quanxian318/jianwei-vibrometer/packages/README.md

# 代码归档

jianwei_code.rar 为 RAR5 归档，包含 PS、PL、Nano、APP、仿真、技能脚本、构建工程、板端文件、使用文档、报告 LaTeX 源码、Markdown 交互记录和协作资料。硬件 CAD、海报和视频分别保存在仓库对应目录。

code_manifest.json 给出归档内各文件的 SHA-256。
