quanxian318/jianwei-vibrometer/docs/speckle/README.md

# A4 黑白随机散斑打印图

用途：裁剪后粘贴到铝片表面，供视觉位移跟踪使用。图案随铝片一起运动；它是实体随机纹理，不是投影图案。

## 打印文件

推荐使用 [asset_a74faa9be8.pdf](asset_a74faa9be8.pdf)。三页均为 210×297 mm 的 A4，每页图案区为 190×260 mm。点阵不周期重复，图案区没有标题、边框、标尺或定位图标，方便任意裁剪。每页下方的 50 mm 标尺在图案区之外。

另有单页 [2 mm 粗点打印版](asset_6ad18eb660.pdf)，适合前三档在实际图像中过细时比较。比如 1280 px 的图像对应 500 mm 宽视野，2 mm 点约占 5.1 px，0.8 mm 点仅约 2.0 px。视野尚未确定时不能保证某一档适用；点径应按下方方法选择。点变大后数量会变少，黑白面积比例仍相同，并非单纯减少黑色面积。

| 页码 | 版本 | 标称点径 | 使用方式 |
|---|---|---|---|
| 1 | 细 | 0.5 mm | 近距离或图像中纹理较大时试用 |
| 2 | 中 | 0.8 mm | 可先打印这一页，放到实际相机距离下检查 |
| 3 | 粗 | 1.2 mm | 前两档在画面中过细时试用 |

每档点径在标称值的 85%–115% 范围内随机变化，矢量黑色面积约 42%，其余为白底；黑点位置随机且不相交。PDF 和 SVG 为矢量，PNG 是从最终 PDF 渲染的 600 dpi 纯黑白文件。预览图仅供屏幕查看，不用于打印。

打印选 A4、实际大小/100%，关闭“适合页面/缩放到可打印区域”，用黑白正常或高质量模式，关闭省墨。可先只打印第 2 页。打印后测量标尺是否为 50 mm，再裁剪图案区。

优先使用薄的哑光白色自粘纸或薄纸，贴平、贴牢，避免起皱、翘边和亮面胶带覆盖图案。铝片很薄时只贴需要跟踪的小块，减少附加质量和刚度对被测振动的影响。目标与静止背景应使用不同区域裁出的图案，背景贴到合适的独立参考物上。

## 根据相机选择点径

应以算法实际输入的图像为准，而不是以显示器放大后的预览为准。相关测量厂商建议每个散斑在相机图像中约占 3–5 个像素，可作为起始选择，之后检查本项目 ROI 的纹理、相关度和跟踪结果。[Correlated Solutions 点径说明](https://www.correlatedsolutions.com/speckle-size-generator)

近似关系：`散斑像素直径 = 打印点径(mm) × 图像宽度(px) ÷ 该平面视野宽度(mm)`。例如 1280 px 对应 250 mm 宽的平面视野时，0.8 mm 点约占 4.1 px。相机距离、分辨率、后续缩放及视角变化后需重新确认。三档都太细时应增大散斑或缩小视野，三档都太粗时应减小散斑或扩大视野；不要用放大显示界面代替实际采样检查。

散斑只能改善纹理条件，不会自动消除相机晃动、运动模糊或错误采样。它不是有保证精度的标定板；下方标尺用于检查打印比例。

## 文件和复现

- `asset_d55a451fa3.svg`、`asset_7f40fd2ca4.svg`、`asset_259baf5532.svg`：A4 矢量源图，图案位置与 PDF 对应。
- 同名 `*_600dpi.png`：纯黑白 A4 图，适用于只接受图片的打印软件；仍需按 A4、100% 打印。
- `asset_48d60db71a.png`：PDF 三页的缩略预览。
- `generate_speckles.py`：固定随机种子生成脚本，使用现有 Python、NumPy、Pillow、ReportLab、pypdf、pypdfium2；中文标题使用 Windows 楷体。
- `asset_de93f3cf92.json`：每档种子、点数、矢量/栅格覆盖率、页面尺寸、输出 SHA256。

已检查 PDF 共 3 页、A4 实际尺寸、中文标题、图案区栅格覆盖率和 600 dpi 输出尺寸；已查看 PDF 渲染版。散斑靶已用于整机振动测量，实测结果见 data/measurement_20261104.json。
