quanxian318/jianwei-vibrometer/hardware/netlists/README.md

# 网表文件怎么用

## 原始导出

本目录直接保存用户提供的5个文件，内容和文件名未改：主载板PCB 2026-10-20 ENET；主载板原理图、前面板原理图2026-10-19各一份ENET和TEL。

ENET是JSON结构，components按器件分组，props中Designator为位号，pinInfoMap记录针号、针名、网络。TEL是同次原理图的另一种文本导出。它们不含完整PCB走线几何，也不能证明铜皮实际连通或间距符合规则。

## 最新工程提取

两个PCB的连接网表JSON、逐引脚CSV和工程提取ENET均由最新.epro2内的PCB COMPONENT/PAD_NET/FOOTPRINT记录生成。前面板没有用户单独导出的PCB ENET，因此这里提供工程提取版并明确标注来源；没有冒充EDA菜单直接导出的文件。

JSON保存元件、封装和唯一电气引脚；全部物理焊盘CSV还保留重复编号的固定焊脚。主载板有808个物理焊盘记录、806个唯一元件针号；前面板57个物理焊盘、57个唯一针号。数字差别来自重复电气编号的物理焊盘，不表示漏针。

坐标单位mm，原生PCB坐标+Y向上、元件面俯视；不能直接当作背面看到的左右顺序。背面丝印和实际1脚见[主载板丝印](../../docs/carrier_pin_orientation.csv)及[逐脚接线](../../docs/wiring.md)。NC表示未连接，没有导线；GND机械固定脚仍算引脚。

## 已做的对照

最新工程两板PCB的全部863个唯一元件引脚，与用户原理图ENET逐一比较：位号、针号、网络一致。板载260个BOM位号、C编号及型号/设计值与原理图导出核对。J801的40针、Nano的30针及前面板10针按现有硬件契约检查。

这项检查没有重新计算EDA原理图图形的连接拓扑，也没有运行ERC或PCB DRC；最新原理图图形仍以原生工程打开检查。确认网表对应不等于装配、程序和实板必然正确。

## 查询示例

打开[逐引脚查询](pin_browser.html)，输入“主载板 J602”看NFC接口；输入“前面板 J101”看小板线束；输入“主载板 NANO_D2_TX”跟踪缓冲前后的实际网络。串阻、缓冲器两侧的网络不同，需要沿元件功能查看，不要把它们自动重命名为同一网。

同名自动网如$1N3、$3N14只能在对应PCB和这份版本中解释，不能跨版本猜用途。主载板J102-1=$1N3、J301-2=$3N14、J304-2=$3N28；后两者是MOS开关负端，并非GND。
