quanxian318/jianwei-vibrometer/report/project-case.md

# 见微大模型协作案例

## 双目预览与分工优化

团队围绕彩色预览、视差搜索范围与测点深度组织对照，按相同图像输入比较 PS 与 PL 结果。早期 PL 双目阶段完成 83 组逐位核对，零差异。整机资源调整后，辅助深度迁至 PS 的 160×90 Census 与两路径 SGM，PL 集中处理视频、声学与外设时序。

沉淀方法包括固定输入、绑定距离和相机配置、比较算法与显示结果，以及按功能范围统计资源。对应入口为[分工评审](../skill/partition_review/README.md)和[双目验证](../sim/reference/stereo/README.md)。

## 标定、基线与报警

标定比例用于像素到毫米的换算，停机基线用于区分设备振动与背景。团队按停机采基线、启动电机、测量、判级和打印组织完整操作。2026-11-04 实测中，峰峰值 0.2090 mm 高于 0.02 mm 报警阈值，红灯、蜂鸣器、语音与手机 APP 同步报警。

沉淀方法包括保存标定与布局信息、按有效波形判级、回读输出状态和记录实物结果。对应[实测记录](../data/measurement_20261104.json)与[测量核查技能](../skill/measurement-evidence/SKILL.md)。

## 语音与打印联调

十三条语音资源统一存放在 SD 卡，支持事件与命令调用。基线成功、测量完成和报警按流程播报；音量以同一条语音的 0% 与 40% 对照确认。打印采用独立 UART、CTS 流控、每 24 行光栅分段发送、排空及 120 ms 间隔，720 行测量报告输出正常。

该流程归纳为[外设分层检查](../skill/peripheral_diagnosis/README.md)，协作提示词与回答见[交互记录](interaction_records.md)。
