quanxian318/jianwei-vibrometer/report/source/sec2_llm.tex

\subsubsection{智能体协作过程和技能包}
\label{sec:llm}

\paragraph{协作方式。}开发阶段我们使用 OpenAI Codex 编码智能体，作品视频、海报与技术报告的整理使用 Claude Code 与 Codex。队员负责提出需求和约束、接线与上下电、万用表与示波器测量、摆放被测物，以及确认屏幕、报警灯、打印纸和喇叭的实际输出；智能体负责阅读源码、原理图、实现报告和运行日志，提出可以被证伪的假设，修改代码、执行构建与测试，并整理版本和证据。是否采纳某个方案、某项功能是否算完成，由队员结合实物状态决定。

\paragraph{智能体工作流设计。}经过多轮迭代，协作固定为图~\ref{fig:agentflow} 的流程。每个节点规定输入、执行方式、产物和放行条件，失败时回到指定节点。分工上，模型负责分流和解释，脚本负责确定性的比对和检查，队员负责上板和实物结论；涉及接线和供电的动作只由队员完成，智能体不把远程命令的返回值当作物理动作已经发生。每轮结束时记录版本、命令、退出码、产物路径、验证结果和未决事项，模型提出的修改与实际采用的步骤分开登记，以保留纠错轨迹。

\begin{figure}[htbp]
\centering
\resizebox{\linewidth}{!}{%
\begin{tikzpicture}[x=1cm,y=1cm]
\node[blk=psc,minimum width=2.7cm] (n1) at (0,0) {定义任务\\验收条件、预算、基线};
\node[blk=psc,minimum width=2.7cm] (n2) at (3.4,0) {功能验证\\参考实现 vs 设备};
\node[blk=psc,minimum width=2.7cm] (n3) at (6.8,0) {实现验证\\资源、时序、约束};
\node[blk=psc,minimum width=2.7cm] (n4) at (10.2,0) {实物验收\\采样、外设、装配};
\node[blk=psc,minimum width=2.7cm] (n5) at (13.6,0) {交付\\清单与哈希};
\node[blk=espc,minimum width=2.7cm] (m) at (3.4,-1.9) {模型\\分流、解释、假设};
\node[blk=ownc,minimum width=2.7cm] (s) at (6.8,-1.9) {脚本\\比对、审计、复跑};
\node[blk=extc,minimum width=2.7cm] (h) at (10.2,-1.9) {队员\\接线、上板、实物确认};
\draw[arr] (n1)--(n2); \draw[arr] (n2)--(n3); \draw[arr] (n3)--(n4); \draw[arr] (n4)--(n5);
\draw[arr,dashed] (n2.north) -- ++(0,0.45) -| node[pos=0.25,above,lbl]{差异按键定位、修正后同输入重跑} (n1.north);
\draw[arr,dashed] (n4.north) -- ++(0,0.75) -| node[pos=0.25,above,lbl]{软件通过但实物异常：按接口层、传输层、输出层分流} (n2.north east);
\draw[thick,draw=mute] (m.north) -- (n2.south);
\draw[thick,draw=mute] (s.north) -- (n3.south);
\draw[thick,draw=mute] (h.north) -- (n4.south);
\end{tikzpicture}}
\caption{智能体协作工作流}
\label{fig:agentflow}
\end{figure}

\paragraph{协作记录。}表~\ref{tab:cases} 汇总了开发中有代表性的协作片段。提示词为队员原话，模型回答中加引号的为原话，其余为过程摘要；每个案例都给出推翻原判断的证据和修正后的结论。

\begin{table}[htbp]
\centering
\caption{代表性协作片段}
\label{tab:cases}
\footnotesize
\renewcommand{\arraystretch}{1.3}
\begin{tabularx}{\linewidth}{@{}L{1.4cm}L{3.5cm}YL{3.1cm}@{}}
\toprule
\tabhead \tabh{主题} & \tabh{队员提示词} & \tabh{模型回答与纠错} & \tabh{结论与沉淀} \\
\midrule
资源划分 & “我们不打算用深度主负责测量了，双目深度只是一个辅助功能” & 依据实现报告精简独立 PL 深度核，保留双路采集、三路 VDMA、显示、PDM 和灯光链路，深度迁到 PS；资源按功能阶段分别列出，不当作同条件优化 & LUT 13655→8574，BRAM 41.5→30.5；沉淀为分工评审与优化对照预检 \\
频率搜索 & “你把搜索上限直接放宽到30HZ”；“不要动摄像头链路” & 先指出 45 帧/s 无法区分 30 Hz 与混叠；按约束只移除约 20.3 Hz 的旧截断，合成信号回归 7、21.6、22 Hz & 30 Hz 是搜索参数，采样边界仍约 22.5 Hz；沉淀为采样检查脚本 \\
打印输出 & “现在的Nano是新的固件，你不要改” & 为打印增加独立 UART，按 24 行分段发送，排空后间隔 120 ms，使用同一份 720 行报告复测 & 字形比例与报告输出正常；沉淀为外设分层检查清单 \\
语音播报 & “采集基线完也有语音播报声” & 对齐基线完成事件与 baseline\_done 资源，统一 SD 文件格式和播放任务回执 & 基线、测量与报警按流程播报 \\
音量控制 & 同一条语音的音量对照 & 比较 0\% 与 40\% 设置，队员确认“第一遍无声、第二遍有声” & 音量设置有效，界面提供试听入口 \\
双目预览 & 按目标距离组织图像对照 & 保存同帧彩色图像、搜索参数和匹配结果，按相同输入比对计算 & 距离参考与彩色预览正常，保留版本化验证记录 \\
报警链路 & 测量框调整后的标定与基线操作 & 区分尺标比例和停机基线，按停机、采基线、启动、测量和判警执行；队员确认“红灯亮，蜂鸣器响” & 报警灯、蜂鸣器、语音和 APP 同步输出 \\
时序复核 & “按照最新工程，这些数据应该是多少” & 读取最新布线报告：WNS +0.756 ns，同时列有 592 个无时钟项和 1132 个未约束端点 & 表述限定为“已约束路径时序通过”；沉淀为 Vivado 报告审计脚本 \\
视频时长 & “然后把控一下时长，控制在3分钟。” & 同步编排场景、原声和旁白，按最终时长封装并用 ffprobe 检查 & 完整视频 179.633 s \\
\bottomrule
\end{tabularx}
\end{table}

频率搜索参数的协作记录如下。

\begin{notebox}[频率搜索范围：提示与执行结果]
\small
\textbf{队员：}“你把搜索上限直接放宽到30HZ”\par
\textbf{队员：}“不要动摄像头链路，就单纯放宽那个上限，不要出现测到了对的频率又被舍去的情况”\par\smallskip
\textbf{执行摘要：}保留相机采集链路，将软件搜索参数设为 30 Hz，结合实测采样率和奈奎斯特边界检查选择有效频点。\par
\textbf{验证结果：}7 Hz、21.6 Hz 和 22 Hz 合成位移在两个初始相位下通过频率与幅值检查，采样连续性和基线采样率检查一并执行。
\end{notebox}

语音联调统一了资源文件、事件映射和播放回执。基线成功后播放 baseline\_done，测量完成与报警采用对应提示。音量使用同一条语音的 0\% 与 40\% 对照确认，SD 文件读回校验和现场播放结果一并归档。打印采用分段光栅传输，720 行报告输出正常。

\paragraph{技能包的提炼过程。}按照赛题要求，我们把协作中反复出现的判断方法提炼为 \code{skill/} 目录下的技能包（表~\ref{tab:skills}）。每项技能保留适用任务、输入文件、执行步骤和输出格式；将常用判断写成脚本，并用正例、反例和错误输入检查退出码。这样，后续遇到相同问题时，可以直接复用已有的检查方法。

\begin{table}[htbp]
\centering
\caption{技能包内容、来源与验证}
\label{tab:skills}
\footnotesize
\renewcommand{\arraystretch}{1.28}
\begin{tabularx}{\linewidth}{@{}L{2.7cm}L{1.8cm}L{3.5cm}Y@{}}
\toprule
\tabhead \tabh{技能} & \tabh{类型} & \tabh{来源} & \tabh{已验证效果} \\
\midrule
FPGA 大模型协作 & 提示词工作流 & 全部协作案例 & 划分、契约、纠错、PPA、验收五类提示词模板与交接单 \\
软硬件划分评审 & 提示词工作流 & PL 深度核迁移 & 按功能列出资源开销，复现 LUT 13655→8574 的划分过程 \\
测量证据复核 & 提示词工作流 & 帧率混用、纹理不足、名义标定 & 从采样率、跟踪质量、基线和标定四项检查结果有效性 \\
机电装配复核 & 提示词工作流 & 预览件与打印件混用 & 打印清单与遮挡项标记与交付记录一致 \\
定点黄金比对 & 校验脚本 & 双目核 83 次 PS/PL 逐位核对 & 合成样例分别得到通过、差异与缺项、格式错误三种退出码 \\
Vivado 报告审计 & 校验脚本 & 正 WNS 被误写为“时序全部收敛” & 从报告提取资源与 WNS/WHS，并识别 592 个无时钟项 \\
采样检查 & 校验脚本 & 22 Hz 峰被 $0.45f_s$ 截断 & 45/22/30 通过并提示近边界，45/30/30 拒绝 \\
接口、优化、复现对照 & 校验脚本 & 地址表混用、跨阶段对比、版本错配 & 三组正例退出 0，反例退出 1 并指出字段，缺字段退出 2 \\
交付校验 & 校验脚本 & 打包后文件与版本错配 & 逐文件 SHA256，拒绝路径穿越与非 ASCII 文件名 \\
外设分层诊断 & 踩坑清单 & 打印分段、语音映射、音量、触屏 & 分段打印、资源校验与音量对照流程 \\
通用 PYNQ\cite{pynq} Overlay & 案例模板 + 校验脚本 & 本项目的寄存器契约与 DMA 调试经验 & 契约校验、板端测试脚本生成、HWH 实例预检、RTL 位精确仿真 \\
\bottomrule
\end{tabularx}
\end{table}

通用 PYNQ 技能围绕 Overlay、寄存器和简单模式 AXI DMA 组织。JSON 契约记录 DMA 与 IP 实例、数据类型、长度和控制偏移；脚本据此生成板端测试程序，并预检 HWH 中的实例名。配套示例提供确定性输入、黄金输出和带背压的 AXI4-Stream 测试平台，便于定位长度、TLAST 和数据排列问题。换用其他算子时修改 RTL 与黄金函数，换板时重新生成对应的 bit/HWH 文件。现有验证包含离线契约检查和 RTL 仿真。

\FloatBarrier
