quanxian318/jianwei-vibrometer/report/source/main.tex

% 见微：基于 AMD Zynq-7010 的非接触多点视觉测振仪 技术报告
% 编译：xelatex main.tex 两遍（Windows 字体：宋体、黑体、楷体、Noto Sans SC、Times New Roman、Arial、Consolas）
\documentclass[UTF8,fontset=none,a4paper,zihao=-4]{ctexart}

\setCJKmainfont{SimSun}[BoldFont=SimHei,ItalicFont=KaiTi]
\setCJKsansfont{Noto Sans SC}[BoldFont={Noto Sans SC Bold}]
\setCJKmonofont{SimHei}
\setCJKfamilyfont{kai}{KaiTi}
\newcommand{\kai}{\CJKfamily{kai}}
\setmainfont{Times New Roman}
\setsansfont{Arial}
\setmonofont{Consolas}[Scale=0.9]

\usepackage[a4paper,left=24mm,right=24mm,top=27mm,bottom=25mm,headheight=30pt,headsep=8mm]{geometry}
\usepackage{graphicx,float,placeins,booktabs,longtable,array,tabularx,multirow,makecell}
\usepackage{amsmath}
\usepackage{newtxmath}
\usepackage{bm}
\usepackage[table]{xcolor}
\usepackage{caption,subcaption}
\usepackage{fancyhdr,enumitem,tcolorbox}
\usepackage{tikz}
\usetikzlibrary{arrows.meta,positioning,shapes.geometric,shapes.misc,fit,calc,backgrounds,decorations.pathreplacing}
\usepackage{pgfplots}
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
\usepackage{listings}
\usepackage{xurl}
\usepackage[hidelinks,bookmarksnumbered]{hyperref}

% ---------------------------------------------------------------- 配色
\definecolor{navy}{HTML}{17375E}
\definecolor{ink}{HTML}{262626}
\definecolor{mute}{HTML}{6B7280}
\definecolor{axred}{HTML}{C0392B}
\definecolor{amber}{HTML}{D99A00}
\definecolor{plc}{HTML}{F7DAD6}
\definecolor{psc}{HTML}{D9E6F4}
\definecolor{espc}{HTML}{DDEFD9}
\definecolor{ownc}{HTML}{FFF0C4}
\definecolor{extc}{HTML}{EEEEEE}
\definecolor{band}{HTML}{F3F6FA}
\definecolor{rulec}{HTML}{9AA7B8}

% ---------------------------------------------------------------- 标题层级
\ctexset{
  section={name={第,部分},number=\chinese{section},format=\rmfamily\bfseries\zihao{3}\color{ink},
           aftername=\hspace{0.8em},beforeskip=2pt,afterskip=16pt},
  subsection={number=\arabic{section}.\arabic{subsection},format=\rmfamily\bfseries\zihao{4}\color{ink},
              beforeskip=16pt plus 3pt,afterskip=8pt},
  subsubsection={number=\arabic{section}.\arabic{subsection}.\arabic{subsubsection},
                 format=\rmfamily\bfseries\zihao{-4}\color{ink},beforeskip=12pt plus 2pt,afterskip=6pt},
  paragraph={format=\kai\bfseries\color{ink},runin=true,afterskip=0.6em,beforeskip=6pt}
}
\setcounter{secnumdepth}{3}
\setcounter{tocdepth}{2}
\counterwithin*{figure}{section}
\counterwithin*{table}{section}
\counterwithin*{equation}{section}
\renewcommand{\thefigure}{\arabic{section}.\arabic{figure}}
\renewcommand{\thetable}{\arabic{section}.\arabic{table}}
\renewcommand{\theequation}{\arabic{section}.\arabic{equation}}
\captionsetup{font=small,labelfont={bf,color=navy},labelsep=quad,skip=6pt}
\captionsetup[sub]{font=footnotesize,labelfont={bf},skip=3pt}
\renewcommand{\arraystretch}{1.25}
\setlength{\parskip}{2pt plus 1pt}
\linespread{1.32}
\setlist{nosep,leftmargin=2.2em,itemsep=2pt}
\setlength{\emergencystretch}{3em}
\raggedbottom
\makeatletter
\setlength{\@fptop}{0pt}
\setlength{\@fpsep}{12pt plus 2fil}
\setlength{\@fpbot}{0pt plus 1fil}
\makeatother
\renewcommand{\topfraction}{0.9}
\renewcommand{\textfraction}{0.08}
\renewcommand{\floatpagefraction}{0.75}

% ---------------------------------------------------------------- 页眉页脚
\newcommand{\reportheader}{%
  \fancyhf{}%
  \fancyhead[C]{}%
  \renewcommand{\headrulewidth}{0.35pt}%
  \renewcommand{\headrule}{\color{mute}\hrule height \headrulewidth}%
  \fancyfoot[C]{\small\rmfamily\color{ink}\thepage}%
}
\pagestyle{fancy}
\reportheader
\fancypagestyle{plain}{\reportheader}

% ---------------------------------------------------------------- 常用样式
\newcommand{\figpath}{figures}
\newcommand{\code}[1]{\texttt{\small #1}}
\newcolumntype{L}[1]{>{\raggedright\arraybackslash}p{#1}}
\newcolumntype{C}[1]{>{\centering\arraybackslash}p{#1}}
\newcolumntype{Y}{>{\raggedright\arraybackslash}X}
\newcommand{\tabh}[1]{\textbf{\sffamily #1}}
\newcommand{\tabhead}{\rowcolor{band}}
\newtcolorbox{notebox}[1][]{colback=band,colframe=rulec,boxrule=0.4pt,arc=1.5pt,left=8pt,right=8pt,top=5pt,bottom=5pt,
  fonttitle=\sffamily\bfseries\small,coltitle=navy,colbacktitle=band,title={#1},before skip=8pt,after skip=8pt}
\lstset{basicstyle=\ttfamily\small,columns=fullflexible,keepspaces=true,frame=single,rulecolor=\color{rulec},
  backgroundcolor=\color{band},xleftmargin=4pt,xrightmargin=4pt,aboveskip=6pt,belowskip=6pt,breaklines=true,
  showstringspaces=false}

% TikZ 公共样式：红=AX7010/PL，蓝=PS，绿=ESP32，黄=自研硬件，灰=外部设备
\tikzset{
  blk/.style={draw=#1!70!black,fill=#1,rounded corners=2pt,align=center,font=\footnotesize\linespread{1.05}\selectfont,inner sep=3pt,minimum height=8mm},
  blk/.default=extc,
  arr/.style={-{Stealth[length=2.4mm]},thick,draw=ink},
  darr/.style={{Stealth[length=2.2mm]}-{Stealth[length=2.2mm]},thick,draw=ink},
  lbl/.style={font=\scriptsize\linespread{1.0}\selectfont,text=mute},
  grp/.style={draw=#1,dashed,rounded corners=4pt,inner sep=6pt},
}

\begin{document}

% ================================================================ 封面
\begin{titlepage}
\newgeometry{left=20mm,right=20mm,top=22mm,bottom=20mm}
\thispagestyle{empty}
\noindent\makebox[\linewidth][c]{}\par
\vspace{1mm}
\noindent{\color{mute}\rule{\linewidth}{0.35pt}}\par
\vspace{11mm}
\setlength{\parindent}{0pt}
{\rmfamily\bfseries\color{ink}\fontsize{32}{40}\selectfont 见微\par}
\vspace{4mm}
{\rmfamily\bfseries\color{ink}\zihao{-2} 基于 AMD Zynq-7010 的\\[2mm]非接触多点视觉测振仪\par}
\vspace{3mm}
{\rmfamily\color{ink}\normalsize JianWei: Non-contact Multi-point Vision Vibrometer on AMD Zynq-7010\par}
\vspace{10mm}
{\rmfamily\bfseries\color{ink}\zihao{3} 技术报告\par}
\vspace{10mm}
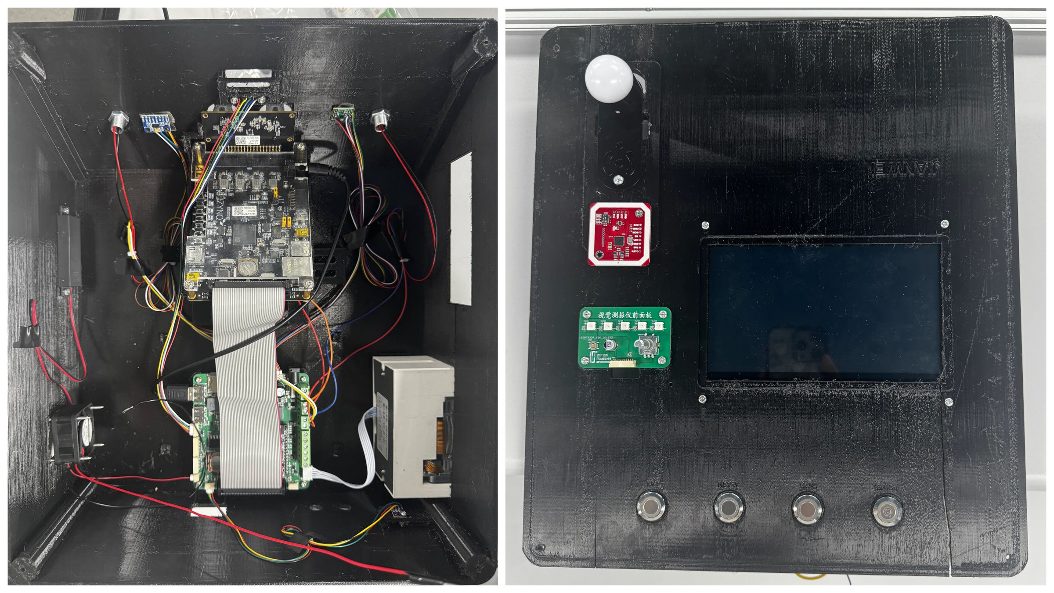
[picture p60: report/source/figures/photo/overview.jpg]
\noindent\par
\vfill
{\sffamily\small\color{ink}
\begin{tabular}{@{}ll@{}}
核心器件 & AMD Zynq-7000 XC7Z010（ALINX AX7010） \\
开源地址 & \url{https://github.com/quanxian318/jianwei-vibrometer} \\
日\qquad 期 & 2026 年 11 月 \\
\end{tabular}\par}
\restoregeometry
\end{titlepage}

% ================================================================ 摘要
\pagenumbering{Roman}
\thispagestyle{plain}
\begin{center}{\rmfamily\bfseries\zihao{3}\color{ink} 摘\quad 要}\end{center}
\vspace{2mm}
\input{sec0_abstract}

\clearpage
\thispagestyle{plain}
{\hypersetup{linkcolor=ink}\tableofcontents}
\clearpage
\pagenumbering{arabic}

\input{sec1_overview}
\input{sec2_system}
\input{sec2_hardware}
\input{sec2_software}
\input{sec2_llm}
\input{sec3_results}
\input{sec4_summary}

\end{document}
