quanxian318/jianwei-vibrometer/skill/mechanical-fit/SKILL.md

---
name: mechanical-fit
description: Review CAD enclosure fit and photo-based assembly claims against revision-specific print files and visible hardware evidence.
---

## 适用与使用

用于由 CAD、STL 和实物照片交叉核对的装配交付。输入装配版本、打印文件清单、孔和紧固件规格、线束路径、干涉记录及照片。

> 为每个接口列出配合零件、紧固路径、工具可达方向、线束弯曲和拆装余量。给每项标注依据是 CAD、照片或实物试装。对照片中遮挡的连接标记待确认。逐项区分供打印的实体和只用于预览的参考模型。输出证据位置、检查结论及仍需试装的项目。

## 项目案例与边界

V17 交付记录将三份打印件与预览中的参考外设分开，并用 CAD 核对新增灯支架区。重新查看振动装置全景图，可确认板端两颗固定螺钉、散斑区和轴端配重，电机本体紧固点仍被遮挡。按模板复核这两项，得到打印清单和遮挡项标记，与已有交付记录一致。

方法源于预览实体与打印件容易混用，以及局部照片容易让人误画连接。网格闭合与 CAD 无意外干涉只支持数字模型，材料收缩、真实配合和工具可达性仍由实物试装验证。缺少比例基准的照片仅用于识别可见关系。
