quanxian318/jianwei-vibrometer/THIRD_PARTY_NOTICES.md

# Third-party materials

The root MIT license covers original Jianwei code, design documents and authored assets.
Existing copyright and license notices in third-party components remain applicable.

- AMD/Xilinx IP definitions and generated IP metadata under `build/vivado/ip_repo` retain their embedded vendor notices and terms. Building uses the installed Vivado IP catalog and its licenses.
- ALINX camera/reference-design components retain their source notices.
- `src/ax7010/linux/vibmon/third_party` and platform SDK dependencies retain their own licenses.
- The poster retains the AMD competition template and AMD branding.
- The industrial gauge footage in the demonstration video is Pexels video 40481917, used under the Pexels License: https://www.pexels.com/license/ .
- Hardware CAD module envelopes and vendor reference models retain embedded attribution where present.
