quanxian318/jianwei-vibrometer/docs/capture_freeze.md

# 采集与双目优化记录

早期 PL 双目阶段完成了采集链路与 PS/PL 逐位核对。该阶段以 256×144 分辨率分段搜索视差，板端诊断每 4 帧执行一次复算，累计 83 次核对、零差异。四秒观察发布 7 幅深度结果，采集保持约 45 帧/s。

后续将辅助深度迁入 PS，采用 160×90 Census 与两路径 SGM，视频、声学和外设继续由 PL 提供时序支持。当前测振使用 12 个测点与 4 个参考点。

[资源与实现报告](../build/vivado/README.md)、[当前算法](current/algorithm_status.md)、[实测记录](../data/measurement_20261104.json)。
