quanxian318/jianwei-vibrometer/docs/interface_review.md

# AX7010、Nano 与 APP 接口

三侧按统一协议完成数据与命令交互。AX7010 负责测量和主记录，Nano 提供外设服务与网关，APP 提供手机和电脑界面。

| 链路 | 参数与职责 |
|---|---|
| APP 直连 AX7010 | HTTP 8080，/api/v1，UDP 48300 发现 |
| APP 经 Nano 网关 | ESP32 HTTP 80，命令转发与结果轮询 |
| AX7010 与 Nano | 115200、8N1、RTS/CTS，协议 V1 |
| 状态发布 | 会话建立后发布主题，重连时重新发布 |
| 测量记录 | 主频、峰峰值、有效值、声学结果、判级与阈值 |
| 外设事件 | NFC、语音、SD、网络与掉电事件由 Nano 队列返回 |

局域网直连提供相机预览、完整记录与原始文件，网关提供紧凑状态、最近记录和抽稀曲线。

声学详情展示主频及与视觉的一致、谐波或不同关系。设置变更经命令接口提交后回读设备状态。基线、测量与报警流程在屏幕、APP、语音和声光输出间同步。

[接口协议](ps_nano_protocol.md)、[APP 操作](app_guide.md)、[板端运行](../board/README.md)。
