quanxian318/jianwei-vibrometer/docs/ax7010_pins.md

# AX7010 J801—J11逐针对照

两端按电气编号1→1、2→2……40→40直通；凹槽方向与电气编号分别核对。方向以AX为参照。

| 针号 | 网络 | HDL端口 | FPGA封装脚 | AX方向 | 初始要求 |
|---|---|---|---|---|---|
| 1 | GND |  |  | 电源/地/保留 |  |
| 2 | NC |  |  | 电源/地/保留 |  |
| 3 | LED1_PWM | led1_pwm | F17 | 输出 | PWM/数据低 |
| 4 | LED2_PWM | led2_pwm | F16 | 输出 | PWM/数据低 |
| 5 | FP_KEY | k1 | F20 | 输入 |  |
| 6 | WS_DATA | ws_data | F19 | 输出 | PWM/数据低 |
| 7 | TOF_INT | tof_int | G20 | 输入 |  |
| 8 | RTC_1HZ | rtc_1hz | G19 | 输入 |  |
| 9 | AX_PFAIL_N | pfail_n | H18 | 输入 |  |
| 10 | EXP_INT_N | exp_int_n | J18 | 输入 |  |
| 11 | I2C0_SCL | i2c0_scl | L20 | 开漏双向 |  |
| 12 | I2C0_SDA | i2c0_sda | L19 | 开漏双向 |  |
| 13 | I2C1_SCL | i2c1_scl | M20 | 开漏双向 |  |
| 14 | I2C1_SDA | i2c1_sda | M19 | 开漏双向 |  |
| 15 | TACH_IN | tach_in | K18 | 输入 |  |
| 16 | ENC_SW | enc_sw | K17 | 输入 |  |
| 17 | ENC_A | enc_a | J19 | 输入 |  |
| 18 | ENC_B | enc_b | K19 | 输入 |  |
| 19 | ESP_TXD | esp_txd | H20 | 输出 | UART空闲高 |
| 20 | ESP_RXD | esp_rxd | J20 | 输入 |  |
| 21 | ESP_RTS | esp_rts | L17 | 输出 |  |
| 22 | ESP_CTS | esp_cts | L16 | 输入 |  |
| 23 | ESP_IRQ | esp_irq | M18 | 输入 |  |
| 24 | PRN_TXD | prn_txd | M17 | 输出 | UART空闲高 |
| 25 | PRN_RXD | prn_rxd | D20 | 输入 |  |
| 26 | PRN_CTS | prn_cts | D19 | 输入 |  |
| 27 | ADXL_CS | adxl_cs | E19 | 输出 | 片选高 |
| 28 | ADXL_DRDY | adxl_drdy | E18 | 输入 |  |
| 29 | IMU_CS | imu_cs | G18 | 输出 | 片选高 |
| 30 | IMU_INT1 | imu_int1 | G17 | 输入 |  |
| 31 | IMU_INT2 | imu_int2 | H17 | 输入 |  |
| 32 | I2C2_SCL（PDM CLK） | mic_clk | H16 | 推挽输出 | 2MHz；禁用时低 |
| 33 | I2C2_SDA（PDM DAT） | mic_dat | G15 | 输入 | 麦克风数据 |
| 34 | SPI_MISO | spi_miso | H15 | 输入 |  |
| 35 | SPI_SCLK | spi_sclk | J14 | 输出 |  |
| 36 | SPI_MOSI | spi_mosi | K14 | 输出 |  |
| 37 | GND |  |  | 电源/地/保留 |  |
| 38 | GND |  |  | 电源/地/保留 |  |
| 39 | AX_3V3_RAW |  |  | 电源/地/保留 |  |
| 40 | AX_3V3_RAW |  |  | 电源/地/保留 |  |
