quanxian318/jianwei-vibrometer/src/nano_esp32/bin/firmware_status.md

# 当前固件状态

Nano ESP32 **0.2.3** 于2026-11-02编译通过，包含十三个语音资源ID，新增七条操作提示，保留0.2.2的NFC诊断和原有保护。应用镜像Checksum及Validation Hash有效；输入和产物SHA256见[构建验证](../../../data/nano_build_validation.json)。

Sketch uses 973865 bytes (30%) of program storage space. Maximum is 3145728 bytes.；Global variables use 103276 bytes (31%) of dynamic memory, leaving 224404 bytes for local variables. Maximum is 327680 bytes.

当前 0.2.3 已烧录并完成 USB 命令应答与整机联调，十三条语音资源已写入 J603 语音卡的 /voice 目录并完成读回校验。基线、测量和报警语音按事件调用，NFC 与 SD 通过独立片选共用 SPI 总线。

板型Arduino Nano ESP32 ABX00083，板包2.0.18-20240930.arduino3，Pin Numbering默认Arduino、USB TinyUSB、默认分区。按[固件README](../../../docs/nano_build.md)编译或烧录。分段BIN、ELF和匹配分区见本目录，不能不带对应地址混写。
