quanxian318/jianwei-vibrometer/media/poster_en.pptx

JianWei: Non-contact Multi-point
Vision Vibrometer on AMD Zynq-7010

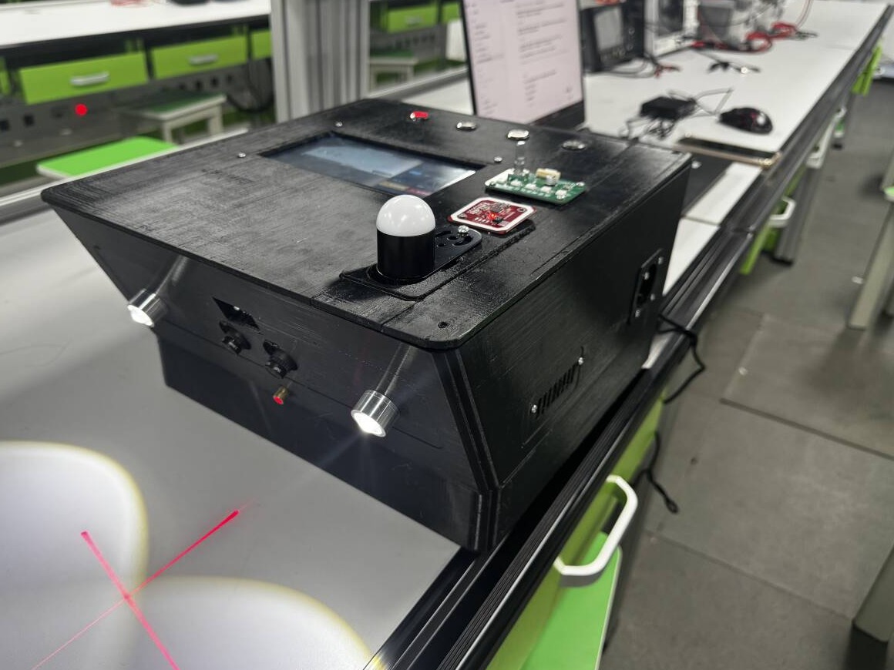
[picture p61: figure]
见微整机实物

On board test by AMD Zynq-7010

INTRODUCTION

Early faults can cause vibration too small to see. Contact sensors require mounting and wiring at each point. JianWei measures multiple points without contact and reports abnormal vibration directly on site.


Dual camera
AN5642

AMD Zynq-7010 (ALINX AX7010)

PL

Dual-camera capture

PS

Multi-point tracking

7-inch screen

HDMI display

PDM mic receiver

FFT and baseline gate

Stereo ranging

Alarm light

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
19.95 Hz
visual frequency

100

Signal-to-baseline ratio per point

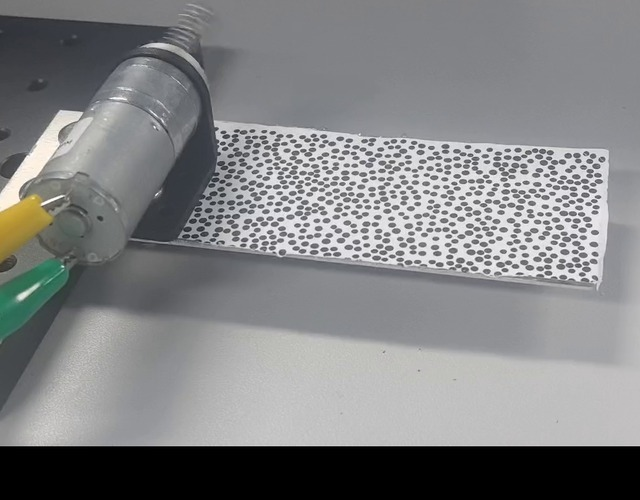
[picture p63: figure]
Vibratingtarget

Vibrating
target

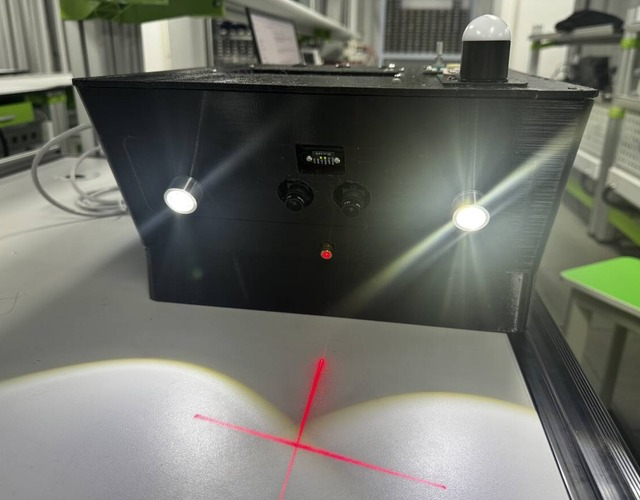
[picture p64: figure]
JianWeiunit

JianWei
unit

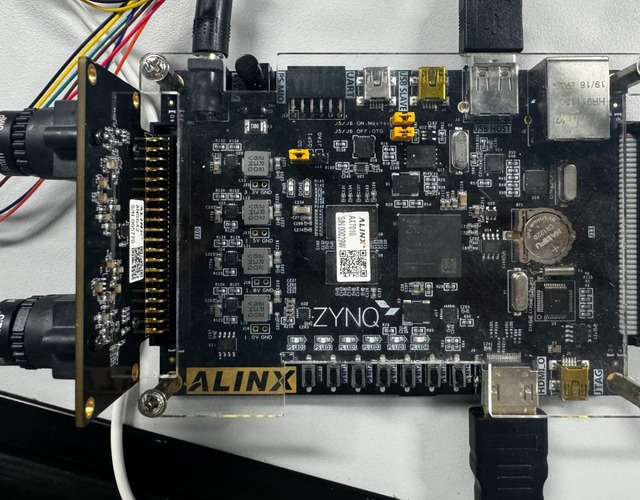
[picture p65: figure]
Zynq-7010analysis

Zynq-7010
analysis

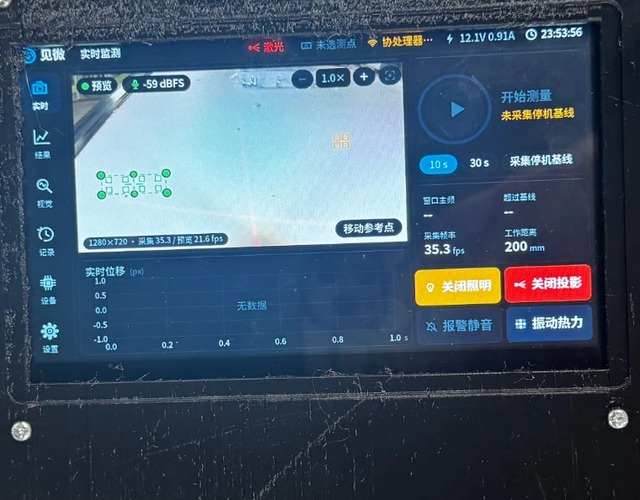
[picture p66: figure]
Screen, alarm,printer

Screen, alarm,
printer

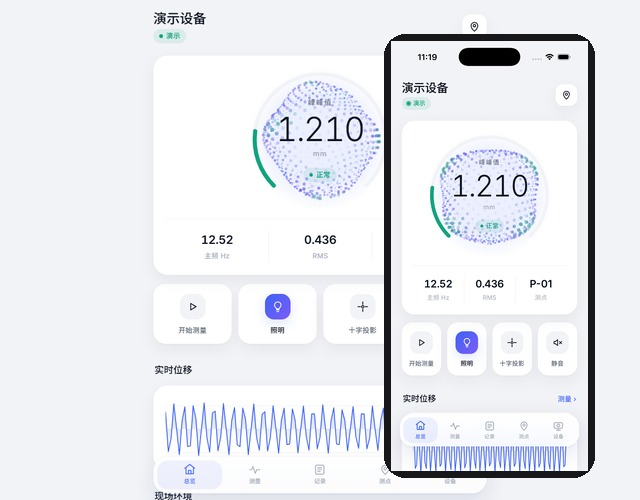
[picture p67: figure]
Phone andPC app

Phone and
PC app

Light and printer I/O

UI, records, alarm

UART

LAN

Printer

Phone and PC app
LAN or hotspot

19.93 Hz
microphone check

50

Measurement chain

An ALINX AX7010 board (AMD Zynq-7010) is the core, with an AN5642 dual camera, a self-designed carrier board and front panel, and an Arduino Nano ESP32 coprocessor, all in a 3D-printed enclosure.

Key technical issues addressed:
1. Video front end in PL: dual-camera capture, frame buffering and HDMI display.
2. Multi-point tracking on PS: up to 12 points with 25×25 templates; 4 background references remove camera shake.
3. Decision: 128-frame Hann FFT for frequency and amplitude, gated at 3× a motor-off baseline before alarm.
4. Peripheral interfaces: PDM microphone, light PWM, cross laser, printer UART, plus IMU, ToF, accelerometer and SHT40 ports.

Carrier board
sensors, lights, laser

System Architecture

Key innovations:
1. One camera, many points: no contact, no wiring on the machine.
2. Background references cancel camera shake; a 3× motor-off baseline gate stops false alarms.
3. A PDM microphone received in PL checks the frequency from sound alone.
4. PL runs video and I/O timing, PS runs analysis and UI, ESP32 serves NFC, voice and Wi-Fi.

Self-designed hardware:
1. 100×100 mm carrier board: 12 V power, power monitor, RTC, I/O expander, all connectors.
2. 60×40 mm front panel: rotary encoder, key, five WS2812 LEDs.
3. 3D-printed enclosure for cameras, lights, laser and printer.

Nano ESP32
NFC, voice, Wi-Fi

0.209 mm
peak-to-peak, trial scale

12 / 12
points above baseline

3×

Board test, 2026-11-04

Board test. A gear motor shakes a speckle-printed plate. After a 15 s motor-off baseline, a 10 s run captured 452 frames at 45 fps with no drops or tracking loss. All 12 points passed the 3× gate; 0.209 mm peak-to-peak (trial scale) exceeded the 0.02 mm threshold and set off the alarm light, buzzer and app.
Microphone check. The PDM microphone heard 19.93 Hz, 0.02 Hz from the visual 19.95 Hz.
Performance. Capture at 45.05 fps with 0.42 ms frame jitter. PL: 50.8% LUT, 41.0% FF, 50.8% BRAM, +0.756 ns slack. About 9.3 W from 12 V.
Outlook. Move sub-pixel tracking to PL using the bit-verified LK accumulator to increase multi-point throughput. Quantify displacement error through checkerboard calibration and tests at known vibration amplitudes.

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
