quanxian318/jianwei-vibrometer/docs/datasheets/README.md

# 模块数据手册

- [adxl345](adxl345.pdf)
- [lsm6dsv](lsm6dsv.pdf)
- [mp34dt01](mp34dt01.pdf)
- [pn532](pn532.pdf)
- [pn532_module](pn532_module.pdf)
- [sht4x](sht4x.pdf)
- [vl53l1x](vl53l1x.pdf)
