quanxian318/jianwei-vibrometer/hardware/enclosure/preview/README.md

# V17：原配三色灯金属支架安装位

解压后保留SW与STEP所有文件一起。
- V17_Installed_Estimate.SLDASM：整机预估装配，含简化金属支架外形参考。
- V17_Printable_Shell.SLDASM：打印件装配。
- V17_02_Original_Alarm_Bracket_Lid.SLDPRT/.step：本次更新的顶盖。

原生文件由SOLIDWORKS 2026保存。金属支架参考仅表示约119.8×39.8mm包络、安装布局和名义2mm厚度，不是供应商精确模型；灯本体未新增到预览中。本次只修改顶盖，底壳和垫柱STL与V16完全相同。正式打印只使用另一文件夹的三个STL。
