quanxian318/jianwei-vibrometer/report/interaction_records.md

# 协作交互选摘及证据索引

以下队员提示词取自当前会话；模型回应采用过程摘要，除引号内明确标注的摘录外，不作为逐字对话导出。正式提交应补充平台导出的原始会话及原始日志。代码与原实现报告另见项目工程包。

| 案例 | 队员提示词摘录 | 模型回应与执行摘要 | 反馈及纠错 | 对应证据 |
|---|---|---|---|---|
| 资源划分 | “我们不打算用深度主负责测量了，双目深度只是一个辅助功能” | 分析PL资源并精简独立深度核，保留采集和显示，使用PS辅助深度 | 资源以不同实现阶段分别列出，约束警告未消除 | PL精简记录；最终printer_uart资源/时序报告 |
| 打印独立链路 | “现在的Nano是新的固件，你不要改” | 保留Nano固件和UART链路，为打印增加独立UART | 用户反馈分条发送、排空与间隔控制后，720 行测量报告打印正常 | 打印串口恢复与走纸修正记录、UART测试、打印照片 |
| 频率搜索 | “你把搜索上限直接放宽到30HZ”；“不要动摄像头链路” | 读取45fps记录、21.6Hz频谱与1320rpm信息，修改搜索截断，执行合成信号回归 | 明确30Hz软件上限不等于当前相机具备30Hz测量能力 | test_vibration_band、实际测量记录及频率修正说明 |
| 语音播报 | “采集基线完也有语音播报声” | 对齐操作事件、SD 语音文件和播放回执 | 基线、测量和报警提示按流程正常播放 | 资源哈希、流程录像和现场播放 |
| 音量对照 | 同一条语音的 0% 与 40% 对照 | 用同一条正常语音比较0%和40%，不指定独立固定测试音量 | 队员确认“第一遍无声、第二遍有声”；新增下一条生效提示和试听入口 | 音量对照记录、设置页渲染与交互测试 |
| 时序复核 | “按照最新工程，这些数据应该是多少” | 读取最新已布线报告，核对资源与WNS/WHS | 将表述限定为已约束路径通过，保留no_clock/未约束端点等信息 | utilization.rpt、timing.rpt、当前报告核查技能 |

应归档内容：原始对话、相关版本/哈希、代码差异、测试输入输出、仪器读数、照片或视频的原文件及采集条件。用户反馈不替代完整物理测量，但能直接反驳与实际输出不符的模型推断。

## 会话逐字选摘

以下选摘来自当前协作会话，保留原有表述；完整上下文以原始会话导出为准。

### 频率搜索参数

队员：“你把搜索上限直接放宽到30HZ”

队员：“不要动摄像头链路，就单纯放宽那个上限，不要出现测到了对的频率又被舍去的情况”

执行摘要：保留相机链路，将软件搜索参数设为 30 Hz，结合实测帧率与奈奎斯特边界选择频点。7、21.6、22 Hz 的合成位移回归通过。

### 语音事件与资源映射

队员：“采集基线完也有语音播报声”

执行结果：基线成功对应 baseline_done，测量结束与报警按结果选择语音。十三条 SD 资源完成读回校验，事件与命令使用统一的播放接口。

### 音量对照的实物反馈

队员：同一条语音的 0% 与 40% 对照

智能体询问：

> 刚才对比播放中，第一遍设为0%应无声，第二遍40%应听到“测量完成”。实际是哪种情况？

队员：“第一遍无声、第二遍有声”

后续结论：接口与音量传递可生效，设置作用于下一条播放任务；界面补充试听与生效说明。
