quanxian318/jianwei-vibrometer/report/consolidation.md

# 归并记录

两份提交 ZIP 提供五项专项、FPGA 协作总入口和 PYNQ 移植技能。先前见微技能包补充定点校验、测量证据、机电装配和工具速查。独立协作 Markdown 与包内版本比较，有差异时并列保留。最新代码 ZIP 经完整性检查，469 个条目未发现独立 Skill 入口，保留为单独工程材料。

旧版 PL 双目核的 83 次核对属于历史案例。最新协作材料描述将辅助深度改到 PS 后的架构，按各自版本引用。PYNQ 保留离线与 RTL 仿真记录，工具命令、输入输出和失败分支统一在 skill/workflow-guide.md 中说明。

本轮重跑专项单测、定点校验正反例和 PYNQ 契约生成，生成脚本通过语法检查。命令与实际输出见 consolidation_validation.json。归并件清单单独计算 SHA256。
