quanxian318/jianwei-vibrometer/report/submission-checklist.md

# AMD 自主选题提交项索引

初级组，XC7Z010，Vivado 2025.2。

| 提交项 | 入口 |
|---|---|
| 完整源码与工程 | src/、build/vivado/、hardware/ |
| 仿真与验证 | sim/run_host.sh、sim/run_rtl.sh、sim/results/ |
| 综合与实现报告 | build/vivado/reports_original_build/ |
| 上板文件与实测结果 | board/、data/measurement_20261104.json |
| 可复现构建 | build/build_ps.sh、build/vivado/create_project.tcl |
| 技能包及使用方法 | skill/README.md |
| 提示词、回答与纠错记录 | report/interaction_records.md |
| 技能提炼与验证 | report/agent_collaboration_and_skills.md、sim/results/skill_validation/ |
| 设计报告与优化对比 | report/technical_report.pdf |
| 视频与英文海报 | media/jianwei_demo.mp4、media/poster_en.pptx |
| 全部代码归档 | packages/jianwei_code.rar |
| 开源许可 | LICENSE、THIRD_PARTY_NOTICES.md |
