quanxian318/jianwei-vibrometer/skill/fpga-llm-collaboration/SKILL.md

---
name: fpga-llm-collaboration
description: 组织 FPGA 或 SoC 项目的大模型协作，适用于 PS/PL 方案评审、跨工具故障定位、性能对照和赛题协作证据整理。
---

读取用户本轮目标、实际器件、已有源码与日志。只打开当前任务需要的参考：

| 当前任务 | 加载 | 交付 |
|---|---|---|
| 从算法划分 PS/PL 或审查接口 | [工作流与提示词](references/workflows.md) | 接口契约、数据搬运预算和可证伪的用例 |
| 复现仿真、综合或板端故障 | [工具协作流程](references/orchestration.md) | 最小复现、首个失败证据、修正与复测 |
| 比较优化效果 | [工作流与提示词](references/workflows.md) | 同条件性能和资源对照，注明测量范围 |
| 整理协作报告 | [证据模板](references/evidence-template.md) | 可核对的原始交互、反证、修正及其结果 |

开始执行前固定源码版本、输入和基线。根据实际接口核对位宽、符号、帧尾和寄存器副作用。定位失败时先划清采集、传输、计算与显示的边界，再改变一个可判别变量。保留执行命令、退出码、输出路径和硬件版本。

若用户只要整理报告，先从已有记录提取证据。原始回答缺失时明确标记。模型推断、用户现场观察、仿真和板测分别登记，硬件不可用时写明可复跑到哪一步。
