quanxian318/jianwei-vibrometer/skill/partition_review/prompt.md

# 提示词模板

请根据下列真实输入提出软硬件划分建议：
- 器件与工具版本：<填写>
- 主功能、辅助功能与优先级：<填写>
- 时延、吞吐、精度及功耗要求：<填写>
- 当前已实现的接口、时钟和数据流：<填写>
- 实现报告及对应位流哈希：<附文件>
- 必须保持不变的链路：<填写>

请先核对证据版本，分别统计LUT、FF、Slice、BRAM、DSP，检查未约束路径与时钟告警。提出方案时写明哪些功能移到PS、哪些时序必须留在PL，以及带宽与验收方法。对没有实测依据的收益标为待验证。不要仅凭WNS为正宣称所有路径完成约束验证。请输出可供人员审批的修改范围，而不是自动修改硬件。
