quanxian318/jianwei-vibrometer/skill/peripheral_diagnosis/checklist.md

# 证据优先的排查清单

1. 明确现象及复现步骤，记录设备、程序、位流和配置版本。区分首次启动、重启与热插拔。
2. 按原理图确认供电、参考地和电压域；改接线先断电。供电灯亮不能证明外设电源和信号电平正常。
3. 核对实际针序、方向、模式拨码、上拉及接口归属；按必要性逐条隔离共享总线，避免一次断开多线后无法归因。
4. 分开检查设备节点、驱动、总线事务、协议回包和实际物理输出。串口发送成功不等于打印完成，音频命令成功不等于内容正确。
5. MMIO按芯片规定的访问宽度操作。对FIFO读写，先确认一次API调用是否对应一次总线访问；不要将普通文件字节操作直接等同于寄存器访问。
6. 打印对照数字源图与同一实物报告，检查CTS、FIFO、TX排空、光栅分段和机械走纸。具体条带与延时参数需按打印机重新验证。
7. 音量使用同一条已确认正常的音频，先比较静音与中等音量；修改对当前任务还是下条任务生效需明确。WAV头格式通过不证明音频内容无噪声。
8. 触屏同时检查USB枚举、输入事件和UI设备句柄。短暂恢复应记录为恢复，不宣称根因已消除。
9. 原始读数、日志与仪器截图分别留档。报告中分开列出已验证、暂时恢复、尚未定位和待复测事项。
