quanxian318/jianwei-vibrometer/sim/reference/stereo/asset_f9e1cd27b0.md

# 当前板端事实（2026-10-23）

## 程序与硬件

- AX7010 裸板，ALINX Debian 8 / Linux 4.9；运行 `/root/vibmon_cam/vibmond -c /root/vibmon_cam/an5642_board.json`，SSH 地址 192.168.10.2。
- 当前位流 `an5642_stereo_sgm40_pdm.bit.bin`，FCLK2 40 MHz，双目核心 0x43C20000、DMA 0x40400000、预留缓冲 0x1F800000；本轮没有更换位流、内核或启动文件。
- AN5642 1280×720，相机约43–46 fps；双目处理320×180。深度刷新率与相机帧率分开。
- 当前 PL 输出已抓取到本机，57,600 像素与同参数 PS 位精确模型完全一致。运行统计后端为 PL，最近378对已发布，PL调用756次，调用失败0次。

## 当前双目处理

- `stereo.pl_vertical_check=true`：同一对校正图像做正常/上下翻转两次 PL 匹配，再在 PS 中筛选两个方向一致的视差，减少单方向条纹。硬件核仍是固定双路径SGM，未改为四路径代价聚合。
- `stereo.refine_lk=false`：恢复全图 LK 时板端约804 ms/对，已取消；最终观察约316–331 ms/对，页面实测约1.7 fps，取帧/界面负载还会影响刷新。
- PS继续负责校正、双方向一致性、空间/时间后处理及显示；没有将匹配切回PS。
- 不一致/无纹理/遮挡处保留无效深度，补洞只供显示，不计入测点。当前室内弱纹理画面有效比例随场景变化，约27–46%，不能认为每个像素均可测距。
- 深度配色按视差（逆深度）分配颜色，避免远距离尾部把近处物体压成相同颜色；自动色标只统计实测深度。
- 已修复深度页一直显示0.0 fps的问题，现在显示实际发布间隔。

## 距离校正

- 文件仍为 `an5642_stereo_nominal.json`，ID `an5642-nominal-20261022-dist2000`；焦距1286px、基线40mm、右目cy390仍沿用估值。
- 用户将盒子放在约2米处，在左图归一化位置(0.49,0.56)对盒子正面做单距离水平偏移校正；当前右目cx=614.7666666666668。
- 校正后盒子测点页面显示约2.04m。参考距离是约值，且该结果在校正目标上取得，不能用来推导全距离范围的测距精度；畸变与完整内外参仍需棋盘格实拍标定。
- 该校正不改变测振的mm/px；`scale_source=file`，多点测振仍用px。

## 验证与恢复

- 双目单测、UI渲染测试、65项应用主机集成检查通过；ARM静态程序交叉编译成功并已在板上运行。
- 有真值的合成台阶/曝光差回归：视差误差大于1px的比例1.82%→0.47%，保留测量点9712→9532。该指标来自合成数据，不是房间场景实测精度。
- 板端原程序、配置、标定与设置保存在 `/root/vibmon_cam/backup_depth_20261023_plquality/`。当前使用新程序与校正文件；本轮未设置开机自启。
