quanxian318/jianwei-vibrometer/hardware/enclosure/preview/renders/03_Lid_Top.png

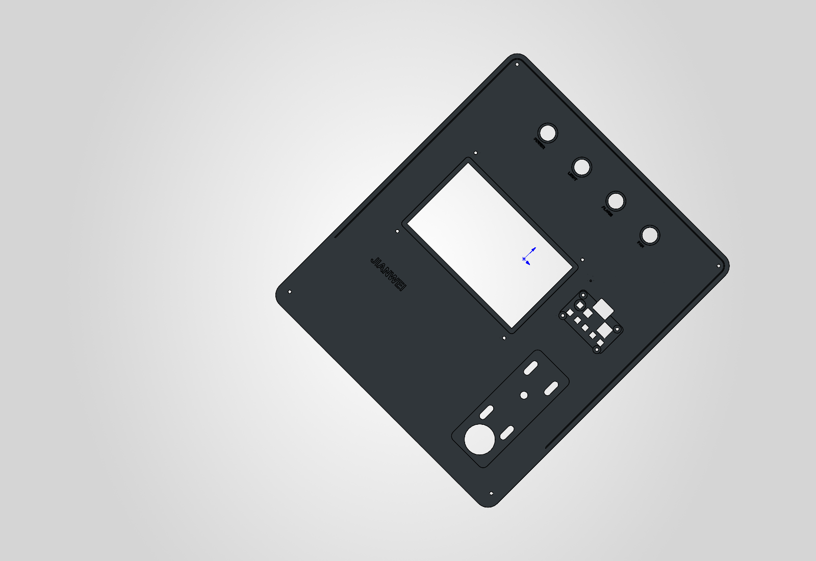
hardware/enclosure/preview/renders/03_Lid_Top.png
