quanxian318/jianwei-vibrometer/hardware/enclosure/preview/renders/04_Lid_Underside.png

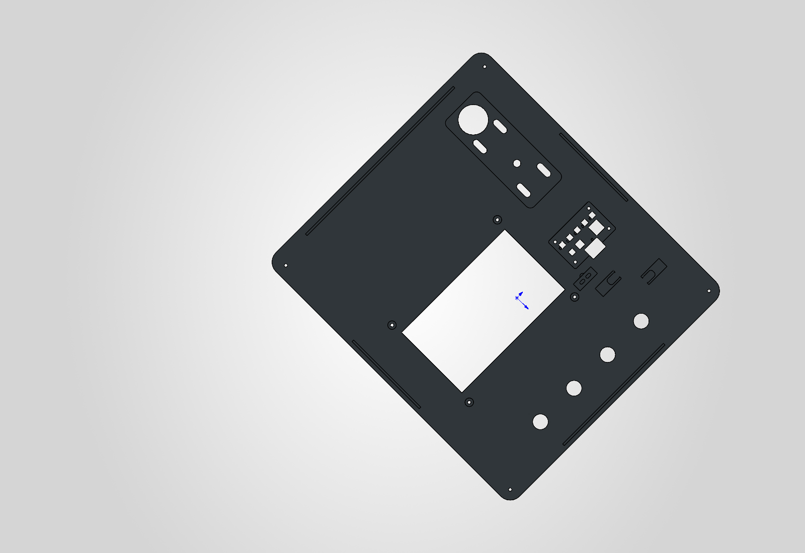
hardware/enclosure/preview/renders/04_Lid_Underside.png
