quanxian318/jianwei-vibrometer/media/poster_en.png

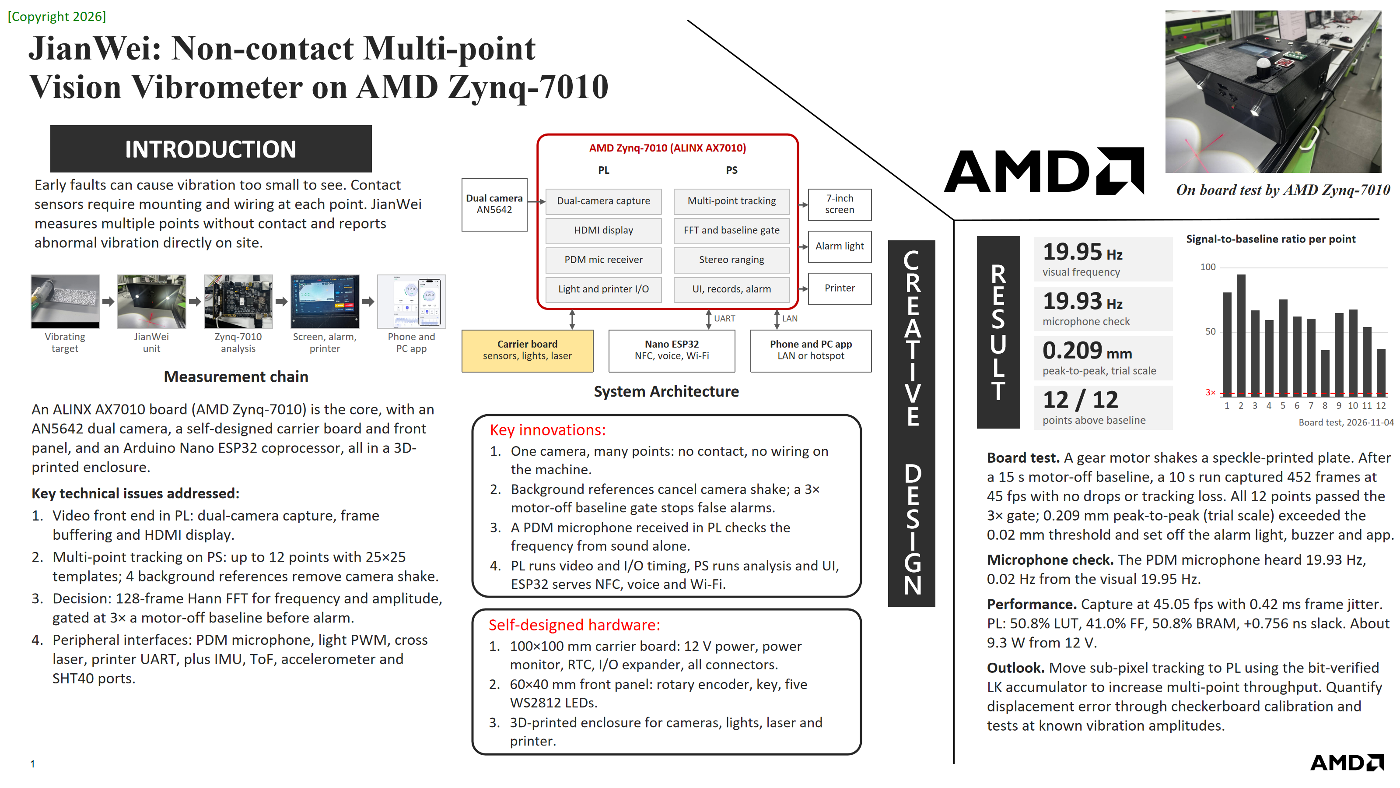
media/poster_en.png
