quanxian318/jianwei-vibrometer/media/poster_zh.png

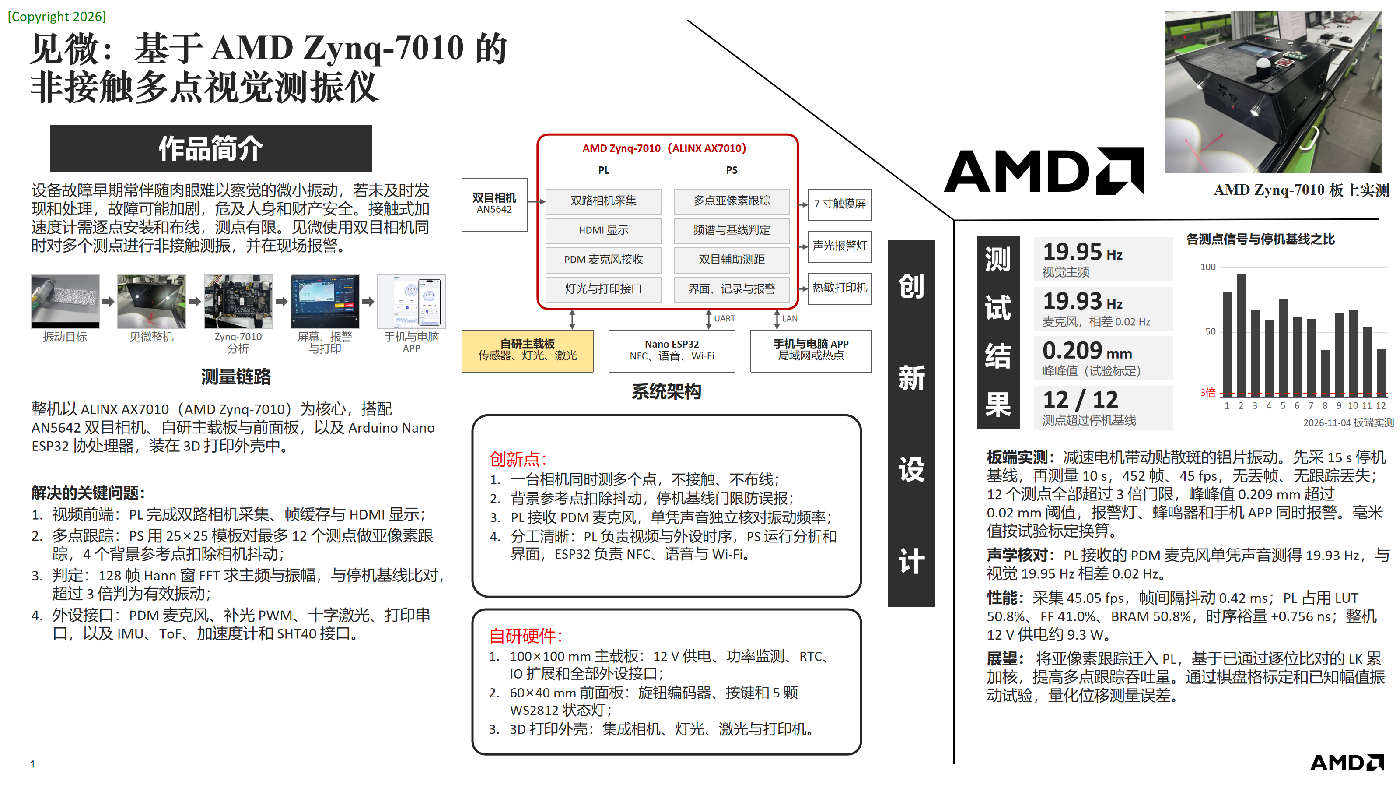
media/poster_zh.png
