quanxian318/jianwei-vibrometer/hardware/pcb/switch_bom.csv

所属板件 | 原理图页 | 位号 | 型号或数值 | 设计数值 | 封装或规格 | 品牌 | 立创编号 | 用途与连接 | 装配状态 | 数量 | 商城链接 | 商城现货显示 | 库存核对时间
机壳件 | 01 | SW101 | 用户自购圆孔螺母固定自锁按钮 | 直流触点≥5A，推荐≥6A；电压≥12V | 机壳圆孔安装，螺母固定，保持型SPST；SPDT仅用COM/NO | 用户自选 |  | 总电源；接J102两针，串联12V入口正极；额定≥5A DC，推荐≥6A DC并留启动余量 | 装配 | 1 |  | 用户自购，不指定商城料号
机壳件 | 03 | SW301 | 用户自购圆孔螺母固定自锁按钮 | 适用于约0.5mA低电流信号 | 机壳圆孔安装，螺母固定，保持型SPST；SPDT仅用COM/NO | 用户自选 |  | 补光允许；COM/NO接J305-1 LED_EN与J305-2 GND；闭合允许，约0.5mA信号触点 | 装配 | 1 |  | 用户自购，不指定商城料号
机壳件 | 03 | SW302 | 用户自购圆孔螺母固定自锁按钮 | 直流触点建议≥2A、≥12V，并覆盖实际启动电流 | 机壳圆孔安装，螺母固定，保持型SPST；SPDT仅用COM/NO | 用户自选 |  | 声光报警允许；J302-1→开关触点→组合灯公共正极；红/黄/绿/蜂鸣器负端回J302-2/3/4/5 | 装配 | 1 |  | 用户自购，不指定商城料号
机壳件 | 03 | SW303 | 用户自购圆孔螺母固定自锁按钮 | 直流触点建议≥2A、≥12V，并覆盖实际启动电流 | 机壳圆孔安装，螺母固定，保持型SPST；SPDT仅用COM/NO | 用户自选 |  | 风扇允许；J302-1→开关触点→风扇正极；风扇负极回J302-6，随风扇选装 | 随风扇选装 | 1 |  | 用户自购，不指定商城料号
