quanxian318/jianwei-vibrometer/hardware/netlists/all_components.csv

板件 | 位号 | 型号 | 立创编号 | 封装 | 中心X_mm | 中心Y_mm | 角度_deg | 安装层
前面板 | C101 | EEEFK1C101P | C128532 | CAP-SMD_BD6.3-L6.6-W6.6-FD | 21.59 | 14.732 | 180 | 1
前面板 | C102 | CL10B104KB8NNNC | C1591 | C0603 | 3.87198 | 26.22398 | 90 | 1
前面板 | C103 | CL10B104KB8NNNC | C1591 | C0603 | 14.986 | 26.15255 | 270 | 1
前面板 | C104 | CL10B104KB8NNNC | C1591 | C0603 | 26.10002 | 26.15255 | 270 | 1
前面板 | C105 | CL10B104KB8NNNC | C1591 | C0603 | 37.084 | 26.15255 | 270 | 1
前面板 | C106 | CL10B104KB8NNNC | C1591 | C0603 | 48.26 | 26.15255 | 270 | 1
前面板 | ENC101 | EC11E15244B2 | C470754 | SW-TH_EC11XXXXXXXX | 46.482 | 14.71318 | 0 | 1
前面板 | HL101 | WS2812B-V6 | C52917433 | LED-SMD_4P-L5.0-W5.0-TL-A | 8.128 | 27.432 | 0 | 1
前面板 | HL102 | WS2812B-V6 | C52917433 | LED-SMD_4P-L5.0-W5.0-TL-A | 19.20875 | 27.432 | 0 | 1
前面板 | HL103 | WS2812B-V6 | C52917433 | LED-SMD_4P-L5.0-W5.0-TL-A | 30.2895 | 27.432 | 0 | 1
前面板 | HL104 | WS2812B-V6 | C52917433 | LED-SMD_4P-L5.0-W5.0-TL-A | 41.37025 | 27.432 | 0 | 1
前面板 | HL105 | WS2812B-V6 | C52917433 | LED-SMD_4P-L5.0-W5.0-TL-A | 52.451 | 27.432 | 0 | 1
前面板 | J101 | SM10B-GHS-TB | C2683602 | CONN-SMD_SM10B-GHS-TB | 30.0 | 3.683 | 0 | 1
前面板 | K101 | TS-1187A-B-A-B | C318884 | SW-SMD_4P-L5.1-W5.1-P3.70-LS6.5-TL_H1.5 | 10.033 | 14.73175 | 0 | 1
前面板 | R101 | RC0603FR-0710KL | C98220 | R0603 | 34.32285 | 9.10411 | 90 | 1
主载板 | BT801 | KH-BS1220-2-SMT | C5365932 | BAT-SMD_KH-CR1220-2 | 79.629 | 75.565 | 180 | 1
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
主载板 | J102 | JL128-50802G01 | C415422 | CONN-TH_JL128-50802G01 | 5.588 | 14.097 | -90 | 1
主载板 | J301 | JL128-50802G01 | C415422 | CONN-TH_JL128-50802G01 | 5.588 | 38.16394 | -90 | 1
主载板 | J302 | DB128V-5.08-6P-GN-S | C2915642 | CONN-TH_6P-P5.08_DIBO_DB128V-5.08 | 5.52549 | 60.452 | -90 | 1
主载板 | J304 | JL128-50802G01 | C415422 | CONN-TH_JL128-50802G01 | 5.588 | 26.13047 | -90 | 1
主载板 | J305 | SM02B-GHS-TB(LF)(SN) | C189893 | CONN-SMD_SM02B-GHS-TB-LF-SN | 68.707 | 3.53111 | 0 | 1
主载板 | J306 | SM02B-GHS-TB(LF)(SN) | C189893 | CONN-SMD_SM02B-GHS-TB-LF-SN | 61.75494 | 3.53111 | 0 | 1
主载板 | J401 | S5B-PH-K-S(LF)(SN) | C157923 | CONN-TH_S5B-PH-K-S-LF-SN | 6.477 | 84.455 | 90 | 1
主载板 | J502 | SM10B-GHS-TB | C2683602 | CONN-SMD_SM10B-GHS-TB | 96.647 | 61.595 | 90 | 1
主载板 | J601 | SM02B-GHS-TB(LF)(SN) | C189893 | CONN-SMD_SM02B-GHS-TB-LF-SN | 96.266 | 88.392 | 90 | 1
主载板 | J603 | DM3AT-SF-PEJM5 | C114218 | SD-SMD_DM3AT-SF-PEJM5 | 80.264 | 9.017 | 0 | 1
主载板 | J604 | PM254-1-15-Z-8.5 | C2897378 | HDR-TH_15P-P2.54-V-F | 21.08216 | 62.35709 | -90 | 1
主载板 | J605 | PZ254V-11-03P | C2937625 | HDR-TH_3P-P2.54-V-M_PZ254V-11-03P | 60.96 | 78.359 | -90 | 1
主载板 | J606 | PM254-1-15-Z-8.5 | C2897378 | HDR-TH_15P-P2.54-V-F | 36.322 | 62.357 | -90 | 1
主载板 | J701 | SM06B-GHS-TB(LF)(SN) | C133065 | CONN-TH_SM06B-GHS-TB-LF-SN | 96.52 | 46.99 | 90 | 1
主载板 | J704 | SM04B-GHS-TB(LF)(SN) | C189895 | CONN-SMD_4P-P1.25_SM04B-GHS-TB-LF-SN | 85.725 | 95.631 | 180 | 1
主载板 | J705 | SM03B-GHS-TB(LF)(SN) | C514175 | CONN-TH_SM03B-GHS-TB-LF-SN | 54.30086 | 3.27698 | 0 | 1
主载板 | J706 | SM04B-GHS-TB(LF)(SN) | C189895 | CONN-SMD_4P-P1.25_SM04B-GHS-TB-LF-SN | 14.224 | 95.758 | 180 | 1
主载板 | J801 | DC3-2.54-40PAS | C5156665 | IDC-TH_40P-P2.54_C9138 | 50.0 | 94.234 | 0 | 1
主载板 | J802 | PZ254V-11-04P | C2691448 | HDR-TH_4P-P2.54-V-M | 66.167 | 77.216 | -90 | 1
主载板 | L201 | SRP1038A-150M | C780183 | IND-SMD_L10.0-W10.0_MDA1040-220M | 52.832 | 13.843 | 180 | 1
主载板 | L202 | SRP1038A-150M | C780183 | IND-SMD_L10.0-W10.0_MDA1040-220M | 82.55 | 25.4 | -90 | 1
主载板 | L203 | SRP1038A-150M | C780183 | IND-SMD_L10.0-W10.0_MDA1040-220M | 27.686 | 33.655 | 90 | 1
主载板 | Q301 | AOD4184A | C99124 | TO-252-2_L6.6-W6.1-P4.57-LS9.9-TL-CW | 56.65203 | 42.30103 | 0 | 1
主载板 | Q302 | AO4407A | C16072 | SOIC-8_L4.9-W3.9-P1.27-LS6.0-BL | 55.245 | 49.149 | 90 | 1
主载板 | Q303 | AO3400A | C20917 | SOT-23-3_L2.9-W1.3-P1.90-LS2.4-BR | 53.467 | 56.515 | 90 | 1
主载板 | Q304 | AO3400A | C20917 | SOT-23-3_L2.9-W1.3-P1.90-LS2.4-BR | 13.335 | 67.818 | 0 | 1
主载板 | Q305 | AO3400A | C20917 | SOT-23-3_L2.9-W1.3-P1.90-LS2.4-BR | 13.208 | 62.865 | 0 | 1
主载板 | Q306 | 2N7002 | C8545 | SOT-23-3_L2.9-W1.3-P1.90-LS2.4-BR | 61.087 | 24.892 | 0 | 1
主载板 | Q307 | AOD4184A | C99124 | TO-252-2_L6.6-W6.1-P4.57-LS9.9-TL-CW | 67.31 | 38.71493 | 270 | 1
主载板 | Q308 | AO3400A | C20917 | SOT-23-3_L2.9-W1.3-P1.90-LS2.4-BR | 13.081 | 57.785 | 0 | 1
主载板 | Q309 | AO3400A | C20917 | SOT-23-3_L2.9-W1.3-P1.90-LS2.4-BR | 13.208 | 50.165 | 0 | 1
主载板 | Q310 | AO3400A | C20917 | SOT-23-3_L2.9-W1.3-P1.90-LS2.4-BR | 13.208 | 46.50178 | 0 | 1
主载板 | Q401 | AO3400A | C20917 | SOT-23-3_L2.9-W1.3-P1.90-LS2.4-BR | 11.684 | 84.455 | 90 | 1
主载板 | Q601 | AO3400A | C20917 | SOT-23-3_L2.9-W1.3-P1.90-LS2.4-BR | 40.132 | 50.419 | 90 | 1
主载板 | Q701 | AO3400A | C20917 | SOT-23-3_L2.9-W1.3-P1.90-LS2.4-BR | 91.948 | 50.292 | 180 | 1
主载板 | R101 | RC0603FR-0710KL | C98220 | R0603 | 27.25296 | 26.01058 | 180 | 1
主载板 | R102 | RC0603FR-07100KL | C14675 | R0603 | 20.73651 | 22.352 | 180 | 1
主载板 | R103 | RC0603FR-0712K7L | C185374 | R0603 | 23.622 | 19.90518 | 90 | 1
主载板 | R104 | RC0603FR-071ML | C105578 | R0603 | 23.20844 | 26.73506 | 90 | 1
主载板 | R105 | RC0603FR-071KL | C22548 | R0603 | 24.96275 | 26.73506 | 270 | 1
主载板 | R106 | RC0603FR-0710KL | C98220 | R0603 | 20.73651 | 23.99265 | 0 | 1
主载板 | R201 | RC0603FR-0710KL | C98220 | R0603 | 59.92621 | 17.98324 | 90 | 1
主载板 | R202 | 0603WAF3241T5E | C22994 | R0603 | 59.96066 | 21.26154 | 270 | 1
主载板 | R203 | RC0603FR-0710KL | C98220 | R0603 | 78.53676 | 31.47821 | 180 | 1
主载板 | R204 | 0603WAF3241T5E | C22994 | R0603 | 75.25846 | 31.51266 | 0 | 1
主载板 | R205 | RC0603FR-0710KL | C98220 | R0603 | 31.82624 | 26.56079 | 0 | 1
主载板 | R206 | 0603WAF3241T5E | C22994 | R0603 | 35.10454 | 26.52634 | 180 | 1
主载板 | R207 | RC0603FR-07100KL | C14675 | R0603 | 65.42536 | 8.70351 | 90 | 1
主载板 | R208 | RC0603FR-072K2L | C114662 | R0603 | 81.51673 | 88.29637 | 180 | 1
主载板 | R301 | RC0603FR-07100RL | C105588 | R0603 | 46.06252 | 35.01751 | 0 | 1
主载板 | R302 | RC0603FR-072K2L | C114662 | R0603 | 46.06252 | 33.02 | 0 | 1
主载板 | R303 | RC0603FR-0710RL | C109318 | R0603 | 52.96764 | 36.18636 | 270 | 1
主载板 | R304 | RC0603FR-07100KL | C14675 | R0603 | 49.67427 | 38.862 | 180 | 1
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
主载板 | R614 | RC0603FR-0733RL | C108661 | R0603 | 59.309 | 69.24449 | 0 | 1
主载板 | R615 | RC0603FR-0733RL | C108661 | R0603 | 59.309 | 71.247 | 0 | 1
主载板 | R616 | RC0603FR-0733RL | C108661 | R0603 | 59.309 | 67.24197 | 0 | 1
主载板 | R617 | RC0603FR-07510KL | C114066 | R0603 | 59.309 | 65.23946 | 0 | 1
主载板 | R701 | RC0603FR-07100KL | C14675 | R0603 | 44.10748 | 23.4728 | 0 | 1
主载板 | R702 | RC0603FR-0710KL | C98220 | R0603 | 44.10748 | 25.38009 | 180 | 1
主载板 | R703 | RC0603FR-071KL | C22548 | R0603 | 44.10748 | 21.56551 | 0 | 1
主载板 | R704 | RC0603FR-071KL | C22548 | R0603 | 91.96046 | 53.20503 | 0 | 1
主载板 | R705 | RC0603FR-0733RL | C108661 | R0603 | 68.31664 | 88.29637 | 0 | 1
主载板 | R706 | RC0603FR-0733RL | C108661 | R0603 | 68.31664 | 86.38371 | 0 | 1
主载板 | R707 | RC0603FR-071KL | C22548 | R0603 | 68.326 | 84.455 | 0 | 1
主载板 | R708 | RC0603FR-074K7L | C99782 | R0603 | 39.81302 | 88.29637 | 180 | 1
主载板 | R709 | RC0603FR-074K7L | C99782 | R0603 | 39.81302 | 85.9233 | 180 | 1
主载板 | R710 | RC0603FR-074K7L | C99782 | R0603 | 63.373 | 88.29637 | 180 | 1
主载板 | R711 | RC0603FR-074K7L | C99782 | R0603 | 63.40047 | 86.38371 | 180 | 1
主载板 | R801 | RC0603FR-074K7L | C99782 | R0603 | 86.67809 | 51.09112 | -90 | 1
主载板 | R802 | RC0603FR-074K7L | C99782 | R0603 | 85.02709 | 51.09112 | -90 | 1
主载板 | R803 | RC0603FR-0710KL | C98220 | R0603 | 55.93444 | 74.4002 | 0 | 1
主载板 | R804 | RC0603FR-0710KL | C98220 | R0603 | 82.804 | 66.548 | 0 | 1
主载板 | RN401 | YC164-FR-071KL | C110021 | RES-ARRAY-SMD_0603-8P-L3.2-W1.6-BL | 53.467 | 62.357 | 90 | 1
主载板 | RN402 | YC164-FR-071KL | C110021 | RES-ARRAY-SMD_0603-8P-L3.2-W1.6-BL | 47.498 | 67.437 | 180 | 1
主载板 | RN501 | YC164-FR-071KL | C110021 | RES-ARRAY-SMD_0603-8P-L3.2-W1.6-BL | 65.786 | 58.928 | 180 | 1
主载板 | RS101 | WSLP25125L000FEA | C844913 | R2512 | 14.08592 | 26.37952 | -90 | 1
主载板 | U101 | INA226AIDGSR | C49851 | MSOP-10_L3.0-W3.0-P0.50-LS5.0-BL | 19.177 | 26.797 | 90 | 1
主载板 | U102 | TLV3011BIDBVR | C20345920 | SOT-23-6_L2.9-W1.6-P0.95-LS2.8-BR | 24.892 | 23.241 | 180 | 1
主载板 | U201 | TPS5430DDAR | C9864 | ESOP-8_L4.9-W3.9-P1.27-LS6.0-TL-EP | 56.26663 | 23.19007 | 90 | 1
主载板 | U202 | TPS5430DDAR | C9864 | ESOP-8_L4.9-W3.9-P1.27-LS6.0-TL-EP | 73.32993 | 27.81863 | 180 | 1
主载板 | U203 | TPS5430DDAR | C9864 | ESOP-8_L4.9-W3.9-P1.27-LS6.0-TL-EP | 37.03307 | 30.22037 | 0 | 1
主载板 | U204 | TLV1117LV33DCYR | C15578 | SOT-223_L6.7-W3.5-P2.30-BR | 39.116 | 14.351 | 90 | 1
主载板 | U205 | TPS7A2033PDBVR | C2862740 | SOT-23-5_L2.9-W1.6-P0.95-LS2.8-BR | 63.90748 | 12.51005 | 270 | 1
主载板 | U301 | UCC27517DBVR | C99395 | SOT-23-5_L3.0-W1.7-P0.95-LS2.8-BR | 49.911 | 36.195 | 180 | 1
主载板 | U302 | UCC27517DBVR | C99395 | SOT-23-5_L3.0-W1.7-P0.95-LS2.8-BR | 73.279 | 45.212 | 0 | 1
主载板 | U401 | 74LVC244APW,118 | C6079 | TSSOP-20_L6.5-W4.4-P0.65-LS6.4-BL | 47.625 | 61.976 | -90 | 1
主载板 | U402 | SN74LVC1G125DBVR | C23654 | SOT-23-5_L3.0-W1.7-P0.95-LS2.8-BL | 13.208 | 80.772 | -90 | 1
主载板 | U501 | SN74LVC2G17DBVR | C10429 | SOT-23-6_L2.9-W1.6-P0.95-LS2.8-BL | 69.34765 | 55.22586 | 90 | 1
主载板 | U502 | SN74AHCT1G125DBVR | C7484 | SOT-23-5_L3.0-W1.7-P0.95-LS2.8-BR | 83.947 | 42.35458 | 180 | 1
主载板 | U601 | SN74LVC2G125DCUT | C2675813 | VSSOP-8_L2.3-W2.0-P0.50-LS3.1-BL | 44.831 | 54.864 | 0 | 1
主载板 | U602 | MAX98357AETE+T | C910544 | TQFN-16_L3.0-W3.0-P0.50-BL-EP1.5 | 65.913 | 68.072 | -90 | 1
主载板 | U801 | TCA9555PWR | C465732 | TSSOP-24_L7.8-W4.4-P0.65-LS6.4-BL | 50.0 | 77.851 | 90 | 1
主载板 | U802 | DS3231SN#T&R | C9866 | SOIC-16_L10.3-W7.5-P1.27-LS10.3-BL | 82.042 | 59.055 | 180 | 1
主载板 | J201 | U-A-24DD-Y-14 | C2689985 | USB-A-TH_U-A-24DD-Y-14 | 93.472 | 16.129 | 90 | 1
主载板 | J501 | U-A-24DD-Y-14 | C2689985 | USB-A-TH_U-A-24DD-Y-14 | 93.472 | 33.401 | 90 | 1
主载板 | J602 | WAFER-GH1.25-8PWB | C3029383 | CONN-SMD_8P-P1.25_XUNPU-WAFER-GH1.25-8PWB | 96.52 | 77.343 | 90 | 1
主载板 | J702 | WAFER-GH1.25-8PWB | C3029383 | CONN-SMD_8P-P1.25_XUNPU-WAFER-GH1.25-8PWB | 43.24089 | 3.556 | 0 | 1
主载板 | J703 | WAFER-GH1.25-8PWB | C3029383 | CONN-SMD_8P-P1.25_XUNPU-WAFER-GH1.25-8PWB | 29.083 | 3.556 | 0 | 1
