quanxian318/jianwei-vibrometer/hardware/enclosure/preview/cad/V17_V16_V15_V14_V13_V12_Base_M2_Assembly_References.SLDPRT

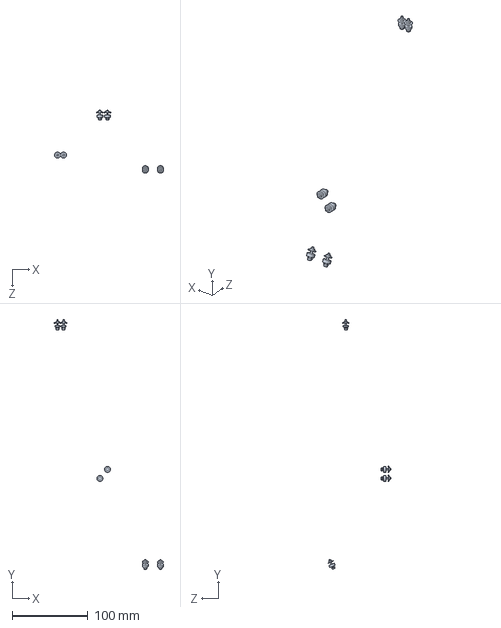
[picture p122: CAD file, 2026-11-03]
hardware/enclosure/preview/cad/V17_V16_V15_V14_V13_V12_Base_M2_Assembly_References.SLDPRT
144.0 x 330.2 x 83.8 mm
