quanxian318/jianwei-vibrometer/hardware/enclosure/preview/cad/V17_V16_V15_V14_V13_V12_Top_M2_Assembly_References.SLDPRT

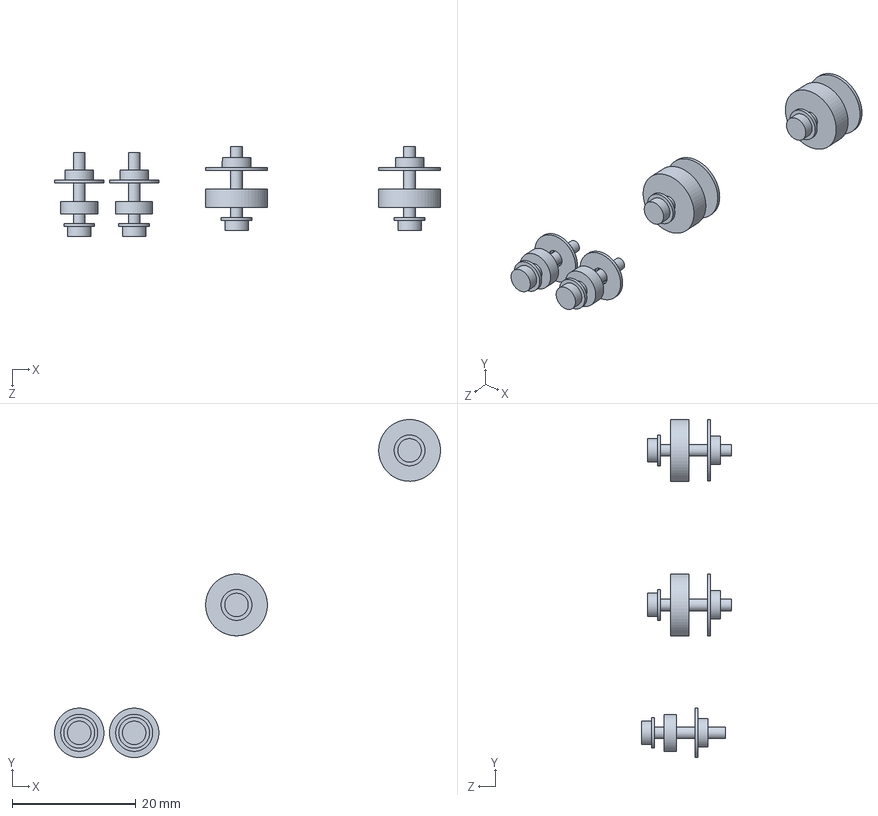
[picture p123: CAD file, 2026-11-03]
hardware/enclosure/preview/cad/V17_V16_V15_V14_V13_V12_Top_M2_Assembly_References.SLDPRT
62.4 x 54.7 x 14.6 mm
