quanxian318/jianwei-vibrometer/hardware/enclosure/preview/cad/V17_V16_V15_V14_V13_V12_V10_V09_V08_V07_V06_12_Main_PCB_ROTATED_180.SLDPRT

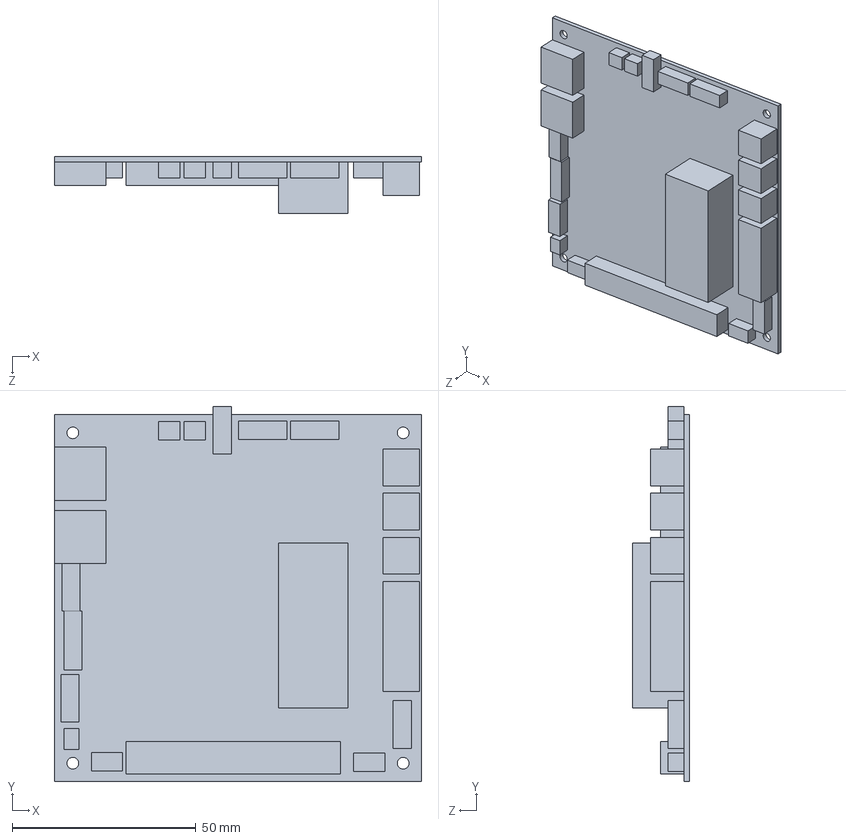
[picture p124: CAD file, 2026-11-03]
hardware/enclosure/preview/cad/V17_V16_V15_V14_V13_V12_V10_V09_V08_V07_V06_12_Main_PCB_ROTATED_180.SLDPRT
100.0 x 102.2 x 15.6 mm
