quanxian318/jianwei-vibrometer/hardware/enclosure/preview/cad/V17_02_Original_Alarm_Bracket_Lid.step

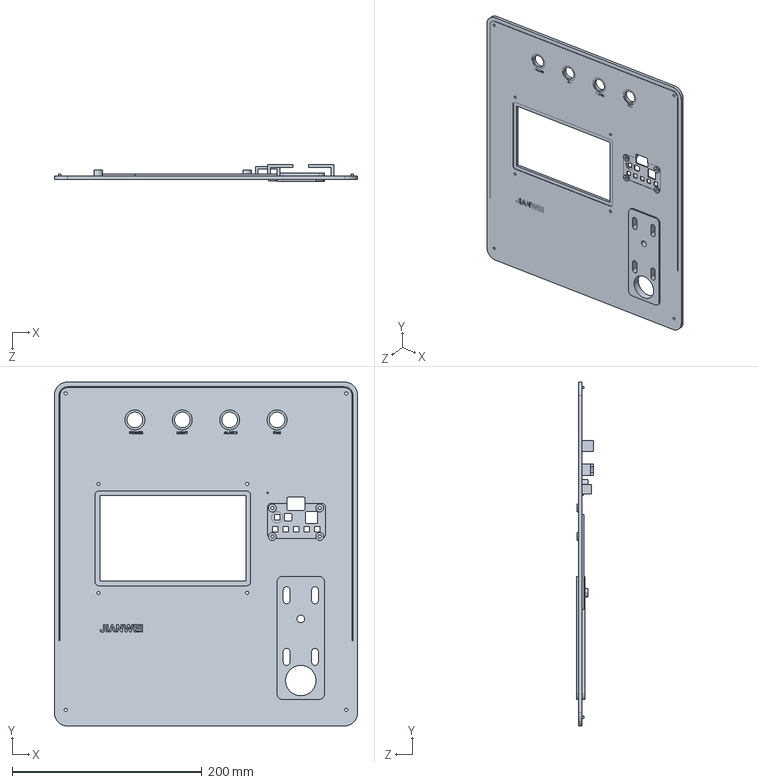
[picture p125: CAD file, 2026-11-03]
hardware/enclosure/preview/cad/V17_02_Original_Alarm_Bracket_Lid.step
320.0 x 363.0 x 18.0 mm
