quanxian318/jianwei-vibrometer/hardware/enclosure/print/PRINT_06_Module_M2_Spacers.STL

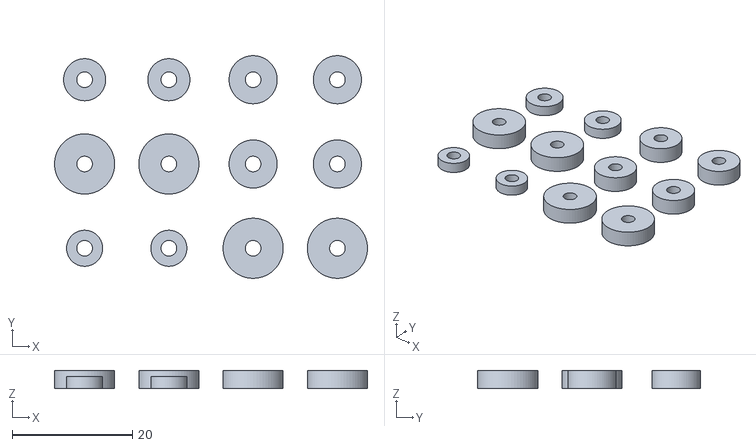
[picture p126: CAD file, 2026-11-03]
hardware/enclosure/print/PRINT_06_Module_M2_Spacers.STL
52.0 x 37.0 x 3.00
