quanxian318/jianwei-vibrometer/hardware/enclosure/preview/cad/V17_V16_V15_V14_V13_V12_V10_V09_V08_V07_V06_03_Fill_Lights.SLDPRT

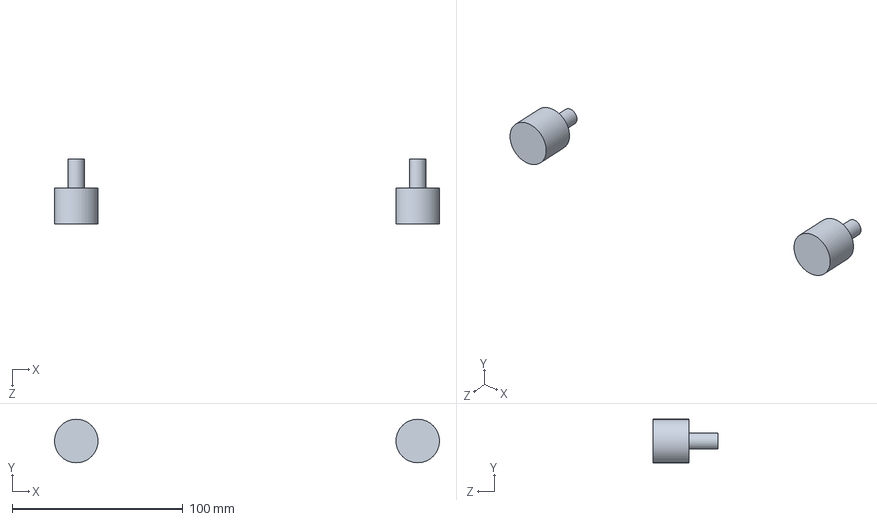
[picture p127: CAD file, 2026-11-03]
hardware/enclosure/preview/cad/V17_V16_V15_V14_V13_V12_V10_V09_V08_V07_V06_03_Fill_Lights.SLDPRT
225.5 x 25.5 x 38.0 mm
