quanxian318/jianwei-vibrometer/hardware/enclosure/preview/cad/V17_V16_V15_V14_V13_V12_V10_V09_V08_V07_V06_15_Four_Panel_Switches.SLDPRT

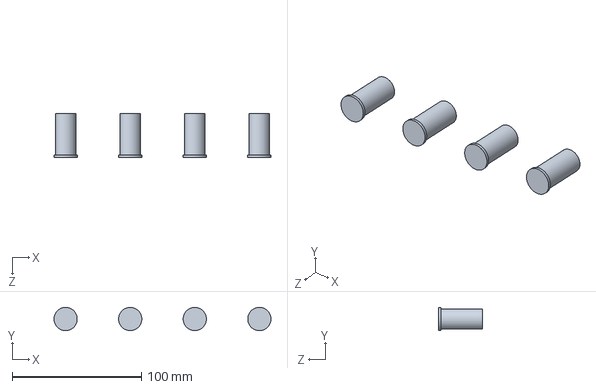
[picture p128: CAD file, 2026-11-03]
hardware/enclosure/preview/cad/V17_V16_V15_V14_V13_V12_V10_V09_V08_V07_V06_15_Four_Panel_Switches.SLDPRT
168.0 x 18.0 x 33.8 mm
