quanxian318/jianwei-vibrometer/hardware/enclosure/print/PRINT_01_Aligned_PC_Exits_Shell.stl

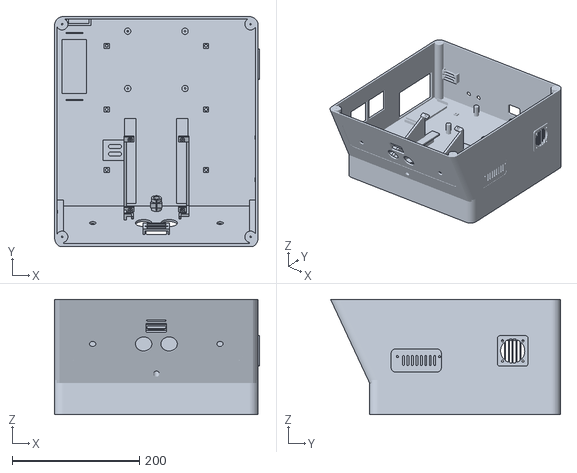
[picture p129: CAD file, 2026-11-03]
hardware/enclosure/print/PRINT_01_Aligned_PC_Exits_Shell.stl
322.0 x 361.1 x 181.0
