quanxian318/jianwei-vibrometer/hardware/enclosure/preview/cad/V17_V16_V15_M3_Hardware_Reference.SLDPRT

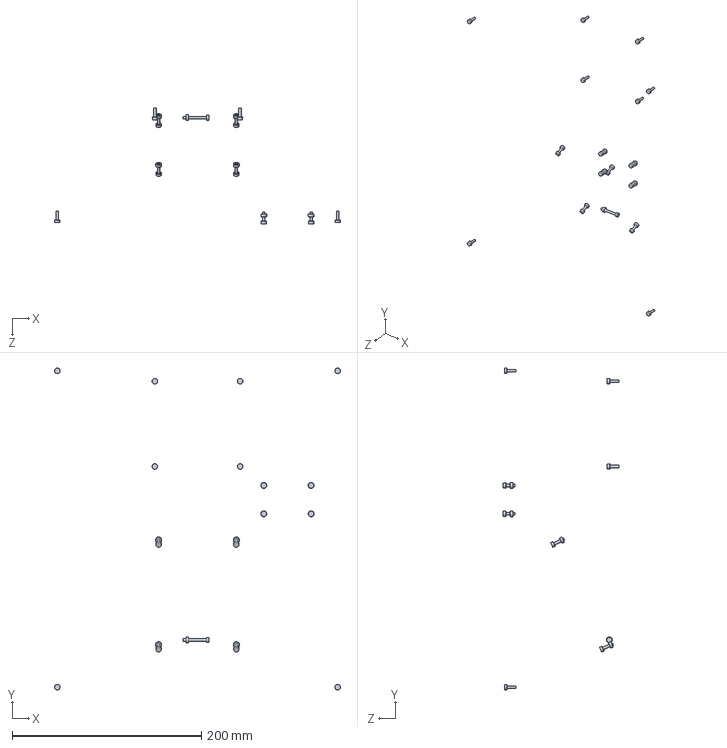
[picture p130: CAD file, 2026-11-03]
hardware/enclosure/preview/cad/V17_V16_V15_M3_Hardware_Reference.SLDPRT
302.0 x 340.0 x 122.0 mm
