quanxian318/jianwei-vibrometer/hardware/enclosure/preview/cad/V17_Alarm_Bracket_Envelope_REFERENCE.SLDPRT

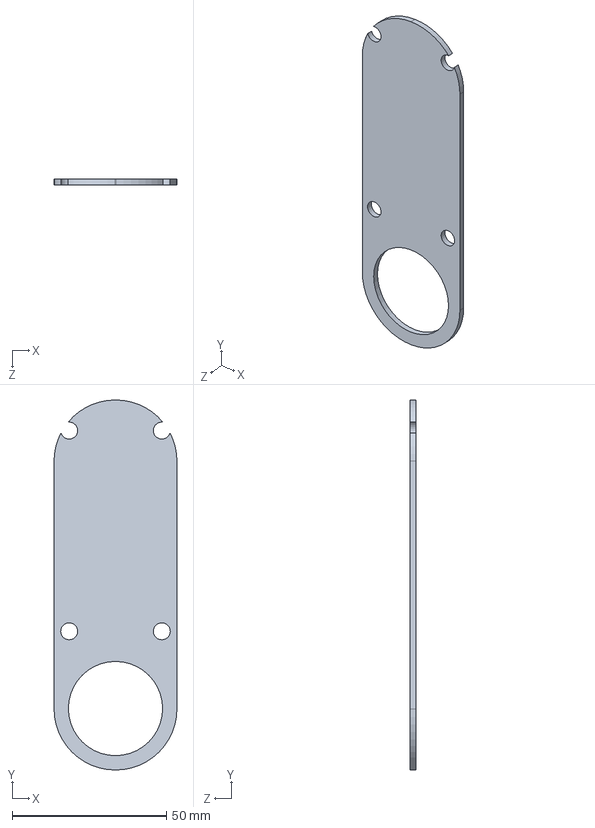
[picture p131: CAD file, 2026-11-03]
hardware/enclosure/preview/cad/V17_Alarm_Bracket_Envelope_REFERENCE.SLDPRT
39.8 x 119.8 x 2.00 mm
