quanxian318/jianwei-vibrometer/hardware/enclosure/preview/cad/V17_V16_V15_V14_V13_V12_V10_V09_V08_V07_V06_11_AN5642_PCB.SLDPRT

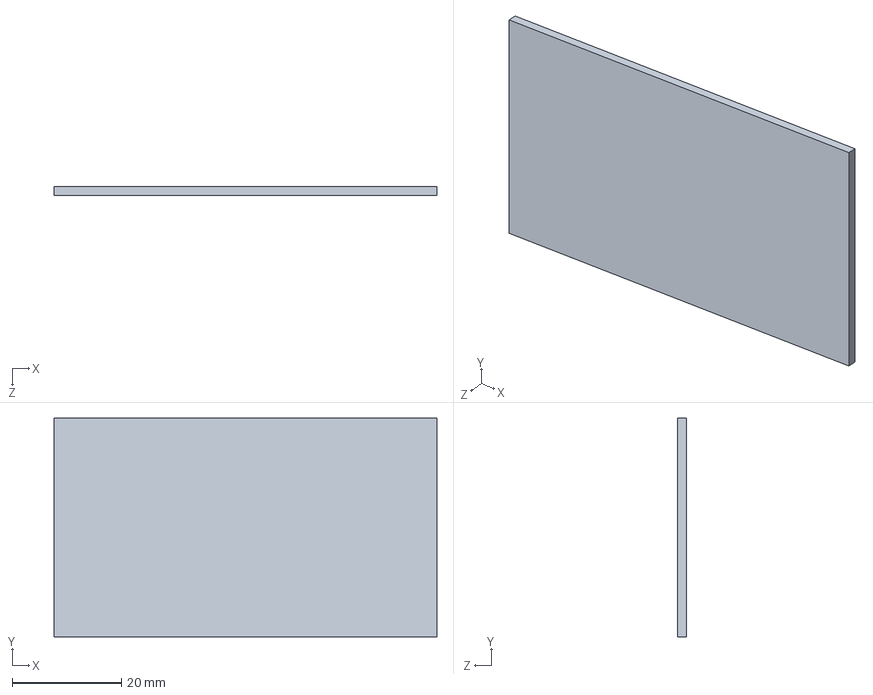
[picture p132: CAD file, 2026-11-03]
hardware/enclosure/preview/cad/V17_V16_V15_V14_V13_V12_V10_V09_V08_V07_V06_11_AN5642_PCB.SLDPRT
70.0 x 40.0 x 1.60 mm
