quanxian318/jianwei-vibrometer/hardware/enclosure/preview/cad/V17_V16_V15_V14_V13_V12_V10_V09_V08_V07_V06_32_Official_Waveshare_Screen.SLDPRT

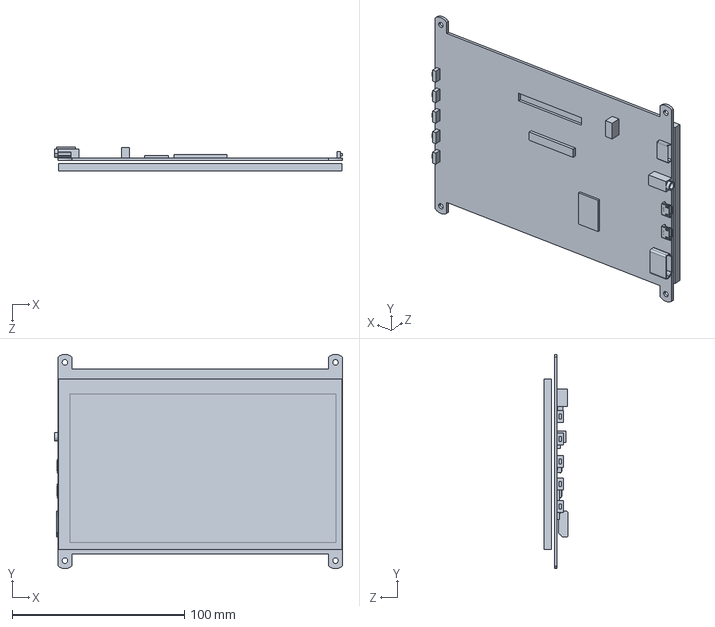
[picture p133: CAD file, 2026-11-03]
hardware/enclosure/preview/cad/V17_V16_V15_V14_V13_V12_V10_V09_V08_V07_V06_32_Official_Waveshare_Screen.SLDPRT
167.0 x 124.3 x 14.0 mm
