quanxian318/jianwei-vibrometer/hardware/enclosure/preview/cad/V17_V16_V15_V14_V13_V12_V10_V09_V08_V07_V06_35_PCB_J101_DC5525_REAR.SLDPRT

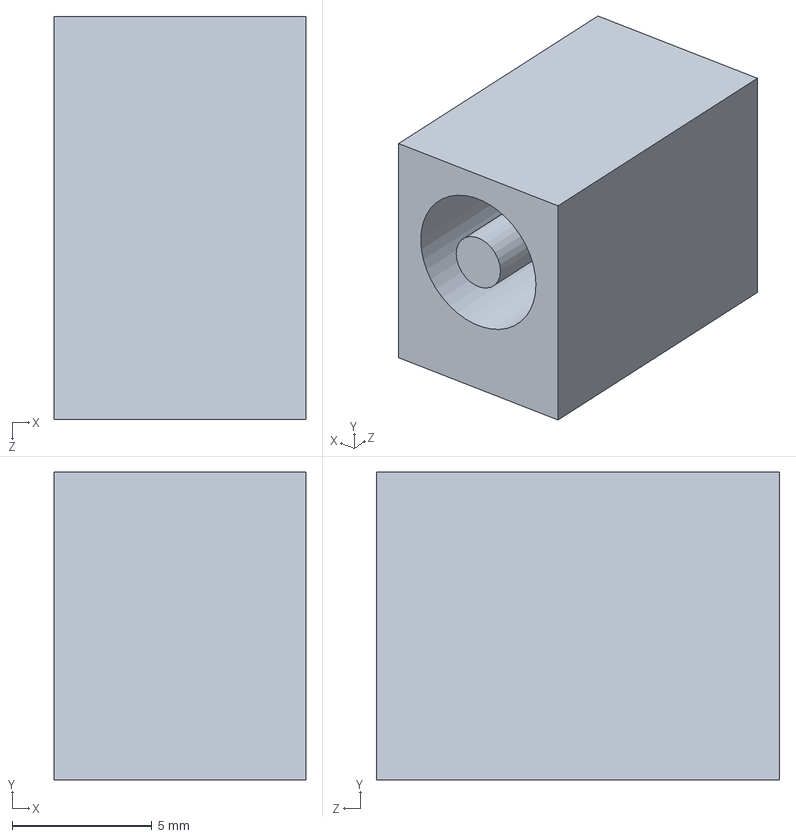
[picture p134: CAD file, 2026-11-03]
hardware/enclosure/preview/cad/V17_V16_V15_V14_V13_V12_V10_V09_V08_V07_V06_35_PCB_J101_DC5525_REAR.SLDPRT
9.00 x 11.0 x 14.4 mm
