quanxian318/jianwei-vibrometer/hardware/enclosure/preview/cad/V17_V16_V15_Encoder_Knob_Reference.SLDPRT

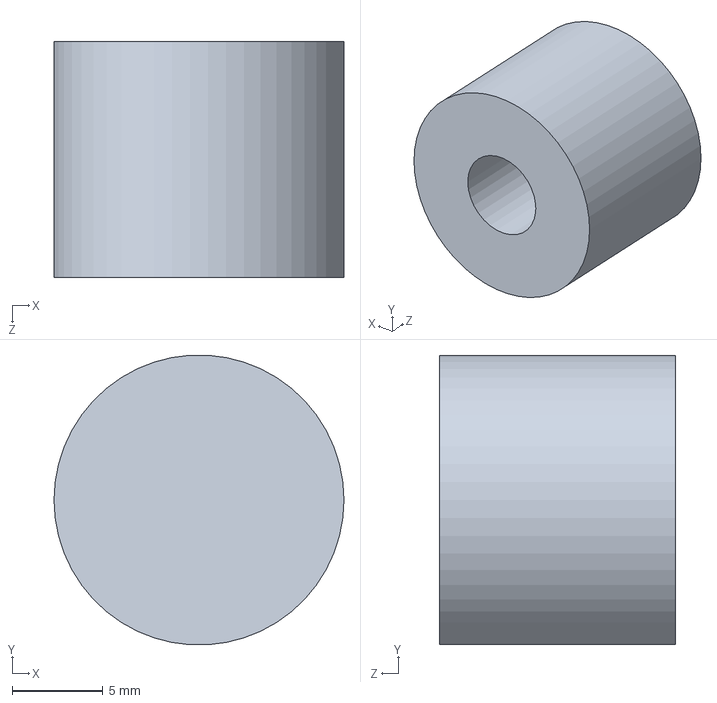
[picture p135: CAD file, 2026-11-03]
hardware/enclosure/preview/cad/V17_V16_V15_Encoder_Knob_Reference.SLDPRT
16.0 x 16.0 x 13.0 mm
