quanxian318/jianwei-vibrometer/hardware/enclosure/preview/cad/V17_V16_V15_V14_V13_V12_V10_V09_V08_V07_V06_07_PN532_NFC.SLDPRT

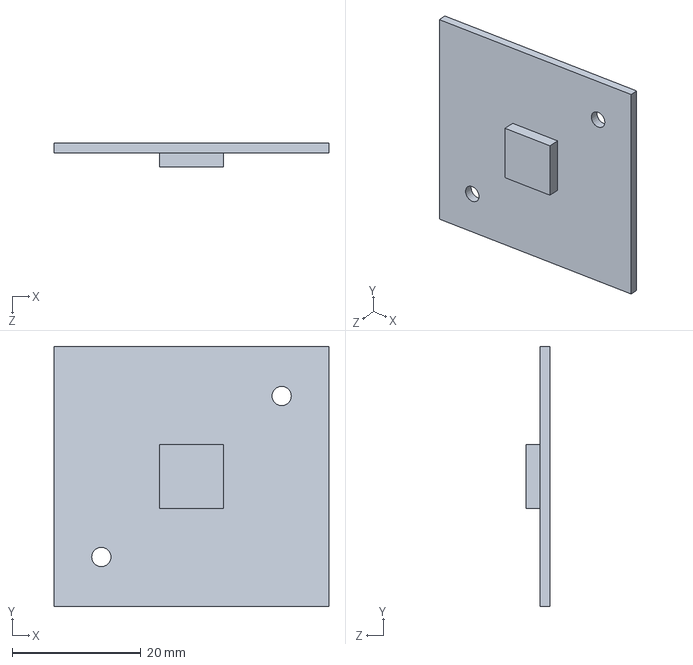
[picture p136: CAD file, 2026-11-03]
hardware/enclosure/preview/cad/V17_V16_V15_V14_V13_V12_V10_V09_V08_V07_V06_07_PN532_NFC.SLDPRT
42.7 x 40.4 x 3.80 mm
