quanxian318/jianwei-vibrometer/hardware/enclosure/preview/cad/V17_V16_V15_V14_V13_V12_V10_V09_V08_V07_V06_06_MP34DT01_Microphone.SLDPRT

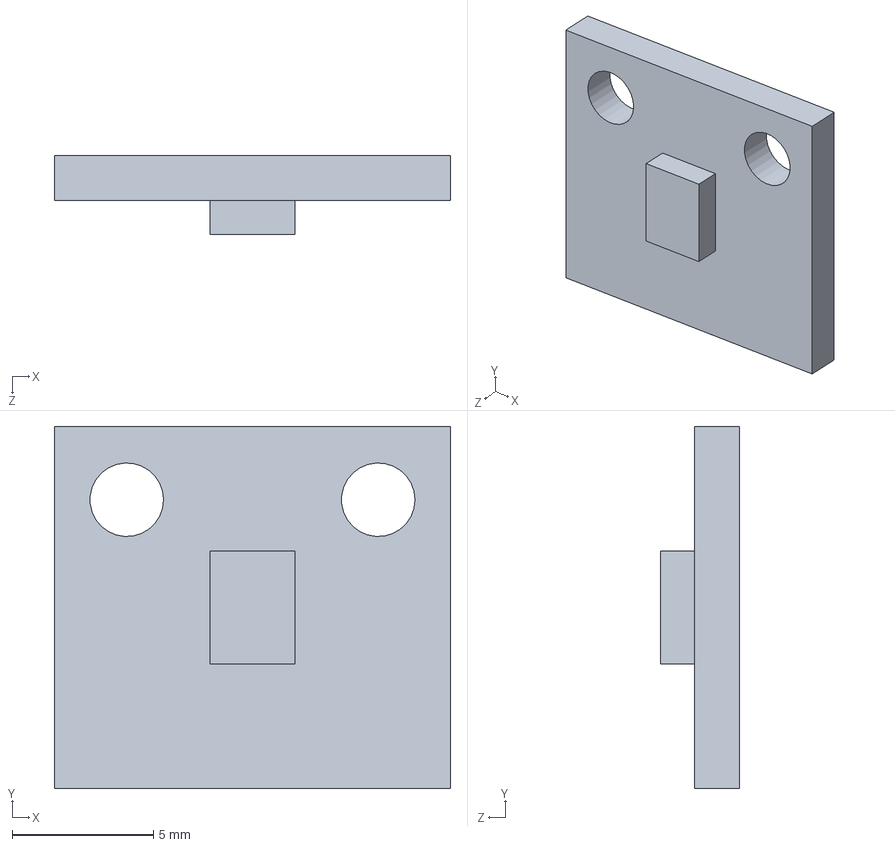
[picture p137: CAD file, 2026-11-03]
hardware/enclosure/preview/cad/V17_V16_V15_V14_V13_V12_V10_V09_V08_V07_V06_06_MP34DT01_Microphone.SLDPRT
14.0 x 12.8 x 2.80 mm
