quanxian318/jianwei-vibrometer/hardware/enclosure/preview/cad/V17_V16_V15_V14_V13_V12_Routes_SENSOR.SLDPRT

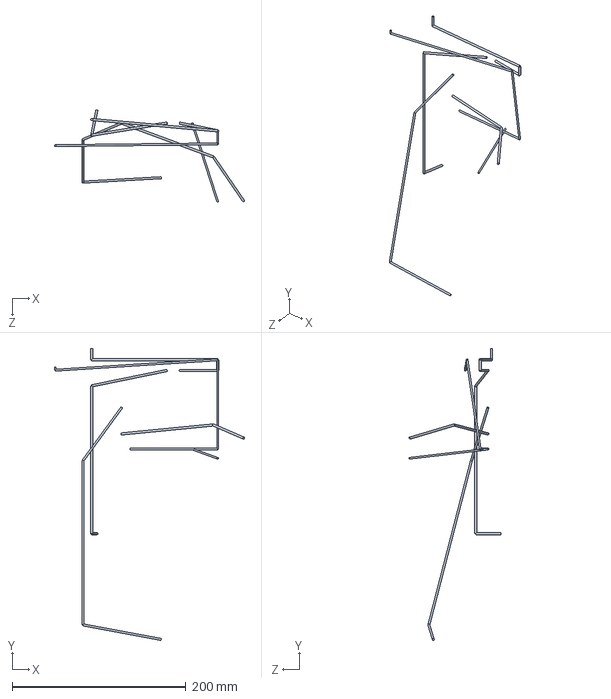
[picture p138: CAD file, 2026-11-03]
hardware/enclosure/preview/cad/V17_V16_V15_V14_V13_V12_Routes_SENSOR.SLDPRT
219.2 x 336.0 x 106.4 mm
