quanxian318/jianwei-vibrometer/hardware/enclosure/preview/cad/V17_V16_V15_V14_V13_V12_V10_V09_V08_V07_V06_16_LSM6DSV_IMU.SLDPRT

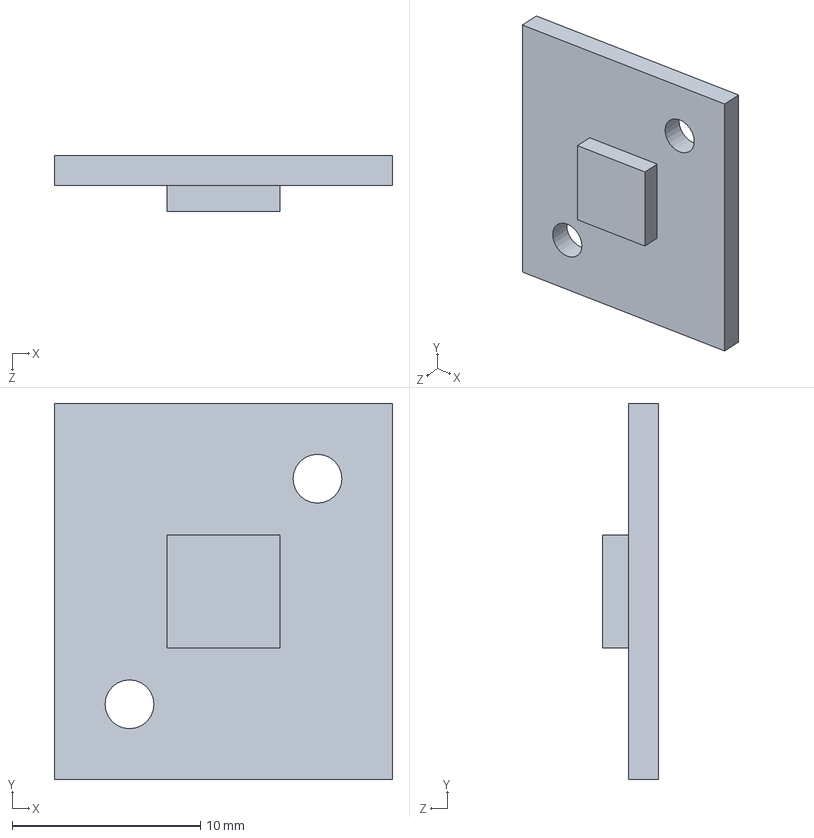
[picture p139: CAD file, 2026-11-03]
hardware/enclosure/preview/cad/V17_V16_V15_V14_V13_V12_V10_V09_V08_V07_V06_16_LSM6DSV_IMU.SLDPRT
18.0 x 20.0 x 3.00 mm
