quanxian318/jianwei-vibrometer/hardware/enclosure/preview/cad/V17_V16_V15_V14_V13_V12_V10_V09_V08_V07_V06_18_Internal_EM5820H.SLDPRT

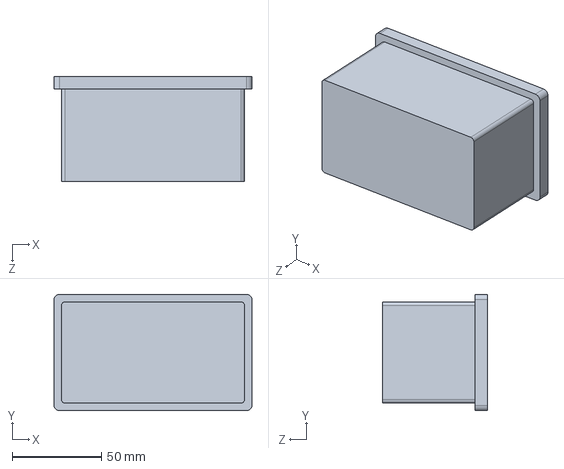
[picture p140: CAD file, 2026-11-03]
hardware/enclosure/preview/cad/V17_V16_V15_V14_V13_V12_V10_V09_V08_V07_V06_18_Internal_EM5820H.SLDPRT
111.2 x 65.3 x 58.8 mm
