quanxian318/jianwei-vibrometer/hardware/enclosure/preview/cad/V17_V16_V15_V14_V13_V12_Rubber_Pads_Reference.SLDPRT

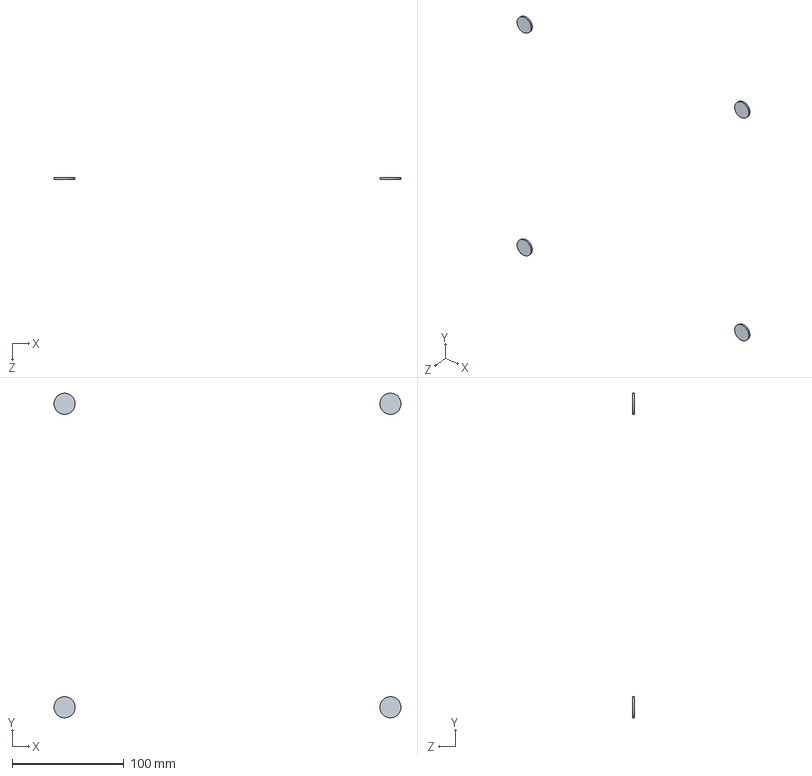
[picture p141: CAD file, 2026-11-03]
hardware/enclosure/preview/cad/V17_V16_V15_V14_V13_V12_Rubber_Pads_Reference.SLDPRT
311.0 x 291.0 x 2.00 mm
