quanxian318/jianwei-vibrometer/hardware/enclosure/preview/cad/V17_V16_V15_Control_PCB_Reference.SLDPRT

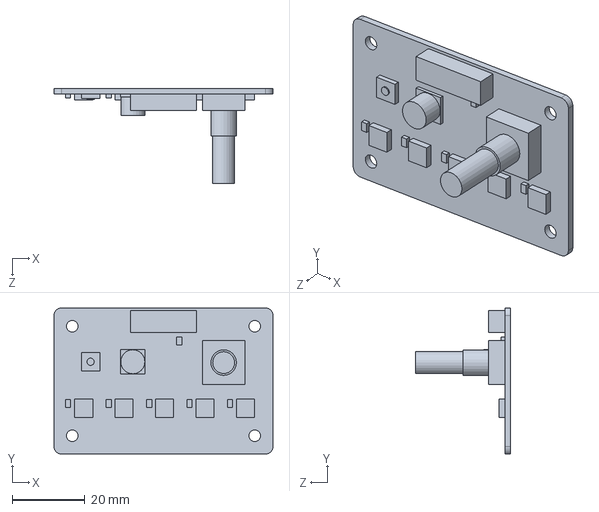
[picture p142: CAD file, 2026-11-03]
hardware/enclosure/preview/cad/V17_V16_V15_Control_PCB_Reference.SLDPRT
60.0 x 40.0 x 26.1 mm
