quanxian318/jianwei-vibrometer/hardware/enclosure/preview/cad/V17_V16_V15_V14_V13_V12_Routes_POWER.SLDPRT

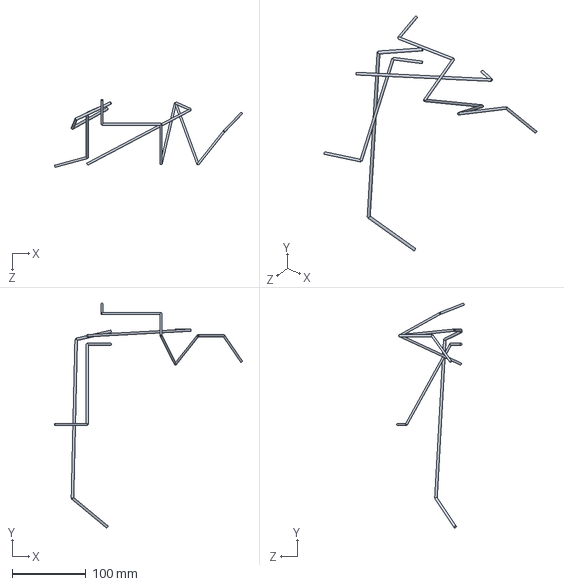
[picture p143: CAD file, 2026-11-03]
hardware/enclosure/preview/cad/V17_V16_V15_V14_V13_V12_Routes_POWER.SLDPRT
254.7 x 304.8 x 91.9 mm
