quanxian318/jianwei-vibrometer/hardware/enclosure/preview/cad/V17_Printable_Shell.step

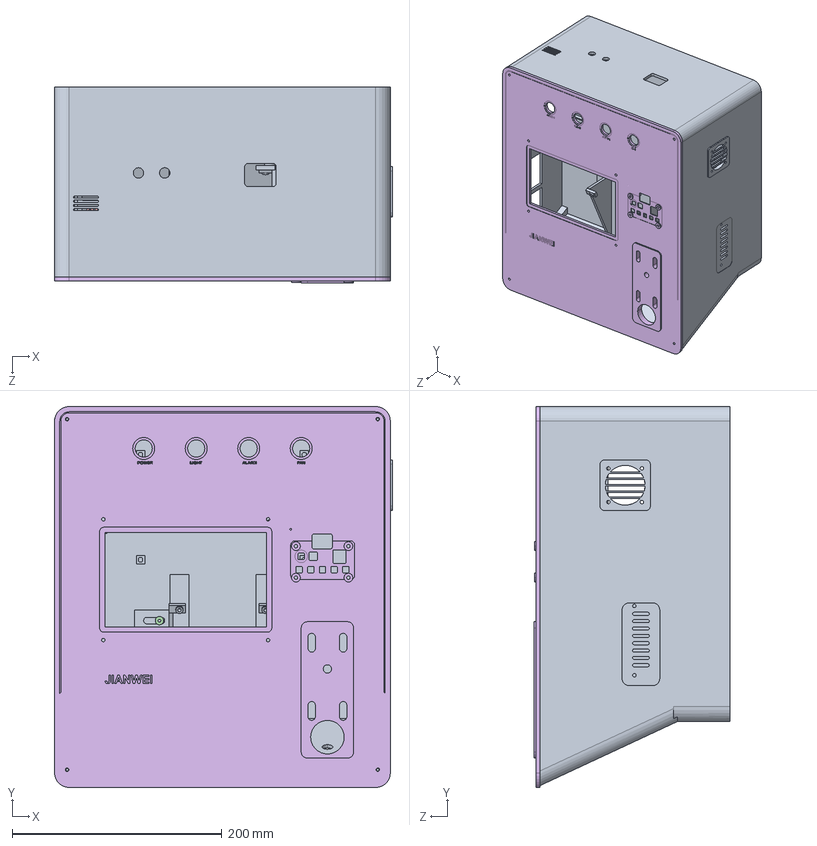
[picture p144: CAD file, 2026-11-03]
hardware/enclosure/preview/cad/V17_Printable_Shell.step
322.0 x 363.0 x 187.0 mm
V17_V16_01_Aligned_PC_Exits_Shell
V17_V16_V15_V14_Installed_M2_Spacers
V17_02_Original_Alarm_Bracket_Lid
