quanxian318/jianwei-vibrometer/hardware/enclosure/preview/cad/V17_V16_V15_V14_Installed_M2_Spacers.SLDPRT

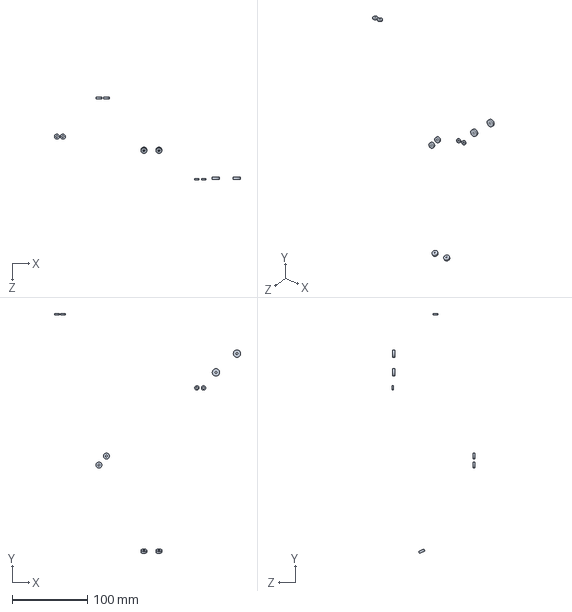
[picture p146: CAD file, 2026-11-03]
hardware/enclosure/preview/cad/V17_V16_V15_V14_Installed_M2_Spacers.SLDPRT
248.5 x 319.8 x 111.0 mm
