quanxian318/jianwei-vibrometer/hardware/enclosure/preview/cad/V17_V16_V15_V14_V13_V12_V10_V09_V08_V07_V06_19_Printer_Door_And_Paper.SLDPRT

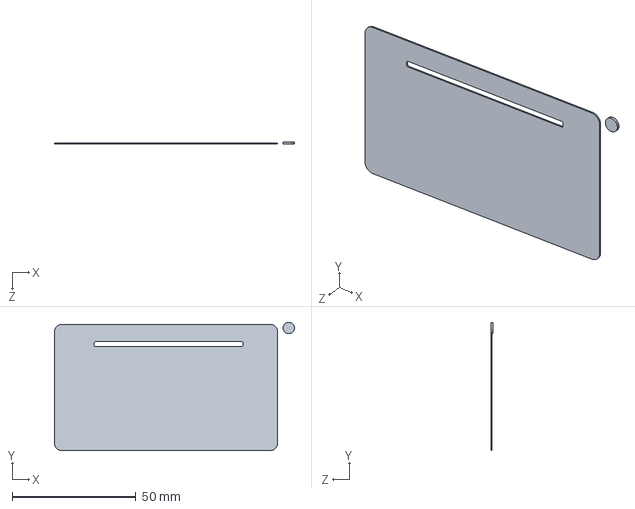
[picture p147: CAD file, 2026-11-03]
hardware/enclosure/preview/cad/V17_V16_V15_V14_V13_V12_V10_V09_V08_V07_V06_19_Printer_Door_And_Paper.SLDPRT
96.8 x 51.8 x 0.8 mm
