quanxian318/jianwei-vibrometer/hardware/enclosure/preview/cad/V17_V16_V15_V14_V13_V12_V10_V09_V08_V07_V06_04_TOF_Module.SLDPRT

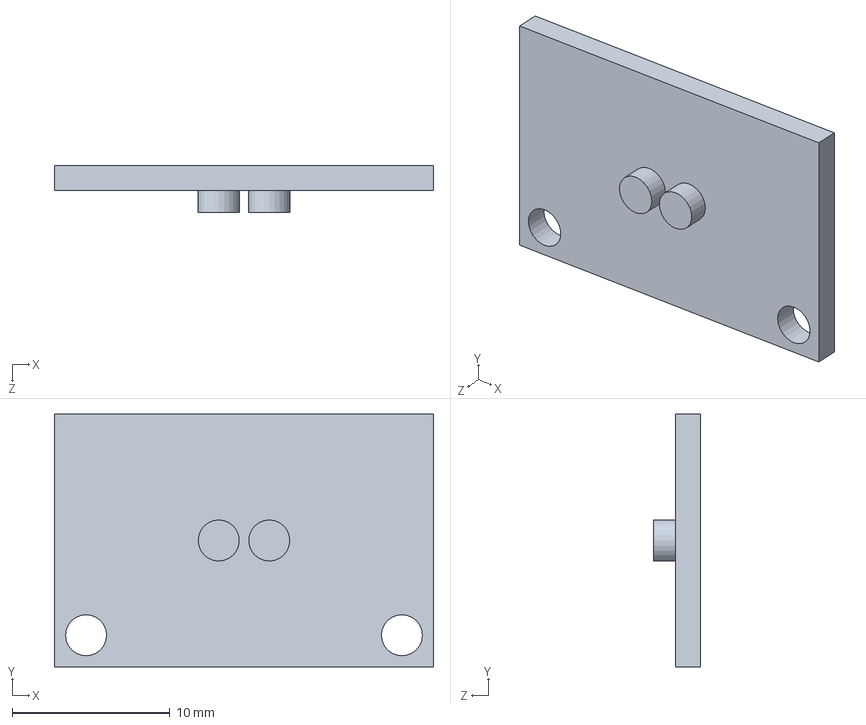
[picture p148: CAD file, 2026-11-03]
hardware/enclosure/preview/cad/V17_V16_V15_V14_V13_V12_V10_V09_V08_V07_V06_04_TOF_Module.SLDPRT
24.0 x 16.0 x 3.00 mm
