quanxian318/jianwei-vibrometer/hardware/enclosure/preview/cad/V17_V16_V15_V14_V13_V12_V10_V09_V08_V07_V06_36_Black_Camera_Lenses.SLDPRT

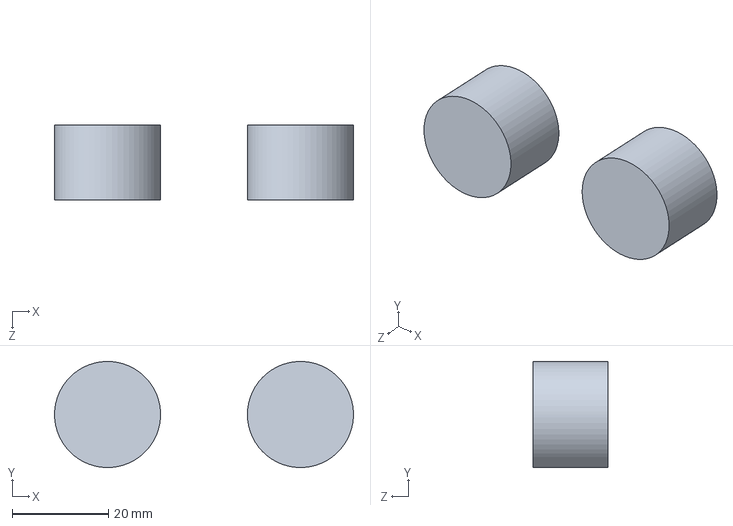
[picture p149: CAD file, 2026-11-03]
hardware/enclosure/preview/cad/V17_V16_V15_V14_V13_V12_V10_V09_V08_V07_V06_36_Black_Camera_Lenses.SLDPRT
62.0 x 22.0 x 15.5 mm
