quanxian318/jianwei-vibrometer/hardware/enclosure/preview/cad/V17_Installed_Estimate.step

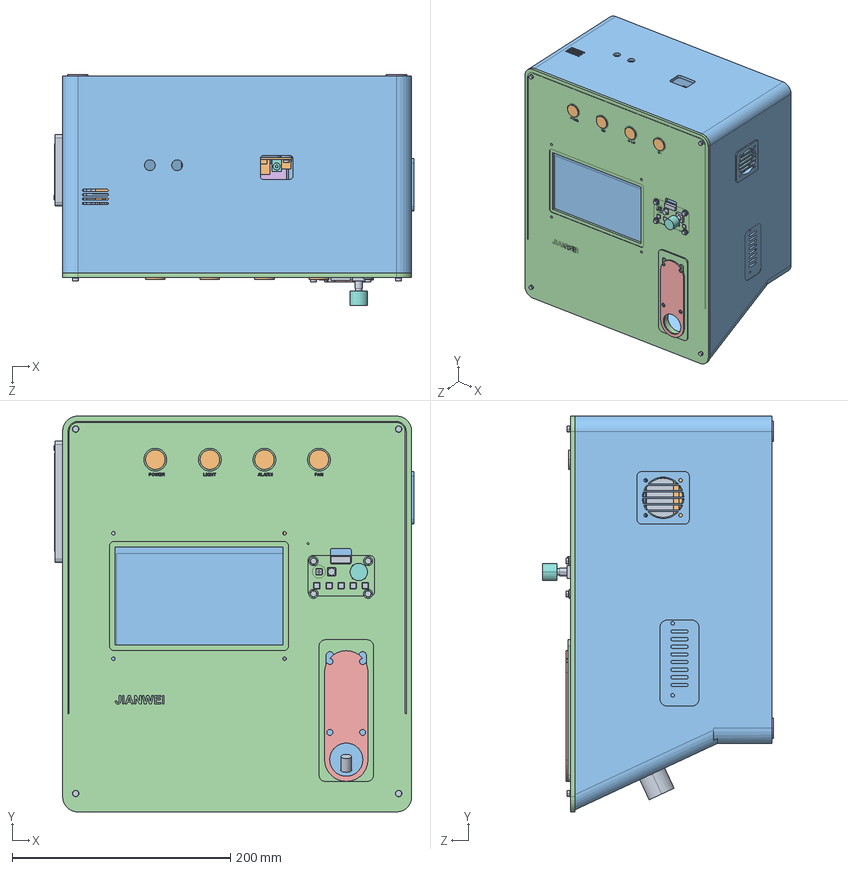
[picture p150: CAD file, 2026-11-03]
hardware/enclosure/preview/cad/V17_Installed_Estimate.step
329.8 x 363.0 x 211.4 mm
V17_V16_V15_V14_V13_V12_V10_V09_V08_V07_V06_03_Fill_Lights
V17_V16_V15_V14_V13_V12_V10_V09_V08_V07_V06_12_Main_PCB_ROTATED_180
V17_V16_V15_V14_V13_V12_V10_V09_V08_V07_V06_16_LSM6DSV_IMU
V17_V16_V15_V14_V13_V12_V10_V09_V08_V07_V06_36_Black_Camera_Lenses
V17_V16_V15_V14_V13_V12_V10_V09_V08_V07_V06_11_AN5642_PCB
V17_V16_V15_V14_V13_V12_V10_V09_V08_V07_V06_09_AX7010_FLAT
V17_V16_V15_V14_V13_V12_V10_V09_V08_V07_V06_10_Camera_Socket_Envelope
V17_V16_V15_V14_V13_V12_V10_V09_V08_V07_V06_35_PCB_J101_DC5525_REAR
V17_V16_V15_M3_Hardware_Reference
V17_V16_V15_V14_V13_V12_V10_V09_V08_V07_V06_05_Cross_Laser
V17_V16_V15_V14_V13_V12_V10_V09_V08_V07_V06_45_SIYOUFAN_SDB0412HD_4020
V17_V16_V15_V14_V13_V12_V10_V09_V08_V07_V06_04_TOF_Module
V17_V16_V15_V14_V13_V12_Base_M2_Assembly_References
V17_V16_V15_V14_V13_V12_V10_V09_V08_V07_V06_18_Internal_EM5820H
V17_V16_V15_V14_V13_V12_V10_V09_V08_V07_V06_17_GY_SHT40
V17_V16_V15_V14_V13_V12_V10_V09_V08_V07_V06_08_7423_Speaker
V17_V16_V15_V14_V13_V12_V10_V09_V08_V07_V06_19_Printer_Door_And_Paper
V17_V16_V15_V14_V13_V12_Rubber_Pads_Reference
V17_V16_V15_V14_V13_V12_V10_V09_V08_V07_V06_07_PN532_NFC
V17_V16_V15_Encoder_Knob_Reference
V17_V16_V15_Control_PCB_Reference
V17_V16_V15_V14_V13_V12_V10_V09_V08_V07_V06_06_MP34DT01_Microphone
V17_V16_V15_V14_V13_V12_V10_V09_V08_V07_V06_32_Official_Waveshare_Screen
V17_V16_V15_V14_V13_V12_Top_M2_Assembly_References
V17_V16_V15_V14_V13_V12_V10_V09_V08_V07_V06_15_Four_Panel_Switches
V17_V16_01_Aligned_PC_Exits_Shell
V17_02_Original_Alarm_Bracket_Lid
V17_Alarm_Bracket_Envelope_REFERENCE
