quanxian318/jianwei-vibrometer/hardware/enclosure/preview/cad/V17_V16_V15_V14_V13_V12_V10_V09_V08_V07_V06_05_Cross_Laser.SLDPRT

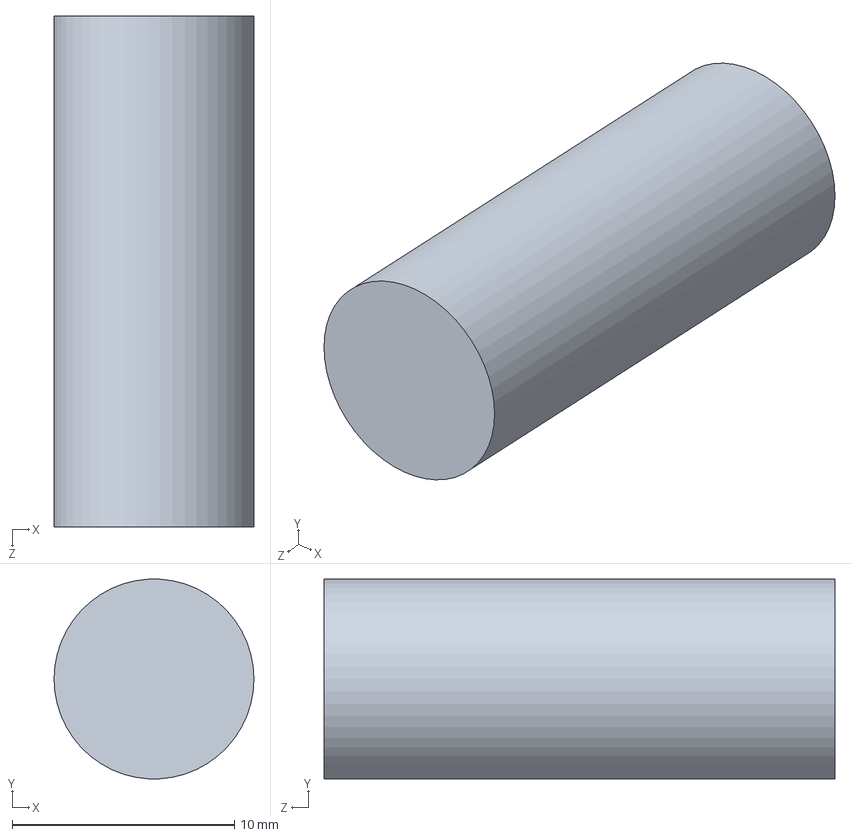
[picture p151: CAD file, 2026-11-03]
hardware/enclosure/preview/cad/V17_V16_V15_V14_V13_V12_V10_V09_V08_V07_V06_05_Cross_Laser.SLDPRT
9.00 x 8.98 x 23.0 mm
