quanxian318/jianwei-vibrometer/hardware/enclosure/preview/cad/V17_V16_V15_V14_V13_V12_Routes_LOAD.SLDPRT

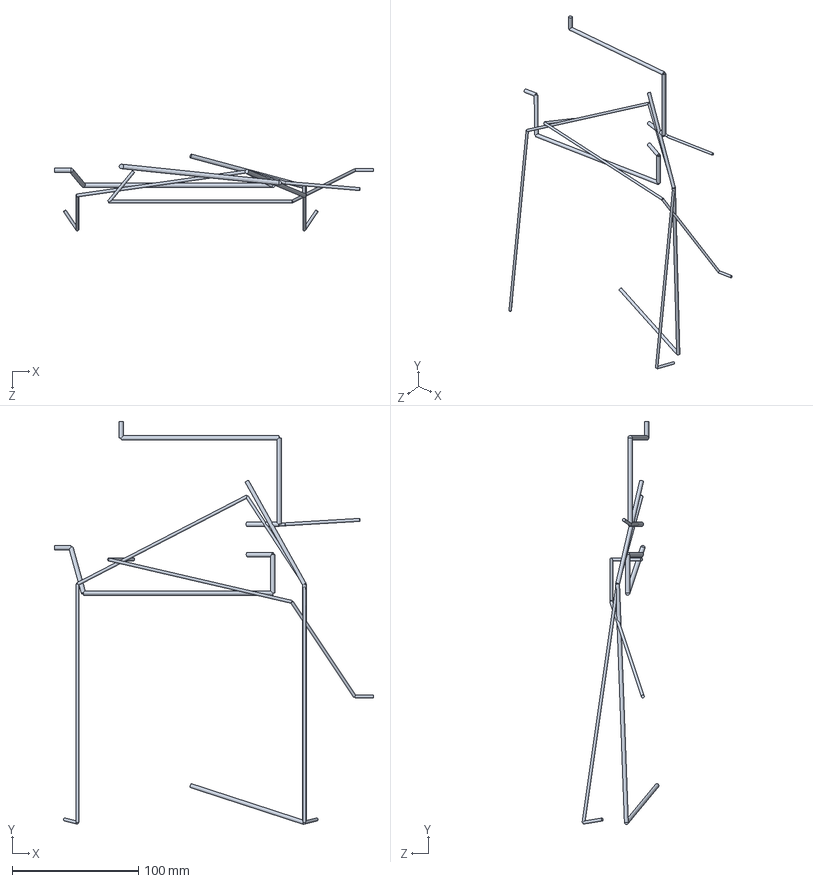
[picture p152: CAD file, 2026-11-03]
hardware/enclosure/preview/cad/V17_V16_V15_V14_V13_V12_Routes_LOAD.SLDPRT
253.2 x 319.5 x 61.0 mm
