quanxian318/jianwei-vibrometer/hardware/enclosure/preview/cad/V17_V16_V15_V14_V13_V12_Routes_RIBBON.SLDPRT

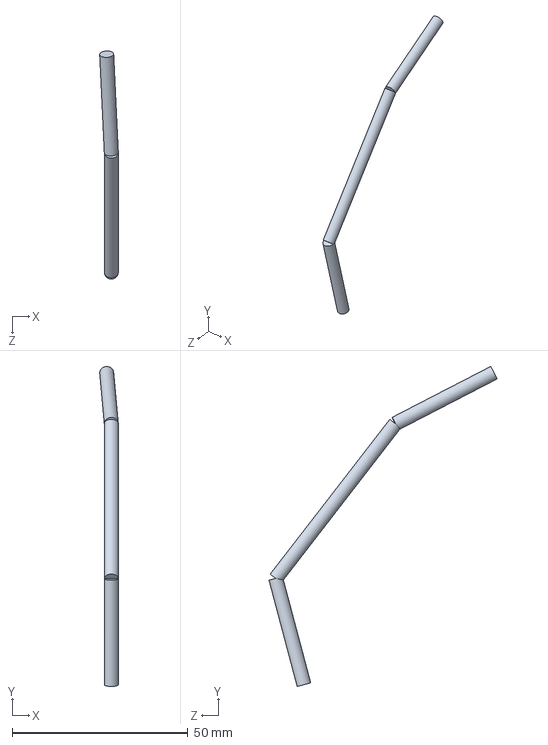
[picture p153: CAD file, 2026-11-03]
hardware/enclosure/preview/cad/V17_V16_V15_V14_V13_V12_Routes_RIBBON.SLDPRT
5.32 x 91.0 x 64.8 mm
