quanxian318/jianwei-vibrometer/hardware/enclosure/preview/cad/V17_V16_Routes_DATA.SLDPRT

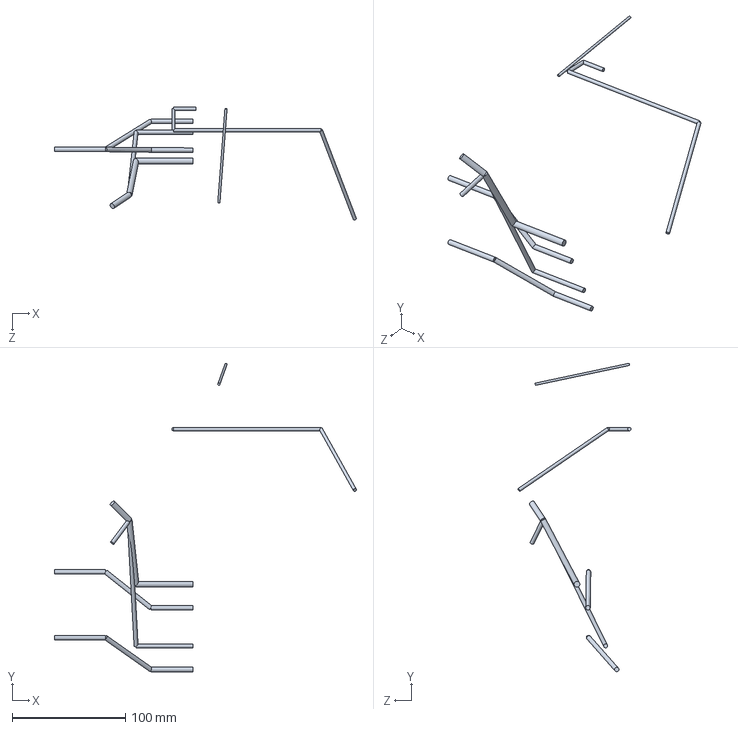
[picture p154: CAD file, 2026-11-03]
hardware/enclosure/preview/cad/V17_V16_Routes_DATA.SLDPRT
266.4 x 272.2 x 99.8 mm
