quanxian318/jianwei-vibrometer/hardware/enclosure/preview/cad/V17_V16_V15_V14_V13_V12_V10_V09_V08_V07_V06_10_Camera_Socket_Envelope.SLDPRT

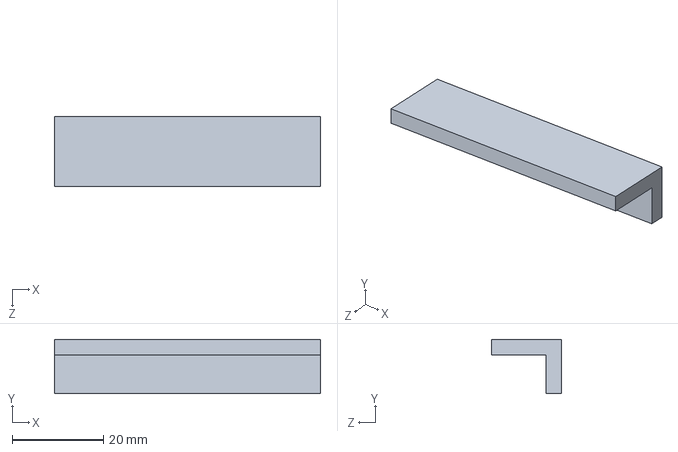
[picture p155: CAD file, 2026-11-03]
hardware/enclosure/preview/cad/V17_V16_V15_V14_V13_V12_V10_V09_V08_V07_V06_10_Camera_Socket_Envelope.SLDPRT
58.4 x 11.9 x 15.4 mm
