quanxian318/jianwei-vibrometer/hardware/enclosure/preview/cad/V17_V16_V15_V14_V13_V12_V10_V09_V08_V07_V06_08_7423_Speaker.SLDPRT

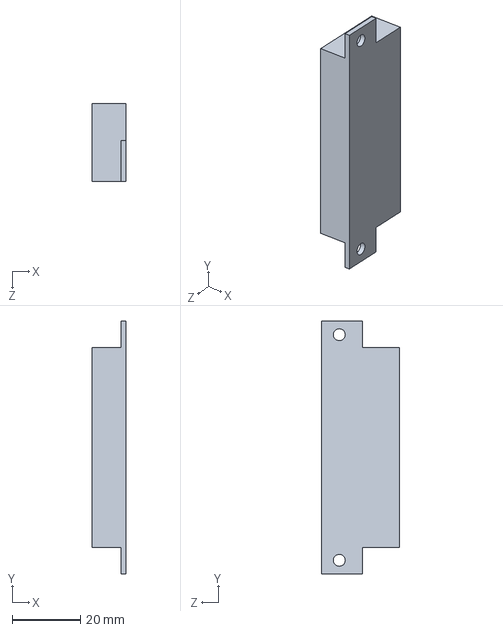
[picture p156: CAD file, 2026-11-03]
hardware/enclosure/preview/cad/V17_V16_V15_V14_V13_V12_V10_V09_V08_V07_V06_08_7423_Speaker.SLDPRT
10.0 x 74.0 x 22.7 mm
