quanxian318/jianwei-vibrometer/hardware/enclosure/preview/cad/V17_V16_V15_V14_V13_V12_V10_V09_V08_V07_V06_45_SIYOUFAN_SDB0412HD_4020.SLDPRT

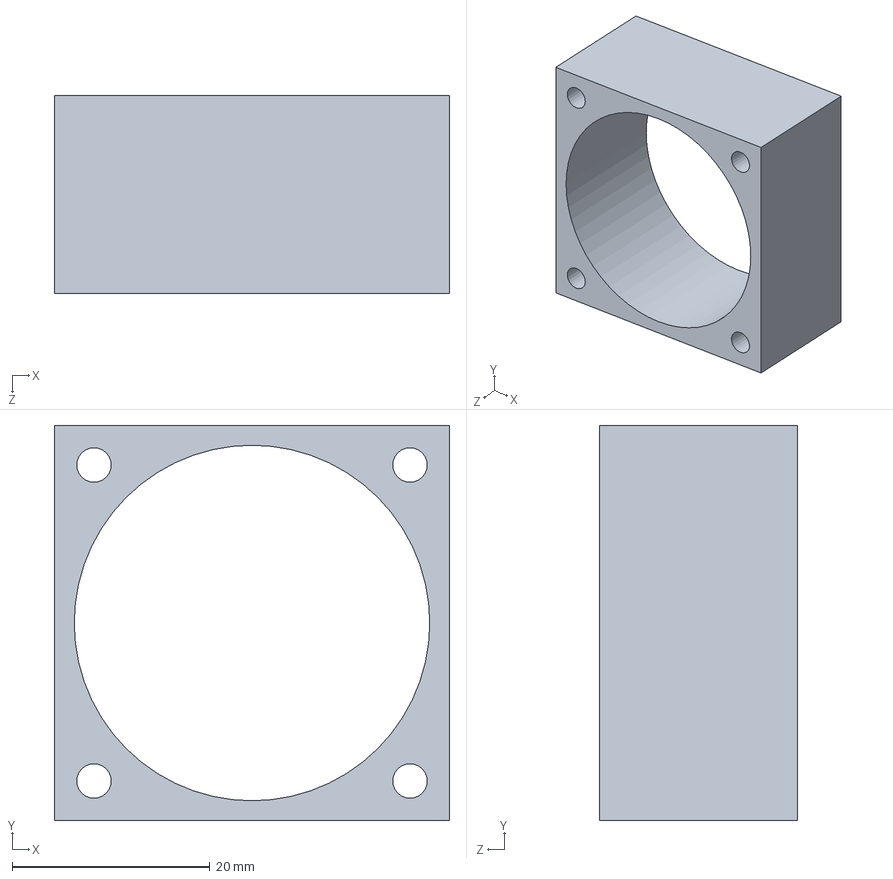
[picture p157: CAD file, 2026-11-03]
hardware/enclosure/preview/cad/V17_V16_V15_V14_V13_V12_V10_V09_V08_V07_V06_45_SIYOUFAN_SDB0412HD_4020.SLDPRT
40.0 x 40.0 x 20.0 mm
