quanxian318/jianwei-vibrometer/hardware/enclosure/preview/cad/V17_V16_V15_V14_V13_V12_V10_V09_V08_V07_V06_09_AX7010_FLAT.SLDPRT

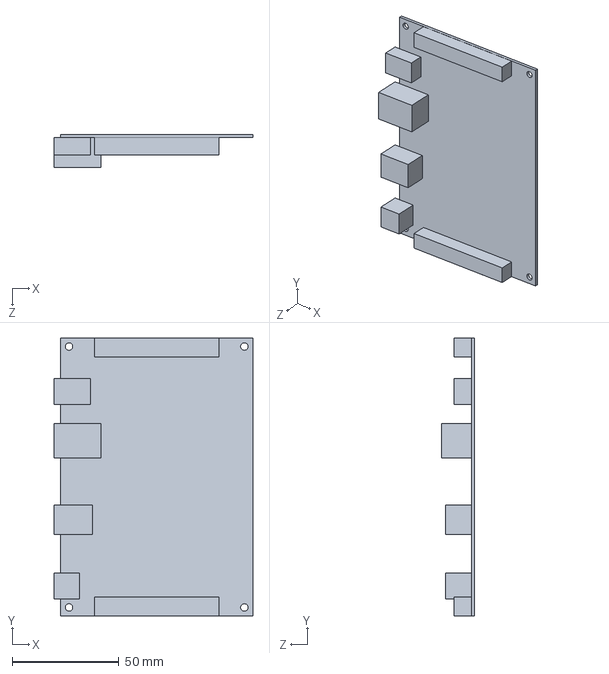
[picture p158: CAD file, 2026-11-03]
hardware/enclosure/preview/cad/V17_V16_V15_V14_V13_V12_V10_V09_V08_V07_V06_09_AX7010_FLAT.SLDPRT
93.0 x 130.0 x 15.6 mm
