quanxian318/jianwei-vibrometer/(list of files, cad)

Other CAD files:
hardware/enclosure/print/PRINT_02_Original_Alarm_Bracket_Lid.stl
hardware/enclosure/preview/cad/V17_f16-2.stp
hardware/enclosure/preview/cad/V17_V16_01_Aligned_PC_Exits_Shell.SLDPRT
hardware/enclosure/preview/cad/V17_02_Original_Alarm_Bracket_Lid.SLDPRT
hardware/enclosure/preview/cad/V17_Installed_Estimate.SLDASM
hardware/enclosure/preview/cad/V17_Printable_Shell.SLDASM
