quanxian318/jianwei-vibrometer/docs/app_guide.md

# 见微测振 APP 1.0.5

配套见微视觉测振仪的 APP（Android、iOS、Windows 三个版本共用同一套界面），以及为它新增的设备侧接口：AX7010 局域网 API 和 Nano ESP32 Wi-Fi 网关。

- Android：[`dist/JianweiVibro-1.0.5.apk`](../src/mobile_app/dist/JianweiVibro-1.0.5.apk)（约 940 KB，Android 7.0 及以上，v2 签名；1.0.x 同一签名，可直接覆盖安装）
- Windows：[`dist/JianweiVibro-1.0.5-windows-x64.zip`](../src/mobile_app/dist/JianweiVibro-1.0.5-windows-x64.zip)（约 870 KB，Windows 10/11 x64，解压后运行 `JianweiVibro.exe`，需系统自带的 Edge WebView2 运行时）
- iOS：[`dist/JianweiVibro-1.0.5-ios-unsigned.ipa`](../src/mobile_app/dist/JianweiVibro-1.0.5-ios-unsigned.ipa)（约 1.1 MB，iOS 14 及以上），由 GitHub Actions 在 macOS 上编译后提交（见 §5.3）。**未签名**，需用自己的 Apple ID 通过 Sideloadly / AltStore 等工具重签安装，或在 Mac 上用 Xcode 打开 `ios/` 工程直接装到手机
- 源码：[`src/mobile_app`](../src/mobile_app)
- 截图：[截图](app_screens)，用演示模式在 390×844 手机视口中渲染

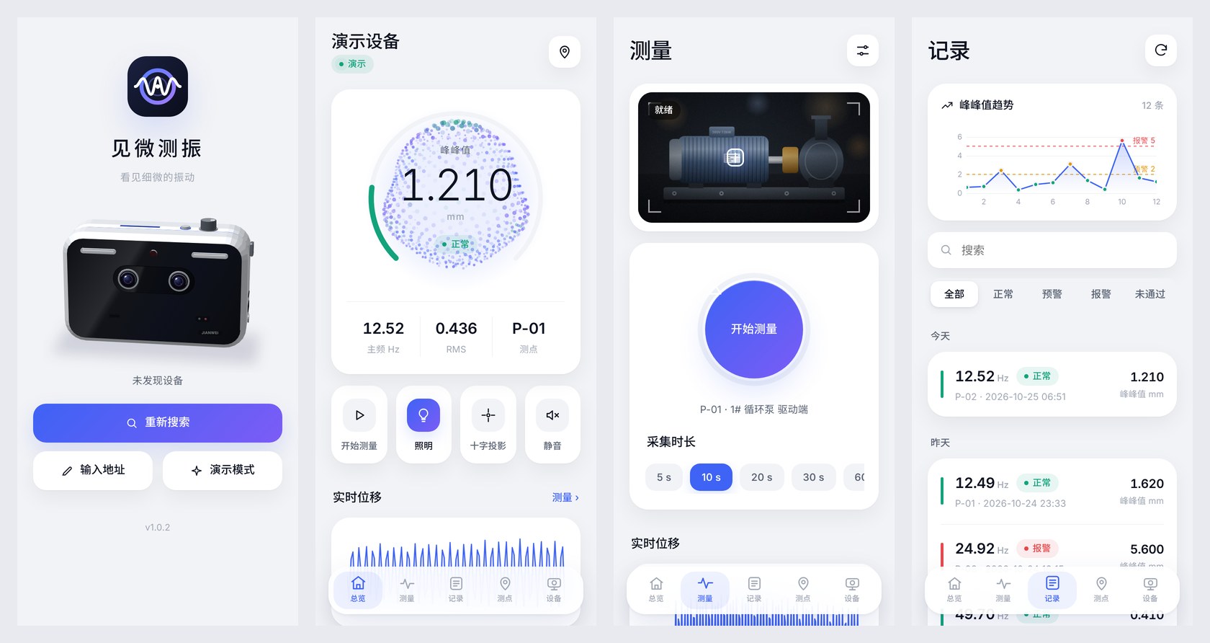
[picture p159: docs/app_screens/screen_01.jpg]
连接、总览、测量与记录

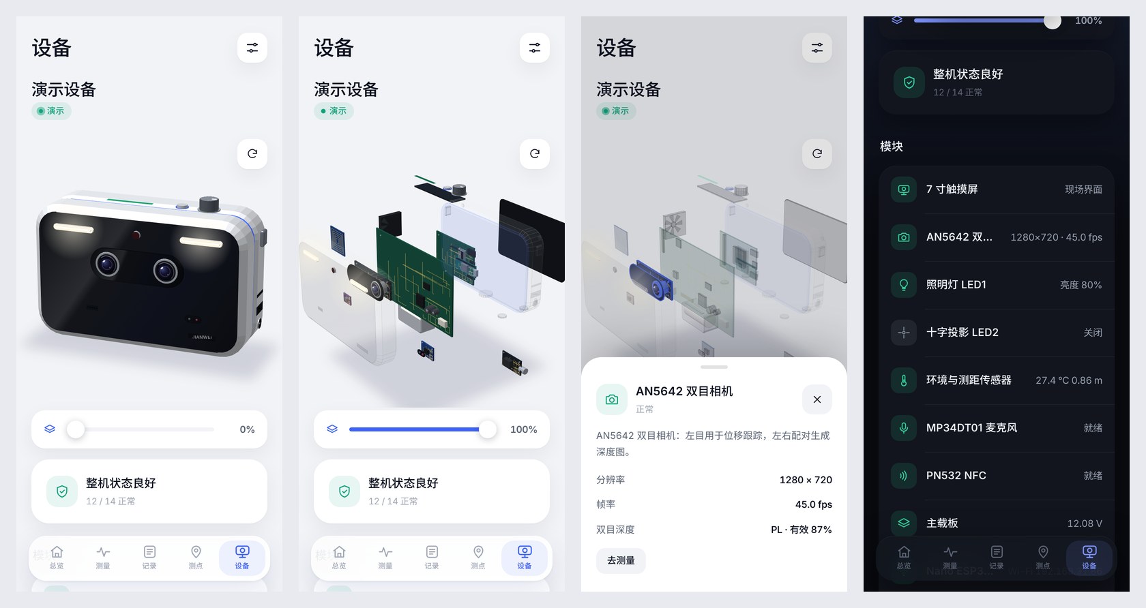
[picture p160: docs/app_screens/screen_03.jpg]
设备数字孪生与爆炸视图


## 1. 功能

| 页面 | 内容 |
|---|---|
| 连接 | 3D 产品模型首屏；UDP 广播搜索设备，同时探测网关固定地址 192.168.4.1 和最近用过的设备；可手动输入地址；**演示模式**不需要硬件 |
| 总览 | 动态粒子球与环形表：粒子沿球面传播的波纹随主频变化，颜色随判级变化；中心显示峰峰值、判级、主频、RMS 和测点。还有四个快捷键（测量、照明、十字投影、静音）、实时位移曲线、环境数据（温湿度、测距、功率）、最近记录，报警与预警横幅可一键确认 |
| 测量 | 相机实时画面（局域网直连）带取景框和测量框，点按画面即可移动测量框；开始/结束按钮带进度环；采集时长 5–60 s；照明亮度与十字投影开关；实时位移曲线可触摸读数；多点测振的停机基线采集；上次结果卡片 |
| 记录 | 峰峰值趋势（标出预警/报警线），可搜索，按判级筛选，按日分组。详情页有时域波形、频谱（标注峰值）和 **3D 时频瀑布图**（由波形做短时 FFT，可拖动旋转），还有质量指标、采集条件，以及打印报告、导出 CSV/JSON 到「下载」、分享摘要 |
| 测点 | 当前测点（NFC 或手动切换），按判级统计；测点列表带趋势小图；测点详情含峰峰值趋势、主频变化和历史记录，可一键设为当前测点并开始测量 |
| 设备 | **3D 数字孪生**：可旋转（带惯性）、双指缩放；**滑动条无级调节爆炸程度**，外壳先打开，内部各层依次飞出；点击任一部件高亮并显示实时状态与操作。14 个模块：触摸屏、AX7010、主载板、双目相机、照明、十字投影、ESP32、NFC、传感器、麦克风、前面板、打印机、电源、风扇；指示灯条按判级变色，风扇运行时叶片转动，屏幕显示实时波形。另有模块列表、系统数据、测量与报警设置、网络与 Wi-Fi（网关扫描、热点开关与密码）、用手机时间校准设备时钟、测试提示音、切换设备、安全关机 |
| 设置 | 采集时长、测量方向、报警阈值、蜂鸣器、自动照明与亮度、测量时关闭投影、语音与音量、状态灯亮度、风扇模式；外观**浅色（默认）/ 深色 / 跟随系统**；自动校准设备时间 |
| 关于 | 版本、隐私政策、用户协议 |

交互：底部标签栏指示器随切换滑动；左右滑动切换标签页，页面跟手移动；详情页从左边缘右滑返回；Android 返回键先关闭弹层或详情页。新结果出现时会提示，预警/报警时手机振动、记录标签显示红点；采集期间屏幕保持常亮。

设计：浅色为默认的瓷白中性色，配钴蓝到紫的单一强调色，卡片用柔和阴影而不加描边。字体为内置的 Inter（数字与西文，等宽数字）和 Noto Sans SC 子集（400/500/700，只含 APP 用到的约 540 个汉字，共约 210 KB，其他字符回落到系统字体），两者均为 SIL OFL 1.1 许可。3D 效果全部用 Canvas 2D 自绘，不依赖 WebGL 或第三方库，可离线运行。

## 2. 连接方式

| 方式 | 适用 | 功能 |
|---|---|---|
| 局域网直连 AX7010 | 设备网口与手机接同一路由器 | 全部功能：实时画面、实时波形、完整记录与原始文件、移动测量框、为 Nano 配网 |
| ESP32 Wi-Fi 网关 | 现场无路由器：手机连设备热点 `VIBMON-xxxx`（默认密码 `vibmon2026`，地址 192.168.4.1）；ESP32 也可同时连现场 Wi-Fi | 状态、启停测量、照明/投影/静音、测点、设置、最近 6–8 条记录与最新一次曲线（每条约 48 点）、网关自身的 Wi-Fi 配置；不含相机画面和原始文件 |

默认在同一局域网直接连接，可选启用配对。可在 vibmond 设置 `app_api.require_pairing=true`，此时 APP 请求配对码，设备屏幕显示 6 位码（120 s 有效，连错 5 次作废），APP 输入后获得令牌，令牌保存在 `app_tokens.json`。

## 3. 接口（API v1）

两种连接使用同一套 JSON 接口，前缀 `/api/v1/`，响应为 `{"ok":true,"data":…}` 或 `{"ok":false,"error":"…"}`，并带 CORS 头。

| 方法 路径 | AX7010（端口 8080） | 网关（端口 80） |
|---|---|---|
| GET info | 设备号、名称、版本、端口、是否需配对 | 同左，另含 `ax_online` |
| GET live | 精简实时状态（与网关同一结构，见下），附最近 300 个位移采样 `wave`（像素，乘 `mmpx` 为毫米） | AX 每 2 s 或状态变化时推送的快照，另含 `gw.age_ms`、`gw.ax_online`（快照超过 8 s 视为离线） |
| GET status / settings / points | 完整 `status`、设置、NFC 测点表 | live 快照、设置、测点 |
| POST command `{"cmd":…}` | 同步执行，白名单：measure_start、baseline_start、measure_stop、light、laser、mute、set_point、print、voice、set、rtc_set、zoom_reset、status、settings、roi、nano_status、set_net、shutdown、stereo_distance | 返回 202 `{"cid"}`，经 APP_COMMAND 事件转给 AX；用 GET command/<cid> 轮询结果（15 s 超时）。白名单同左，但不含 status、settings、roi、nano_status、set_net、stereo_distance |
| GET records、records/<id> | 记录列表；详情为 record.json＋抽稀后的波形（保留包络）与频谱（保留峰值），默认 ≤2000 点 | 最近记录；仅最新一次测量有曲线（`partial:true`） |
| GET records/<id>/files/<name> | 原始 record.json / waveform.csv / spectrum.csv / acoustic.wav | — |
| GET preview.bmp?w= | 相机预览（24 位 BMP，≤640 宽） | — |
| GET/POST net、GET net/scan | — | 站点与热点状态；连 Wi-Fi `{ssid,password}`、热点 `{ap_enabled,ap_password}`；异步扫描 |
| POST pair/request、pair、unpair | 仅 `require_pairing` 时使用 | — |

设备发现：向 UDP 48300 端口发送 `VIBMON_DISCOVER`，AX 与网关各自单播回复 info 的 JSON。网关另有 mDNS `vibmon-xxxx.local`（服务 `_vibmon._tcp`）。

`mute` 命令带 `{"on":false}` 时取消静音（不带参数或 on 为 true 时静音并确认报警，屏幕 K1 不变）。

live 字段：`dev ver ms el dur cam method bl roi[cx,cy,w,h] cal unit lv mute light{on,pct,ok} laser pt{id,name,uid} pwr{v,a,w,warn,pf} tc rh dist tach fan prn msg tv utc nano{on,wifi,ip,sd,nfc} st{on,be,vf} ac set{dur,warn,alarm,axis} last{id,ok,why,u,hz,clr,amp,pp,rms,lv,saved,ac_hz} fps fw fh mp{win,hz}`；不含 wave 时不超过 900 字节，可装入一帧协议。

### 协议 V1.1 扩展（PS↔Nano，`shared/vibproto`）

| 方向 | 操作码 / 事件 | 载荷 |
|---|---|---|
| AX→Nano 请求 | `PUBLISH 0x60` | `{"topic":"status"|"settings"|"points"|"records"|"curves","data":{…}}`，每个主题一帧（≤900 字节）；Nano 只缓存最新一份 |
| AX→Nano 请求 | `COMMAND_RESULT 0x62` | `{"cid","ok","error"?,"data"?}`（data ≤600 字节） |
| Nano→AX 事件 | `APP_COMMAND` | `{"cid","cmd","args":{…}}`，args ≤240 字节（事件上限 384 字节） |
| Nano→AX 事件 | `APP_CLIENT` | `{"client":"192.168.4.2"}`：新手机接入时，设备屏幕提示「手机APP已连接」 |

Nano 在 HELLO 的 capabilities 中声明 `app_gateway`；AX 只向声明了它的固件发布。旧固件不受影响，AX 不发布即可。新会话或 Nano 重启后，AX 重新发布全部主题。新操作码同样经过序号重放缓存，重试不会重复执行。

## 4. 软件模块

- **AX7010 vibmond**：
  - `src/app/http_server.*`：事件循环上的极简 HTTP/1.1 服务器，非阻塞写、超时清理。
  - `src/app/app_api.*`：路由、可选配对、UDP 发现、记录抽稀、BMP 预览。
  - `src/app/app_remote.cpp`：liveJson、向网关发布、处理 APP_* 事件。
  - 配置新增 `app_api` 和 `app_gateway` 两段（见 `config/vibmon.json`）。
  - 修复：新的 API 层按状态枚举输出判级代码（最初的映射值错误，已用测试覆盖）。
- **Nano ESP32**：
  - `app_gateway.*`：可移植核心，含主题缓存、命令转发与超时、HTTP 路由，主机可测。
  - `http_gateway.*`：WebServer、UDP 发现与 mDNS。
  - `net_service`：同时开热点和站点（AP+STA），热点固定 192.168.4.1，支持异步扫描。
  - `settings`：保存热点开关与密码。
  - `router`：处理 0x60/0x62，HELLO 声明 app_gateway。
  - USB 控制台：`ap on|off`、`ap pass <密码>`。
  - 配套固件版本为 0.2.3。
- **APP**（`mobile_app`）：
  - `web/`：界面，无构建步骤，桌面浏览器直接打开 `web/index.html` 即可预览演示模式。
  - `android/`：Java 外壳与资源。
  - `tools/`：图标、字体与 APK 构建脚本。

## 5. 构建

### 5.1 Android

```bash
cd src/mobile_app
tools/build_apk.sh          # -> dist/JianweiVibro-<版本>.apk
```

构建不需要 Android SDK，全部用 Maven Central 上的构件：apktool-lib 3.0.3 中的 aapt2 与 framework 资源、dalvik-dx 16.0.1、apksig 2.3.0，以及 Robolectric android-all 14（API 34 类库，仅用于编译）。另需 JDK 17 或更高版本、python3、curl、unzip。

签名密钥 `android/keystore/release.p12` 在首次构建时生成，不提交到仓库。之后的构建必须使用同一把密钥，才能覆盖安装；本次的 APK 由云端生成的密钥签名，以后在本机重新构建会生成新密钥，需要先卸载旧版再安装。应用商店上架需要换成正式密钥和 AAB 格式。

图标和字体的源脚本是 `tools/make_icons.py` 与 `tools/make_fonts.py`（需要 Pillow 与 fonttools）；界面新增中文后，需重新运行 make_fonts。

3D 模型使用真实主载板和前面板制造文件生成的板图，纹理及坐标随 web/ 源码提供。生成工具为 tools/gen_pcb_twin.py，硬件制造文件见 hardware/pcb。

### 5.2 Windows

```bash
tools/build_windows.sh      # -> dist/JianweiVibro-<版本>-windows-x64.zip
```

`windows/main.cpp` 用 webview 0.12.0（MIT）创建 Edge WebView2 窗口，加载同目录下的 `web/`，并提供与 Android 相同的 `VibmonNative` 原生接口：UDP 发现（向每个网卡的广播地址和 192.168.4.1 发送）、导出到「下载」文件夹、分享改为复制到剪贴板、深色标题栏、采集时保持屏幕常亮。在 Linux 上用 MinGW-w64 交叉编译（静态链接，单个 exe，不需要 WebView2Loader.dll）。WebView2.h 取自 webview_go 随附的微软 SDK 1.0.1150.38，其 133 个接口 ID 已与 windows-rs 的 webview2-com-sys 绑定逐一比对一致；两个头文件按 SHA256 固定。

### 5.3 iOS

`ios/` 是 Swift 外壳（WKWebView＋同名原生接口）：分享与导出走系统分享面板（可存到「文件」），常亮用 `isIdleTimerDisabled`。iOS 发送广播需要苹果单独批准的组播权限，所以发现时除受限广播与 192.168.4.1 外，还向当前 Wi-Fi 网段（不超过 /22）逐个单播探测，只需「本地网络」授权。工程由 XcodeGen 从 ios/project.yml 生成，在 macOS 上使用 Xcode 编译。提供的 iOS 1.0.5 包完成了模拟器运行检查，Windows 1.0.5 包通过 --selftest 检查页面、3D 模型与原生接口。

在 Mac 上自行编译：`brew install xcodegen && cd ios && xcodegen generate`，用 Xcode 打开 `JianweiVibro.xcodeproj`，选择自己的开发团队后运行到手机。

## 6. 验证

| 项目 | 结果 |
|---|---|
| vibmond 主机单测 | 12 组全部通过 |
| 应用集成检查（`tests/test_app_host.py`） | 103 项通过（原 65 项，新增 38 项）。覆盖 UDP 发现、可选配对与令牌、CORS、live 字段与 900 字节上限、命令白名单、经 APP 测量、记录列表与详情、抽稀后频谱保留 9 Hz 峰、CSV 下载、路径穿越拒绝、BMP 预览、取消配对、默认免配对。另用 pty 模拟 Nano 网关验证：HELLO 声明 app_gateway、各主题发布、APP_COMMAND 执行与回复、不在白名单的命令被拒、APP_CLIENT 提示、经网关测量后曲线保留 7 Hz 峰，且每帧 ≤1024 字节 |
| 冒烟测试、协议 4＋300 向量 | 通过 |
| ARM 交叉编译 vibmond（静态，Cortex-A9） | 无警告 |
| 网关核心主机测试（`nano_esp32/test/test_app_gateway.cpp`） | 通过：离线 503、快照与 age、陈旧判离线、新客户端只提示一次、命令转发/完成/超时、坏 JSON 与过大参数、记录与 lan_only、网络钩子、新会话清空 |
| Nano 改动的 Arduino 源 | Nano 0.2.3 已使用实际 Arduino Nano ESP32 板包完成编译、镜像校验、烧录和整机联调，记录见 data/nano_build_validation.json |
| APK | aapt2 读取包信息：com.jianwei.vibro 1.0.5，minSdk 24，targetSdk 34；apksig 校验 v2 签名通过 |
| 界面 | 在 Chromium 手机视口中走查各页面（演示模式，浅色/深色），无脚本错误 |
| Windows 1.0.5 | GitHub Actions 的 Windows 机器上运行提交的 zip（`--selftest`）：约 8 s 内加载页面，主载板/前面板板图、3D 首屏与 8 个原生接口均就绪，原生 UDP 发现执行完成（该机器无设备，返回空）；结果与首屏截图见 [构建验证](../src/mobile_app/dist) |
| iOS 1.0.5 | GitHub macOS 机器上 XcodeGen 生成工程，编译出未签名 IPA；模拟器 iPhone 中安装运行，连接页、总览、测量、设备爆炸视图截图见 [构建验证](../src/mobile_app/dist)（CI 运行 40313377113） |

## 设备连接

APP 已完成与 AX7010、Nano 网关的整机对接，手机和电脑可以查看测量结果、控制测量与基线采集，并接收报警。Nano 固件为 0.2.3。Android、iOS、Windows 的安装和签名步骤按各平台说明执行。
