quanxian318/jianwei-vibrometer/hardware/enclosure/preview/renders/01_Printable_Shell.png

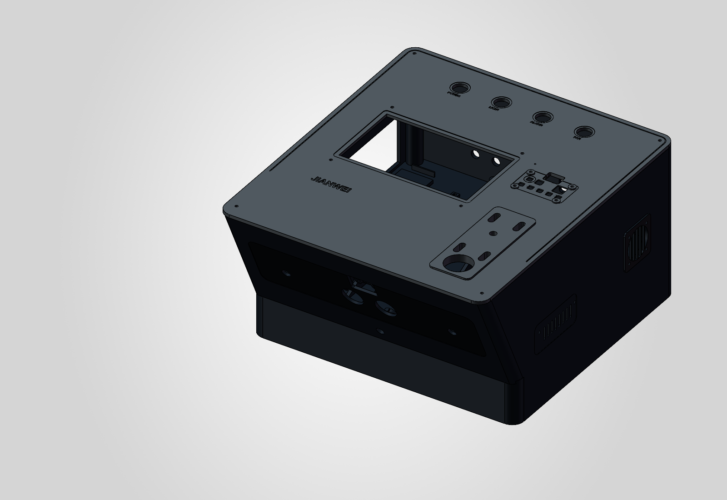
hardware/enclosure/preview/renders/01_Printable_Shell.png
