quanxian318/jianwei-vibrometer/hardware/enclosure/preview/renders/02_Installed_Estimate.png

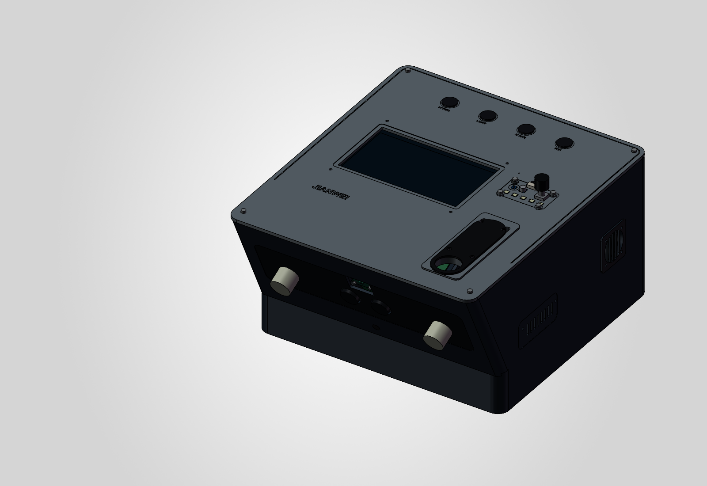
hardware/enclosure/preview/renders/02_Installed_Estimate.png
