quanxian318/jianwei-vibrometer/report/mechanical_and_measurement_skill_notes.md

# 设计报告补充段落

开发中将三类重复判断提炼为技能包。定点核对从板端诊断配置的 83 次 PS 与 PL 比对出发，将共用输入、量化契约和缺项检测写为通用 CSV 校验流程。包内合成样例已运行，通过、数值差异与缺项、格式错误分别验证退出码 0、1、2。83 次为既有项目证据，未用新脚本重跑原始板端数据。

测量证据复核从采集与发布速率的区别、纹理不足引起的无效帧和名义标定的限制提炼。机电装配复核从 V17 打印清单和实物照片中的可见连接与遮挡处提炼。两项以既有项目材料人工回读验证，适用边界分别为证据口径与装配文档审核。跨项目应用时需替换数据和接口契约。
