quanxian318/jianwei-vibrometer/skill/measurement-evidence/SKILL.md

---
name: measurement-evidence
description: Audit measurement and throughput claims against dated raw records, validity flags, and calibration status.
---

## 适用与使用

用于视觉或传感器报告。输入原始日志、版本、统计窗口、有效性规则、标定记录和待审核正文。把下列提示词与资料一起交给模型，并人工复查证据定位。

> 逐条输出主张、指标所属环节、统计窗口与单位、有效性判据、证据位置和可支持的改写。将采集速率与发布速率分列。将无效样本单列并保留分母。把合成结果、标称值、实测值分别标记。记录缺失时写待验证，并列出缺少的输入。

## 项目案例与边界

采集帧率与深度发布速率分别统计。离线平坦纹理样例用于检查无效测点处理，尺标比例用于核对像素与毫米换算。按样例回读采样、波形与标定字段，并与对应记录逐项比对。

方法源于帧率混用、纹理不足及名义标定证据不足。换项目时沿用证据表，判据和单位按各自仪器定义。缺少原始时间戳、配置或标定记录时只能复核主张口径，不能重算性能或确认物理精度。
