quanxian318/jianwei-vibrometer/hardware/schematics/carrier_schematic.pdf

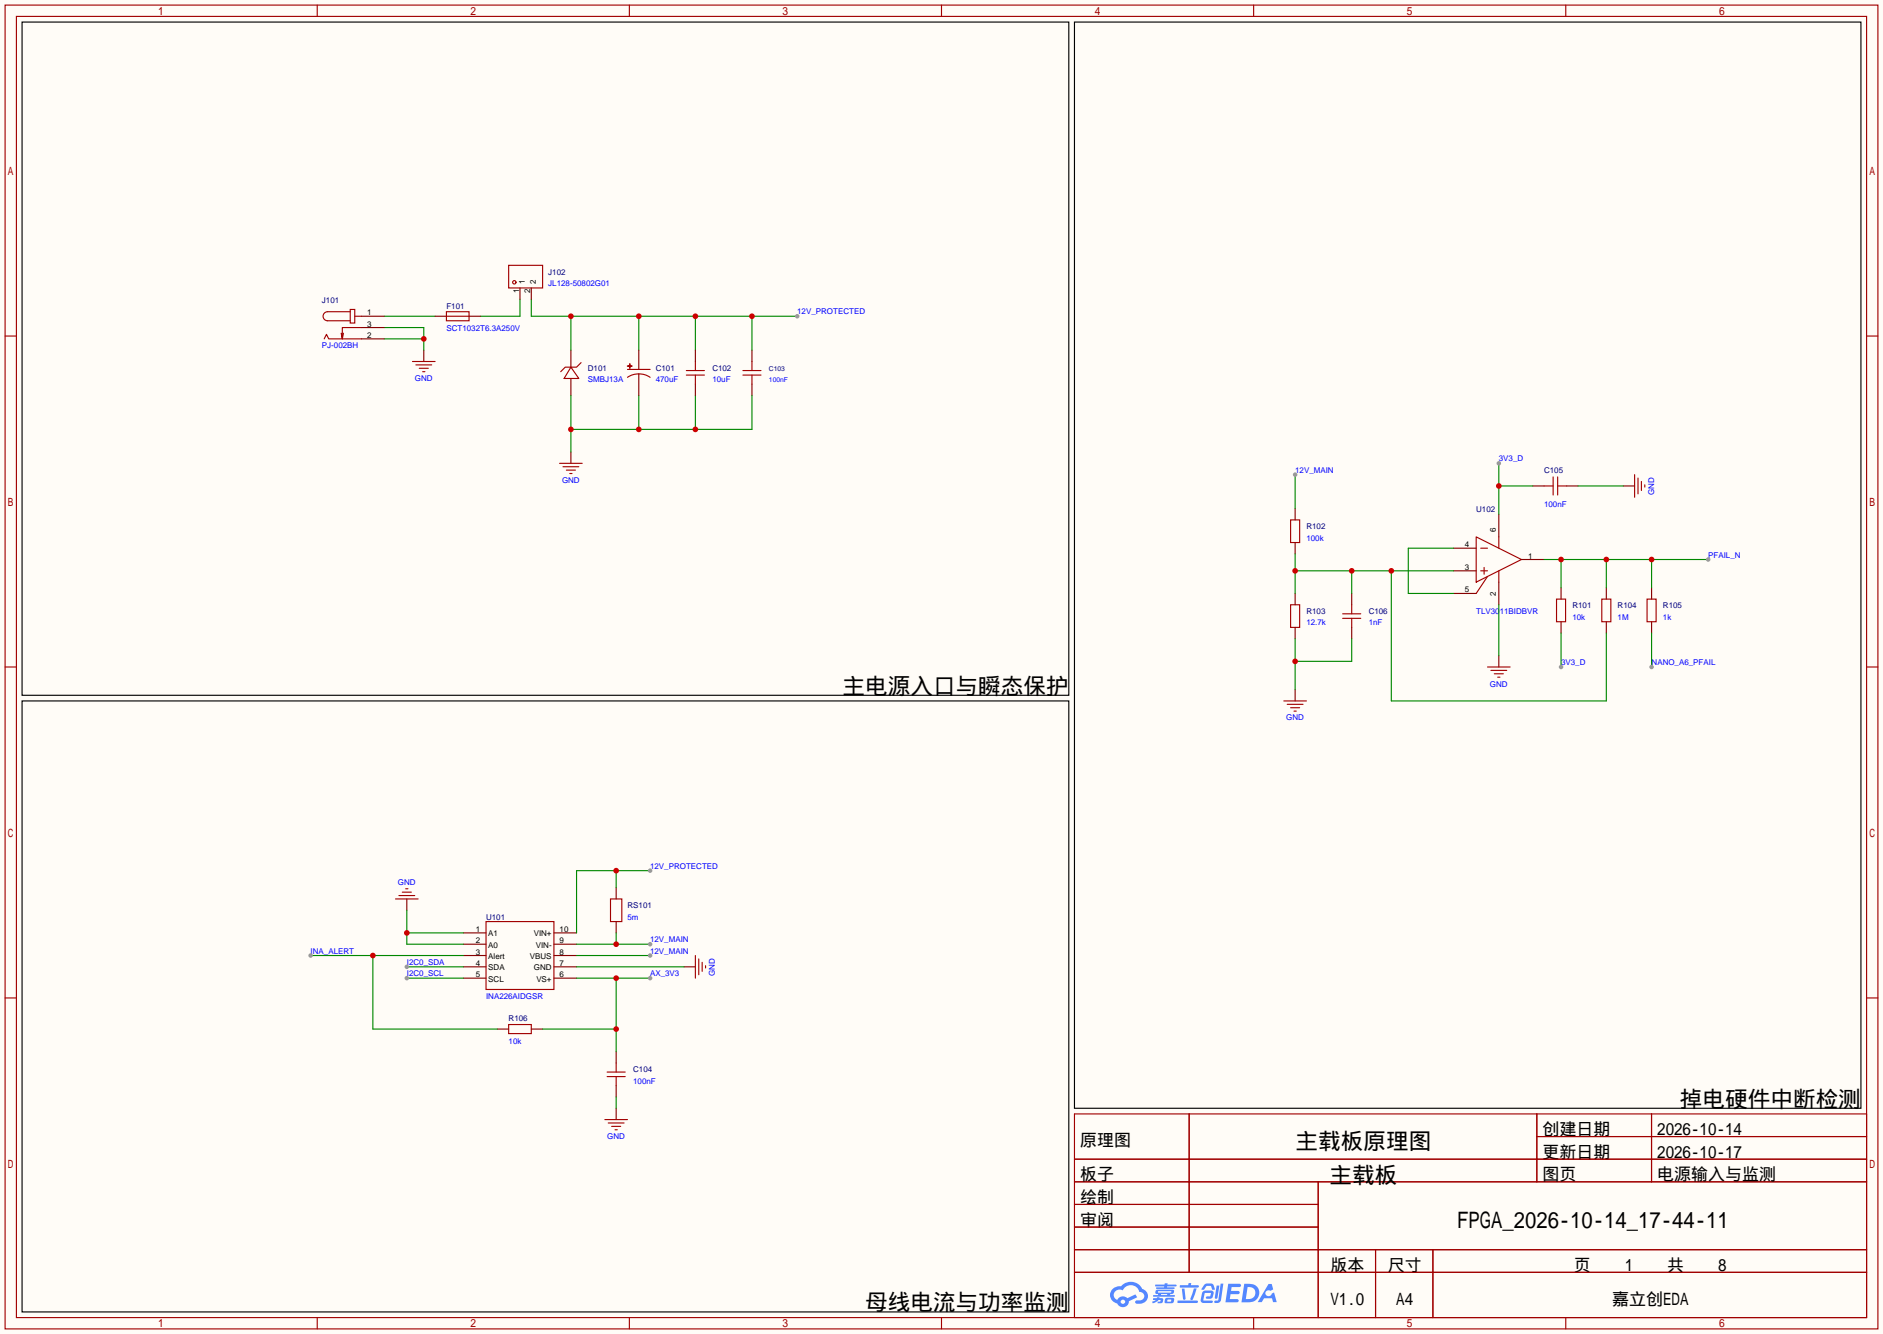
[picture p164: page 1]

原理图 | 主载板原理图 | 创建日期 | 2026-10-14

更新日期 | 2026-10-17

板子 | 主载板 | 图页 | 电源输入与监测
绘制 | | FPGA_2026-10-14_17-44-11
审阅

V1.0 | A4 | 嘉立创EDA

AX7010供电口 | Nano ESP32供电与保护支路

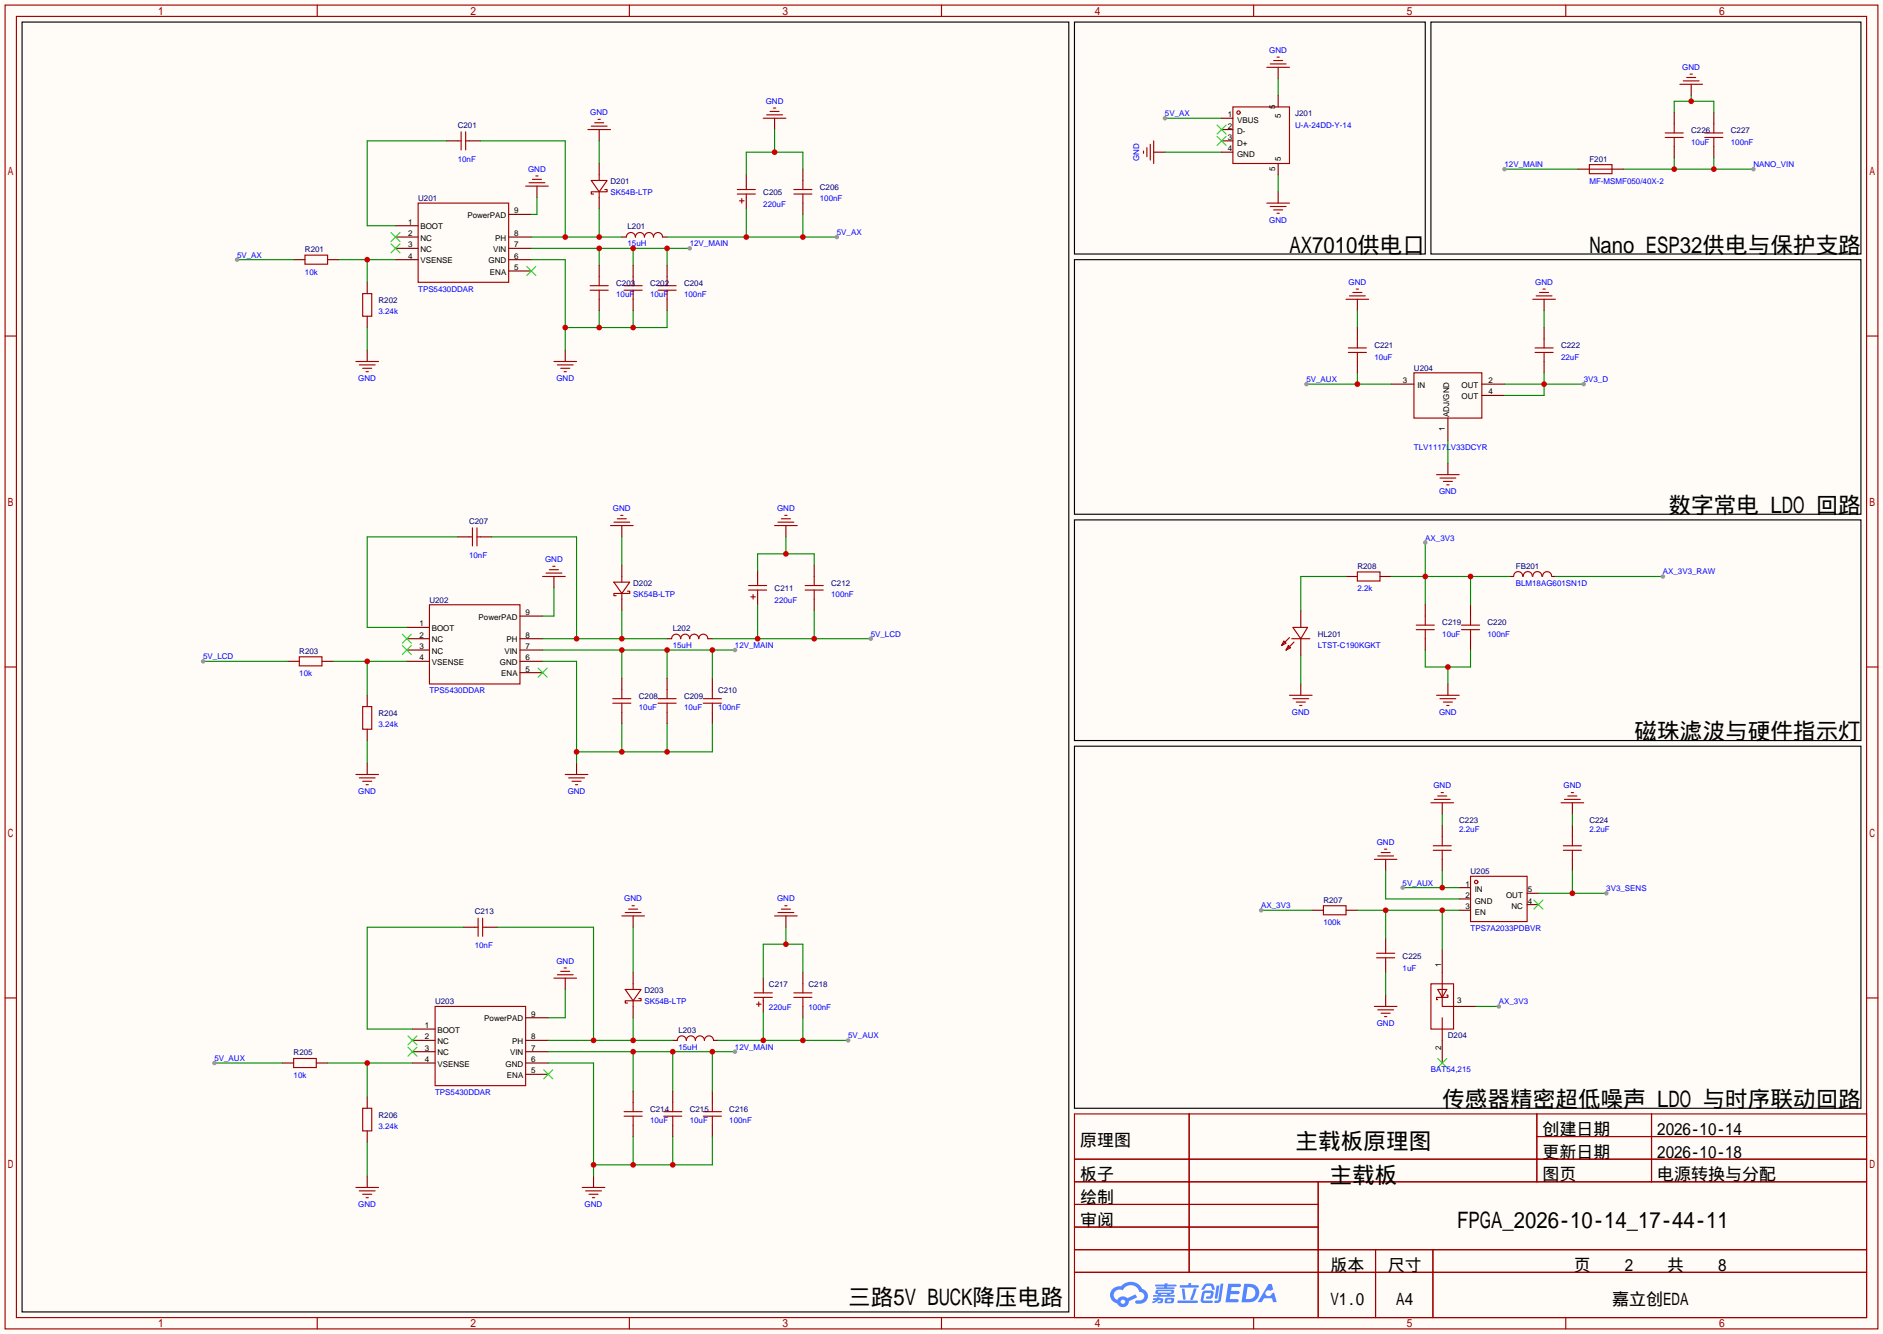
[picture p165: page 2]

原理图 | 主载板原理图 | 创建日期 | 2026-10-14

更新日期 | 2026-10-18

板子 | 主载板 | 图页 | 电源转换与分配
绘制 | | FPGA_2026-10-14_17-44-11
审阅

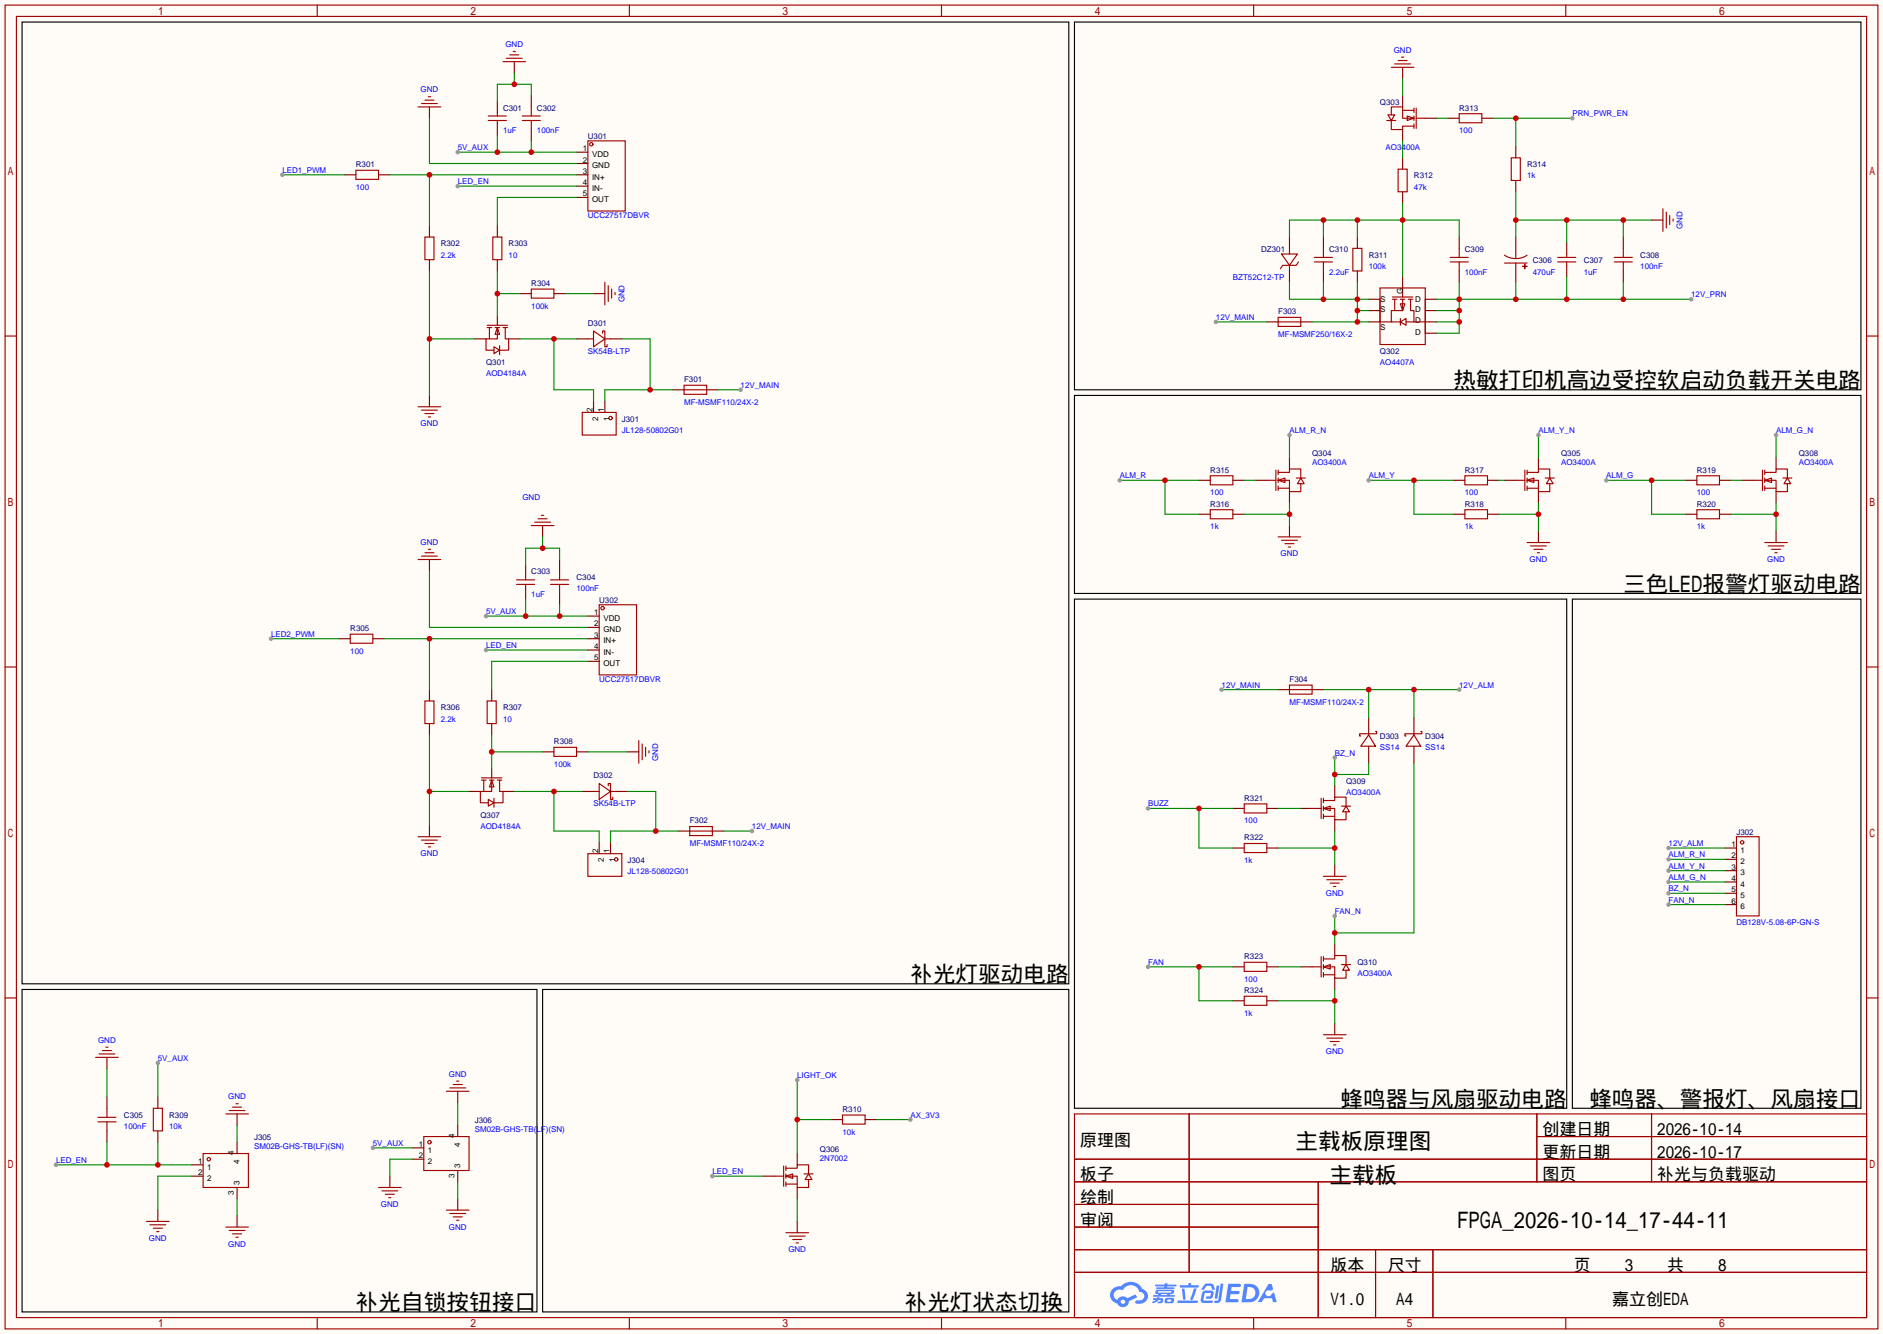
[picture p166: page 3]

GND
蜂鸣器与风扇驱动电路 蜂鸣器、警报灯、风扇接口

SM02B-GHS-TB(LF)(SN)

原理图 | 主载板原理图 | 创建日期 | 2026-10-14

更新日期 | 2026-10-17

板子 | 主载板 | 图页 | 补光与负载驱动
绘制 | | FPGA_2026-10-14_17-44-11
审阅

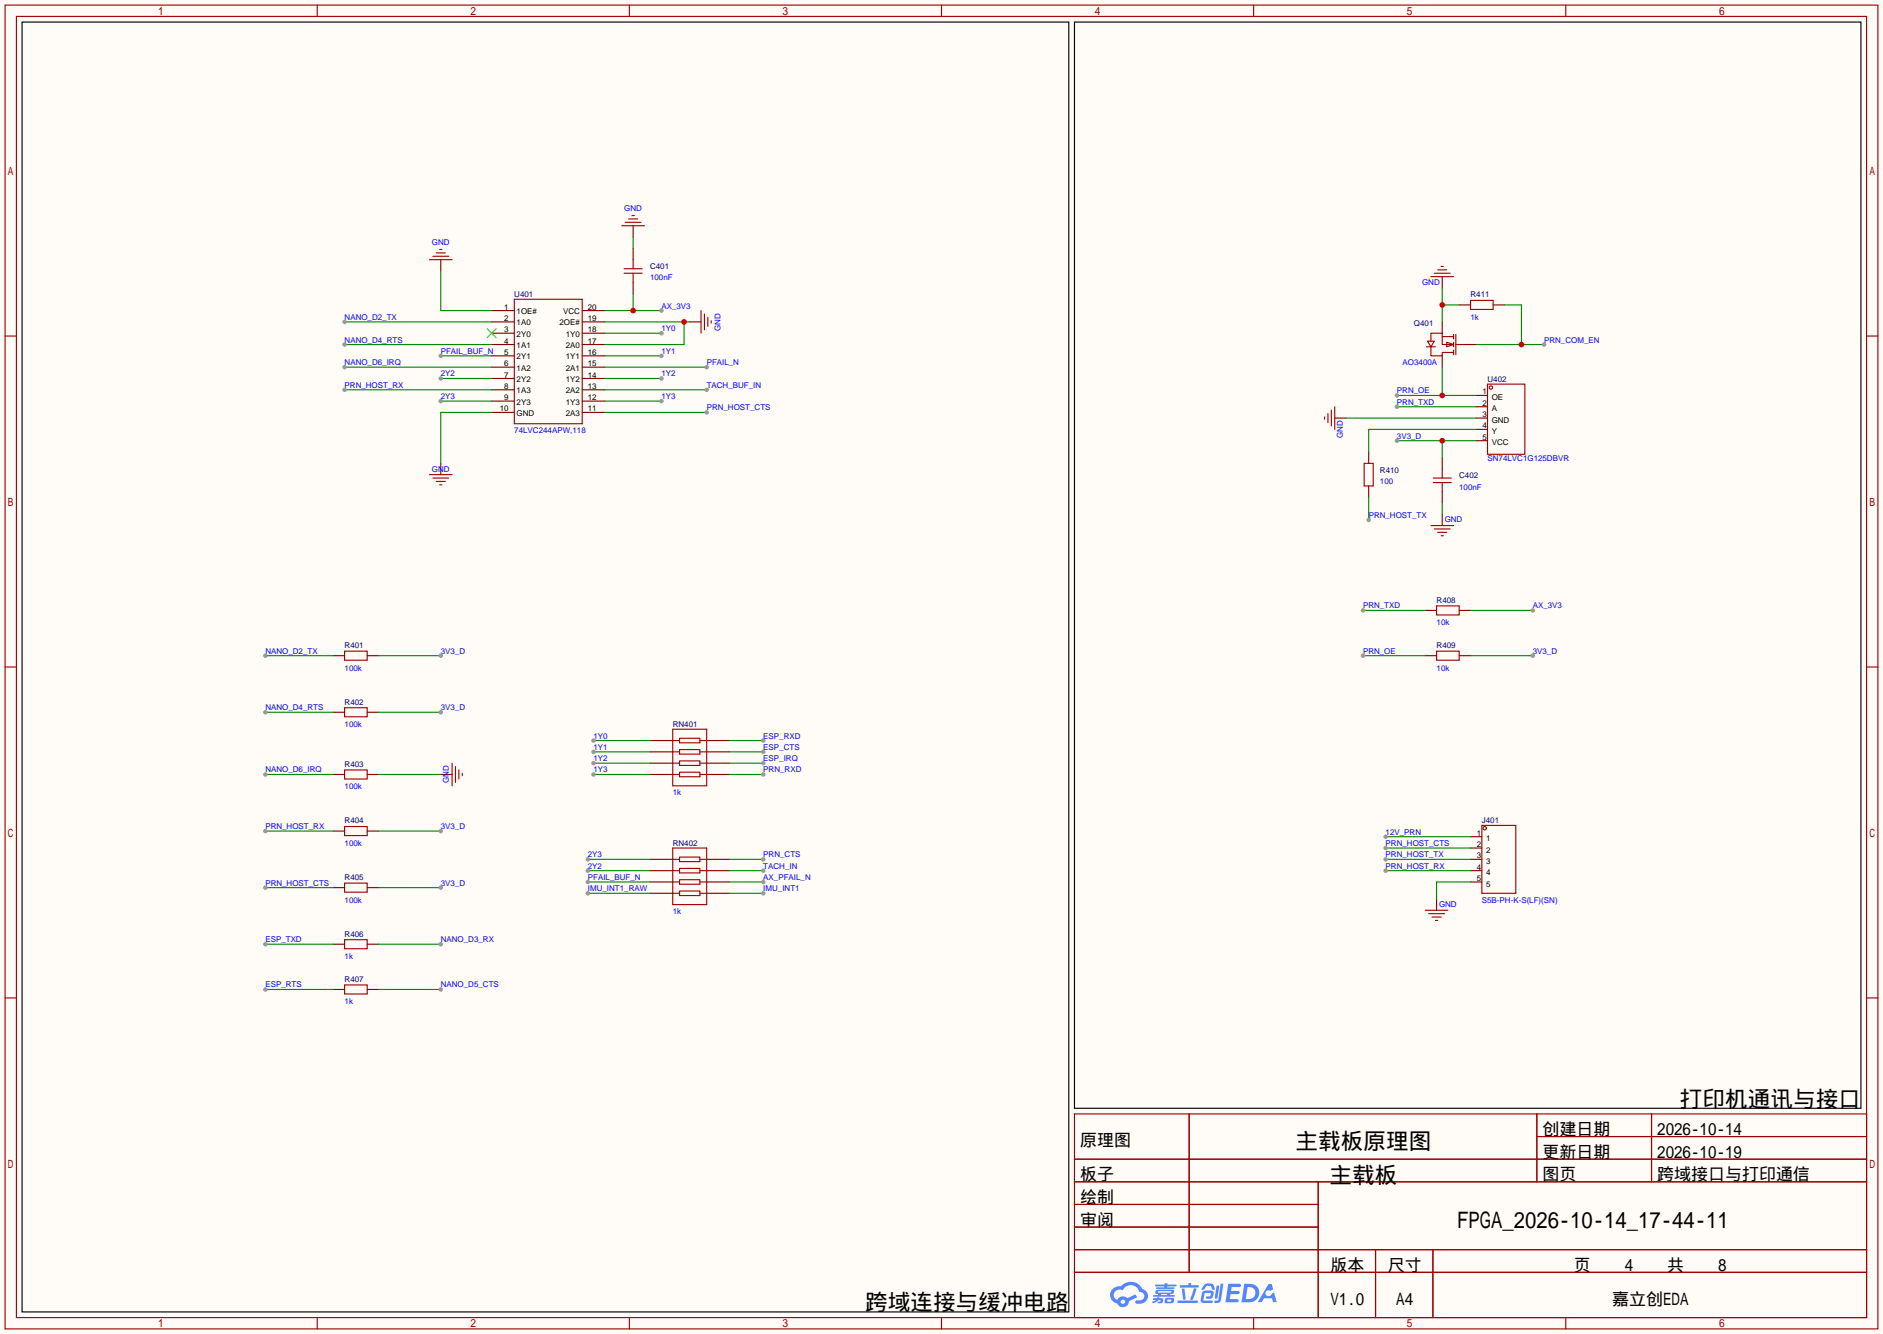
[picture p167: page 4]

原理图 | 主载板原理图 | 创建日期 | 2026-10-14

更新日期 | 2026-10-19

板子 | 主载板 | 图页 | 跨域接口与打印通信
绘制 | | FPGA_2026-10-14_17-44-11
审阅

# 屏幕供电接口

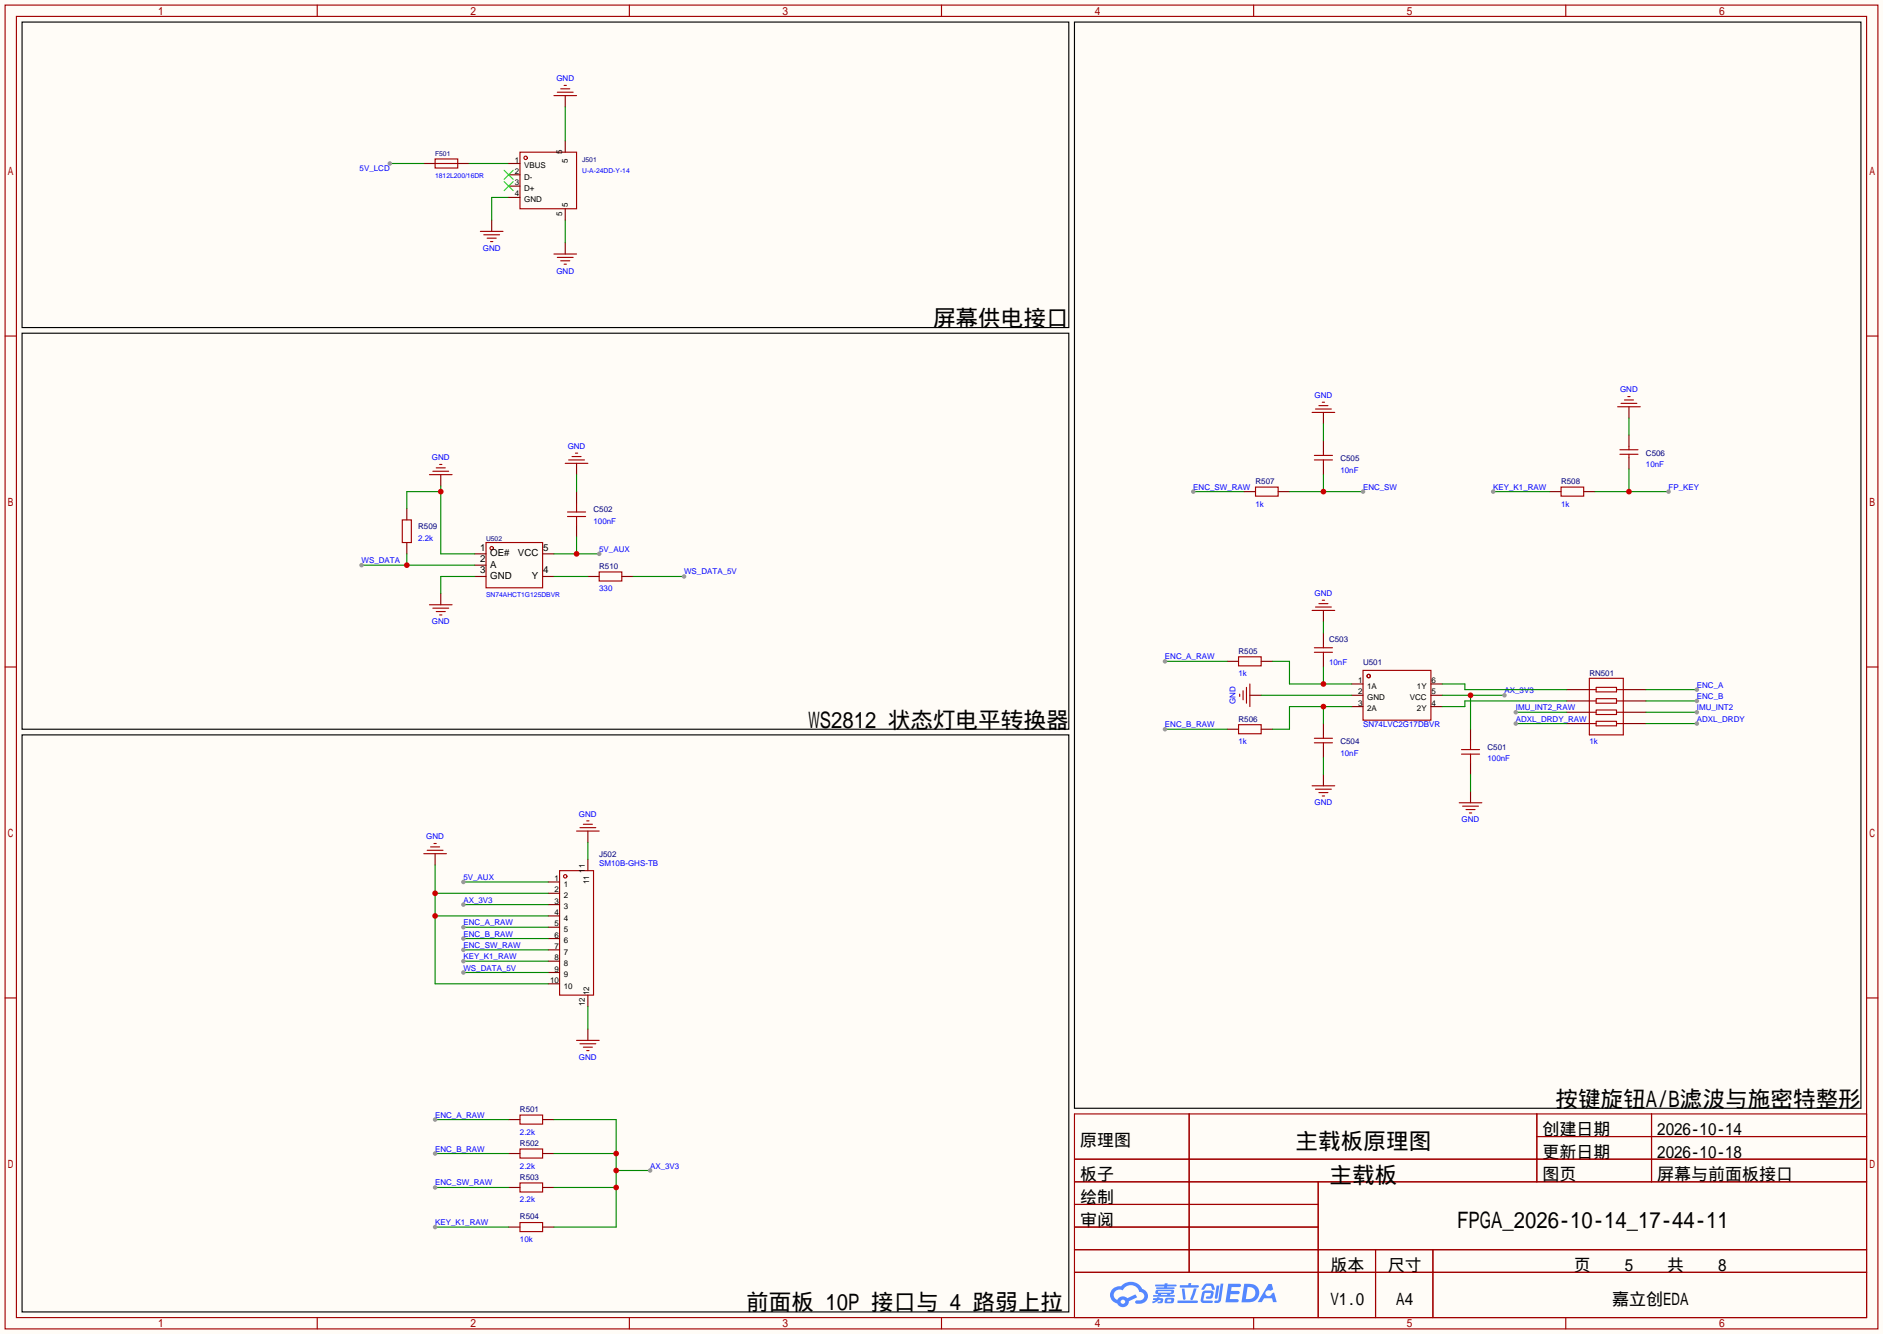
[picture p168: page 5]

原理图 | 主载板原理图 | 创建日期 | 2026-10-14

更新日期 | 2026-10-18

板子 | 主载板 | 图页 | 屏幕与前面板接口
绘制 | | FPGA_2026-10-14_17-44-11
审阅

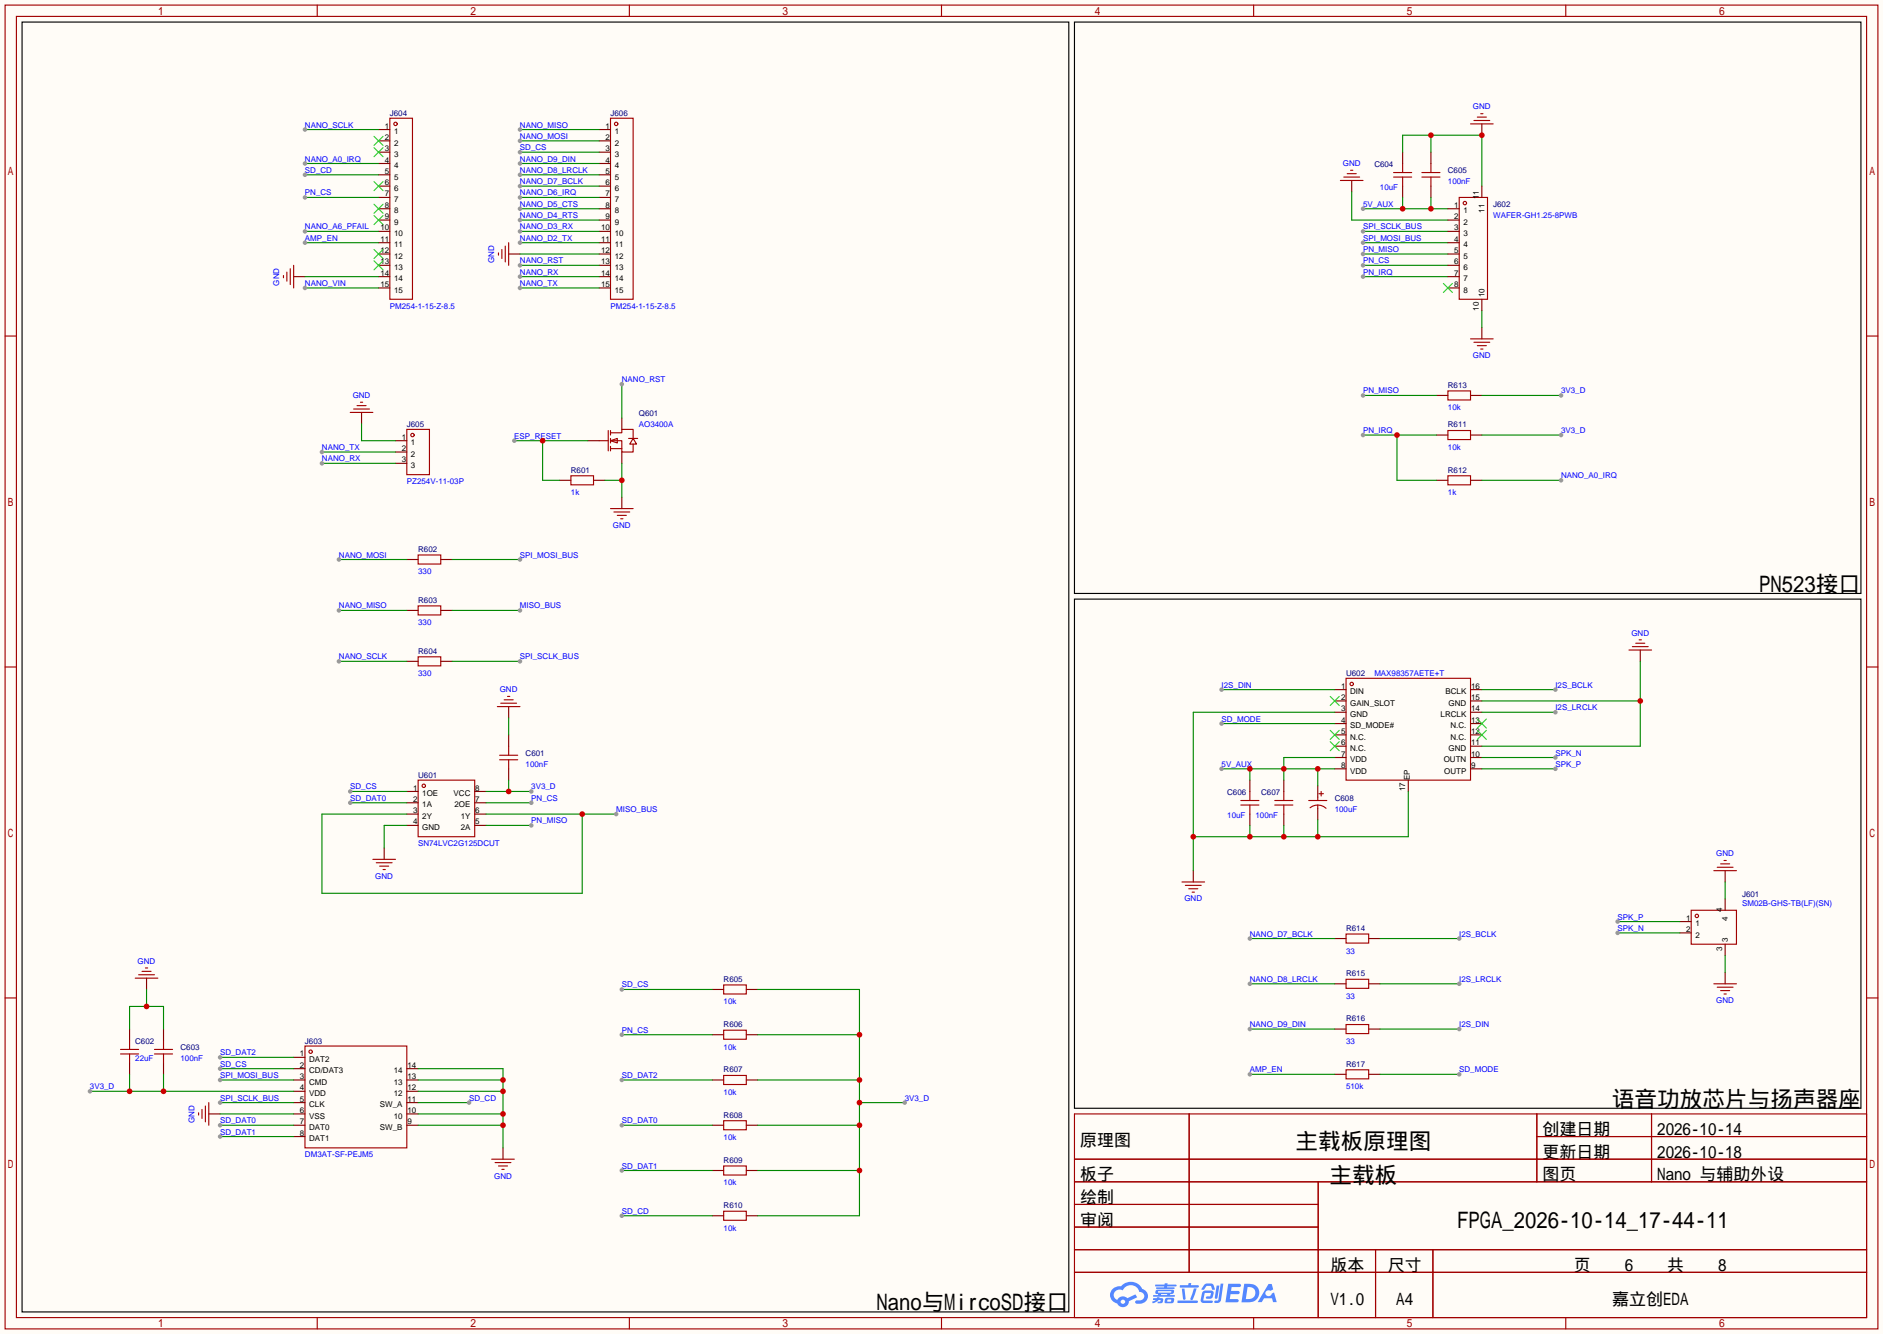
[picture p169: page 6]

SM02B-GHS-TB(LF)(SN)

原理图 | 主载板原理图 | 创建日期 | 2026-10-14

更新日期 | 2026-10-18

板子 | 主载板 | 图页 | Nano 与辅助外设
绘制 | | FPGA_2026-10-14_17-44-11
审阅

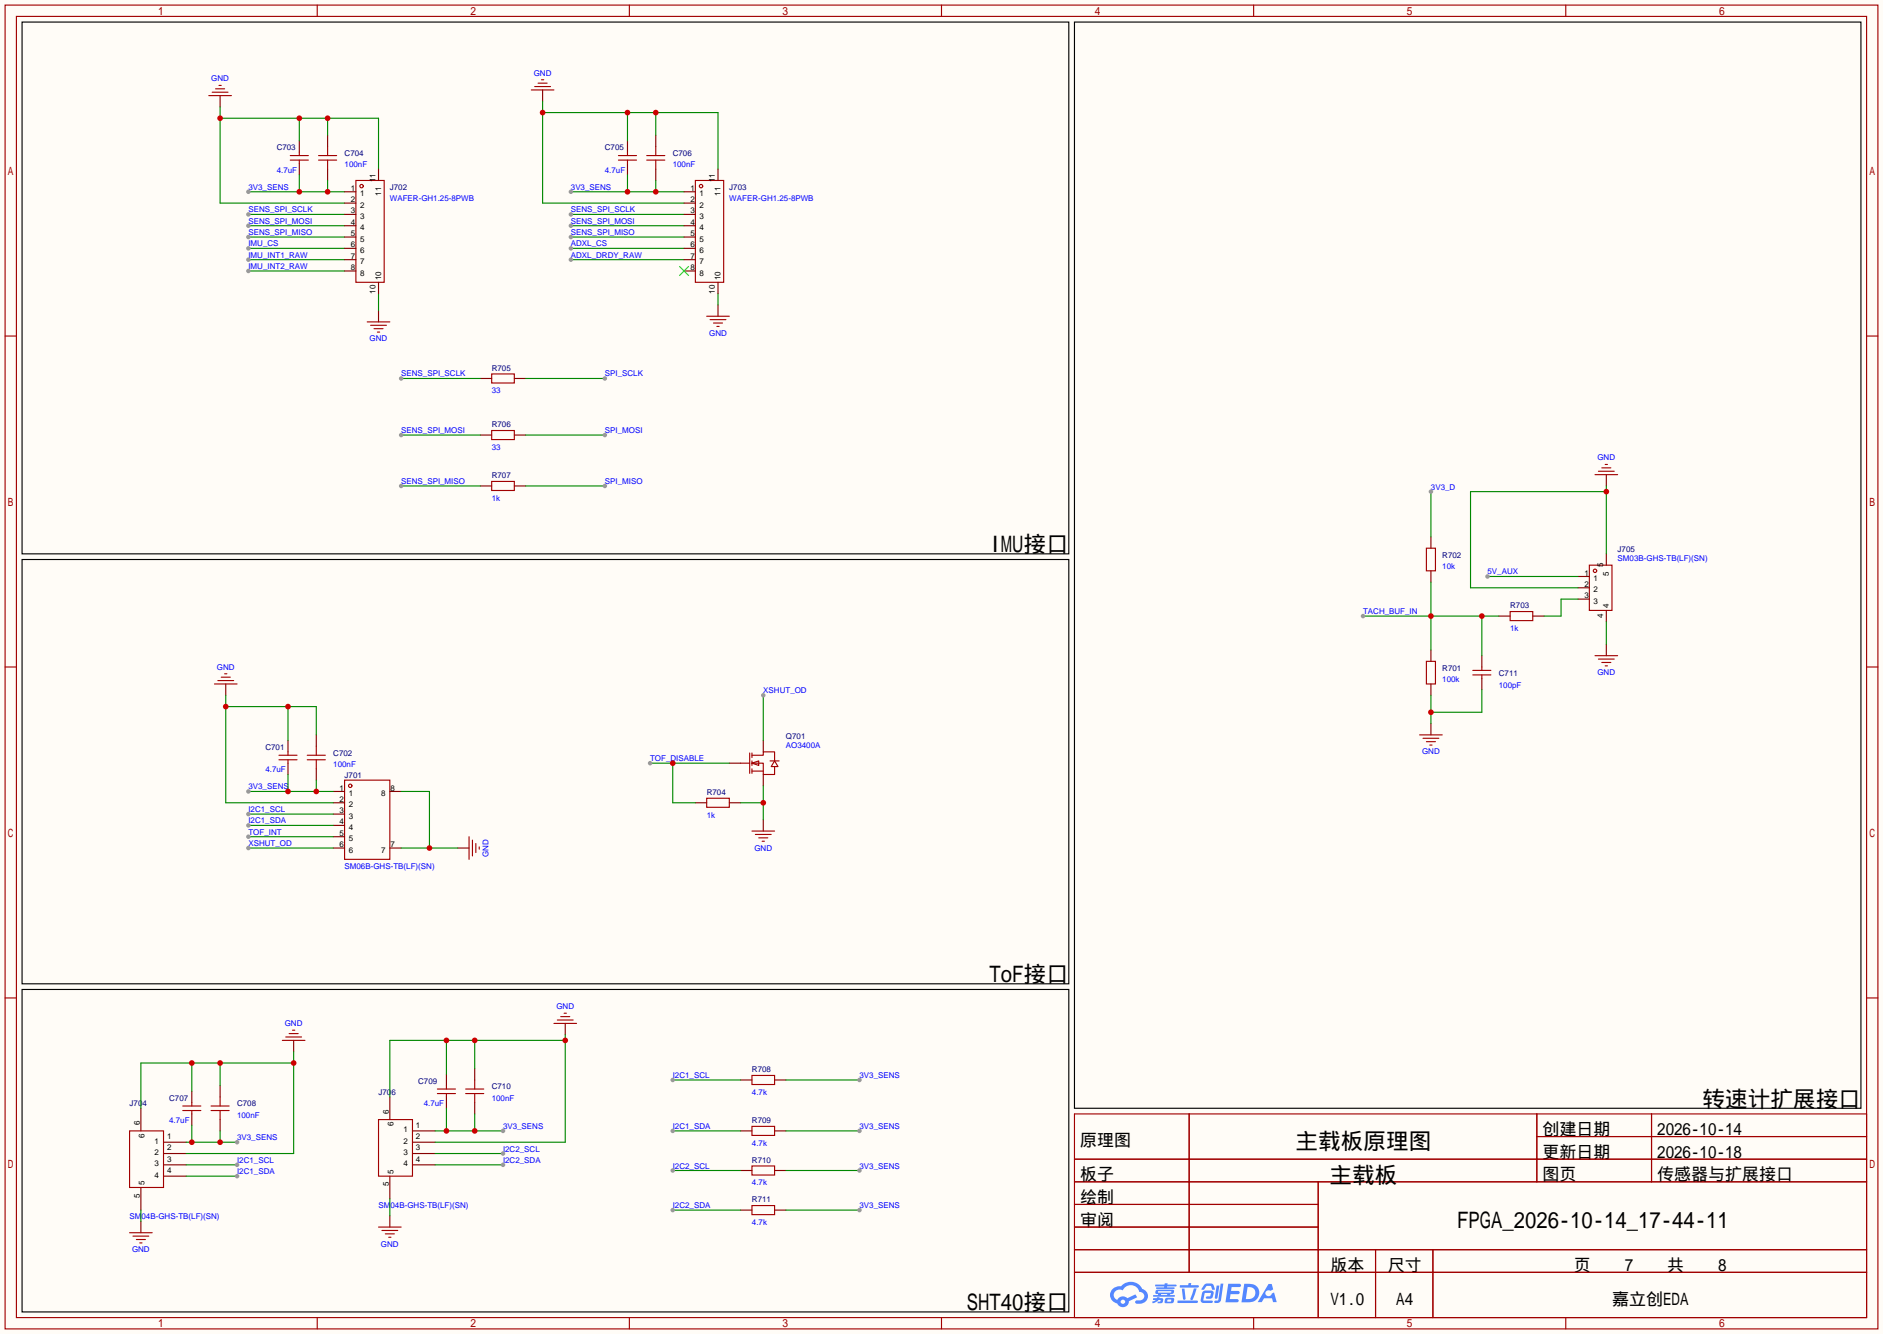
[picture p170: page 7]

原理图 | 主载板原理图 | 创建日期 | 2026-10-14

更新日期 | 2026-10-18

板子 | 主载板 | 图页 | 传感器与扩展接口
绘制 | | FPGA_2026-10-14_17-44-11
审阅

SM04B-GHS-TB(LF)(SN)

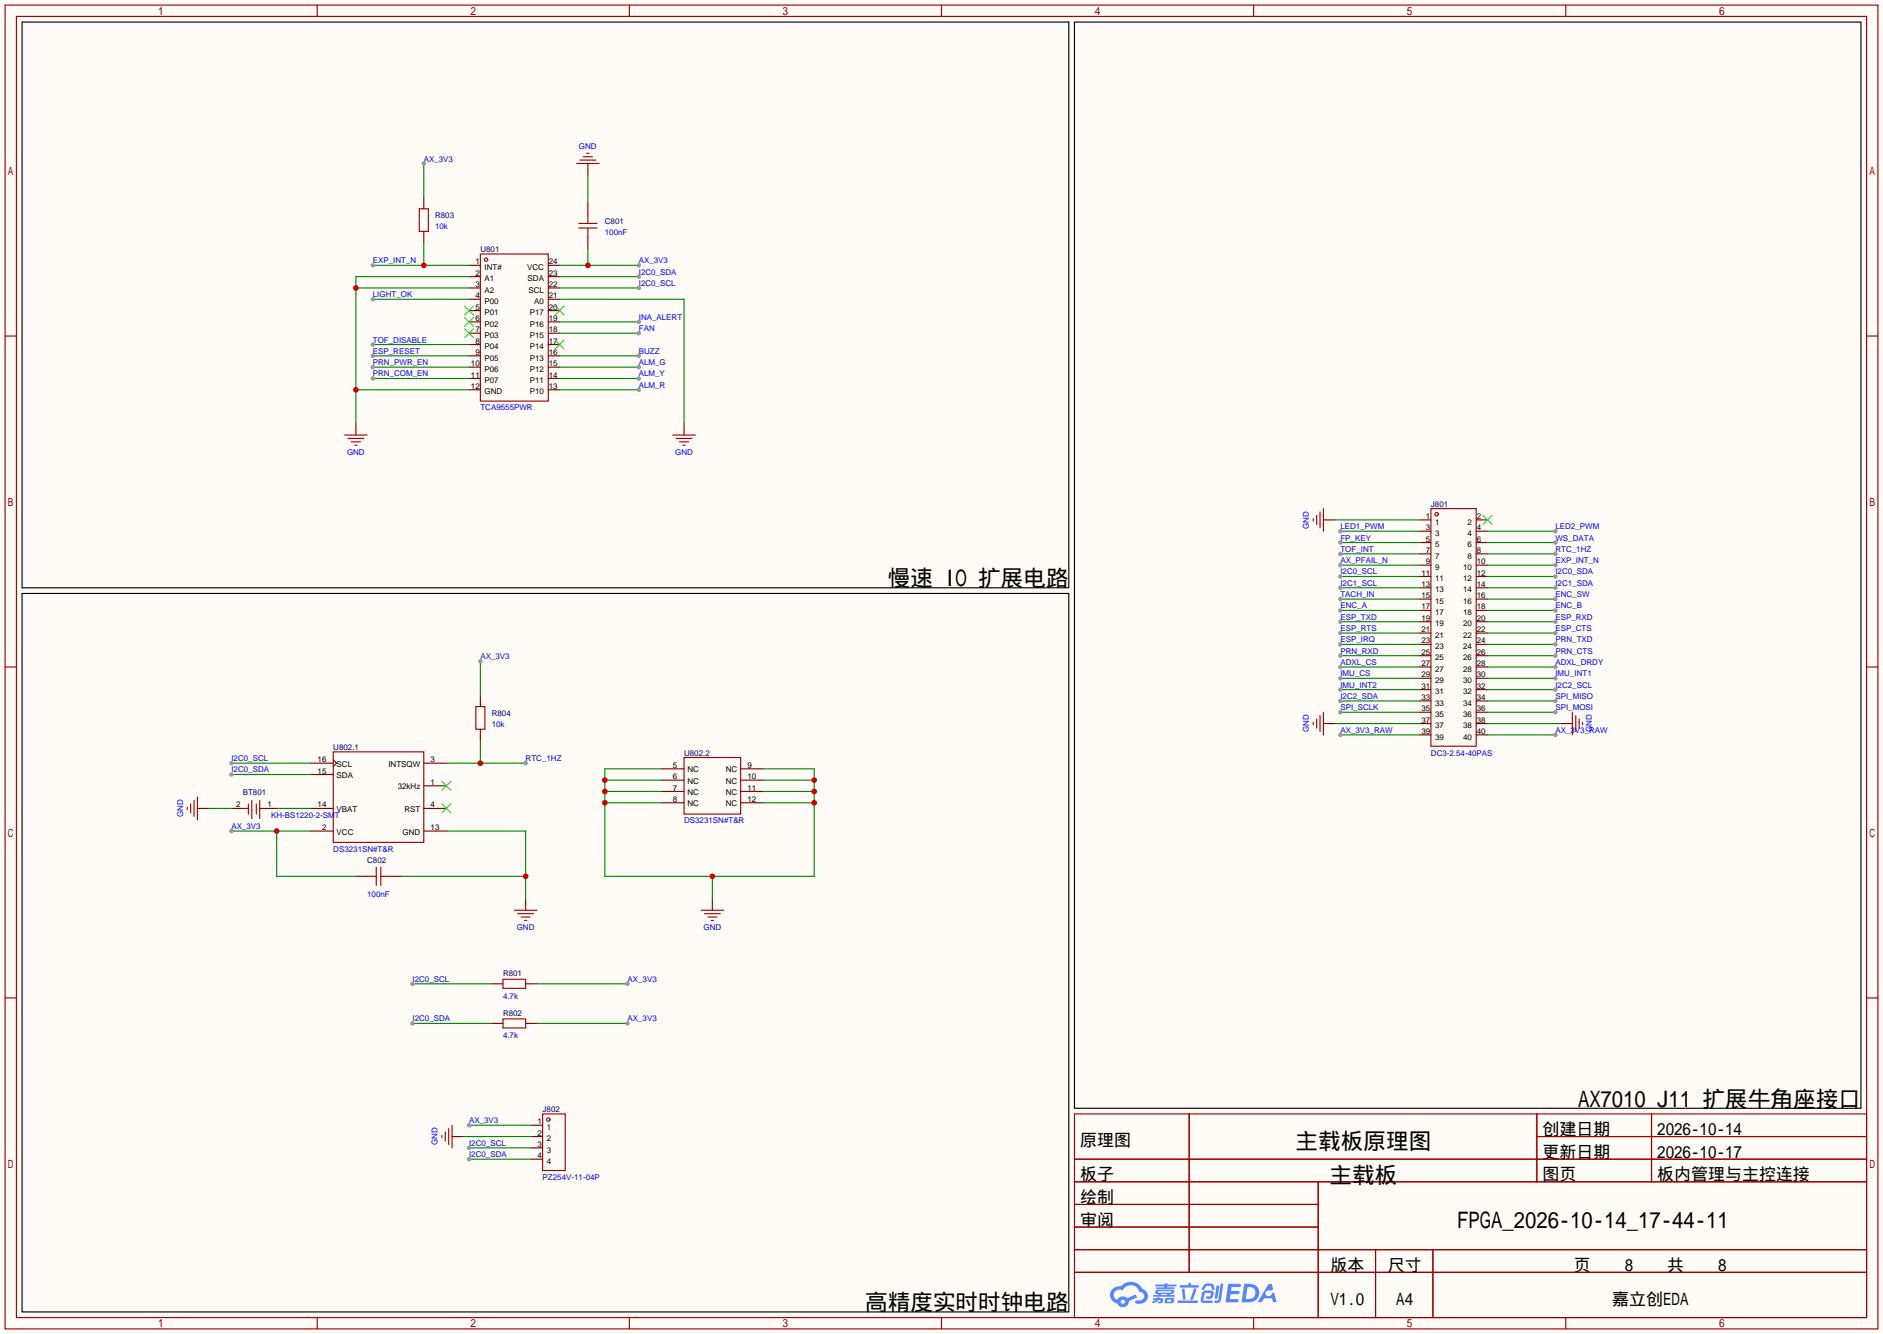
[picture p171: page 8]

原理图 | 主载板原理图 | 创建日期 | 2026-10-14

更新日期 | 2026-10-17

板子 | 主载板 | 图页 | 板内管理与主控连接
绘制 | | FPGA_2026-10-14_17-44-11
审阅
