quanxian318/jianwei-vibrometer/hardware/schematics/front_panel_schematic.pdf

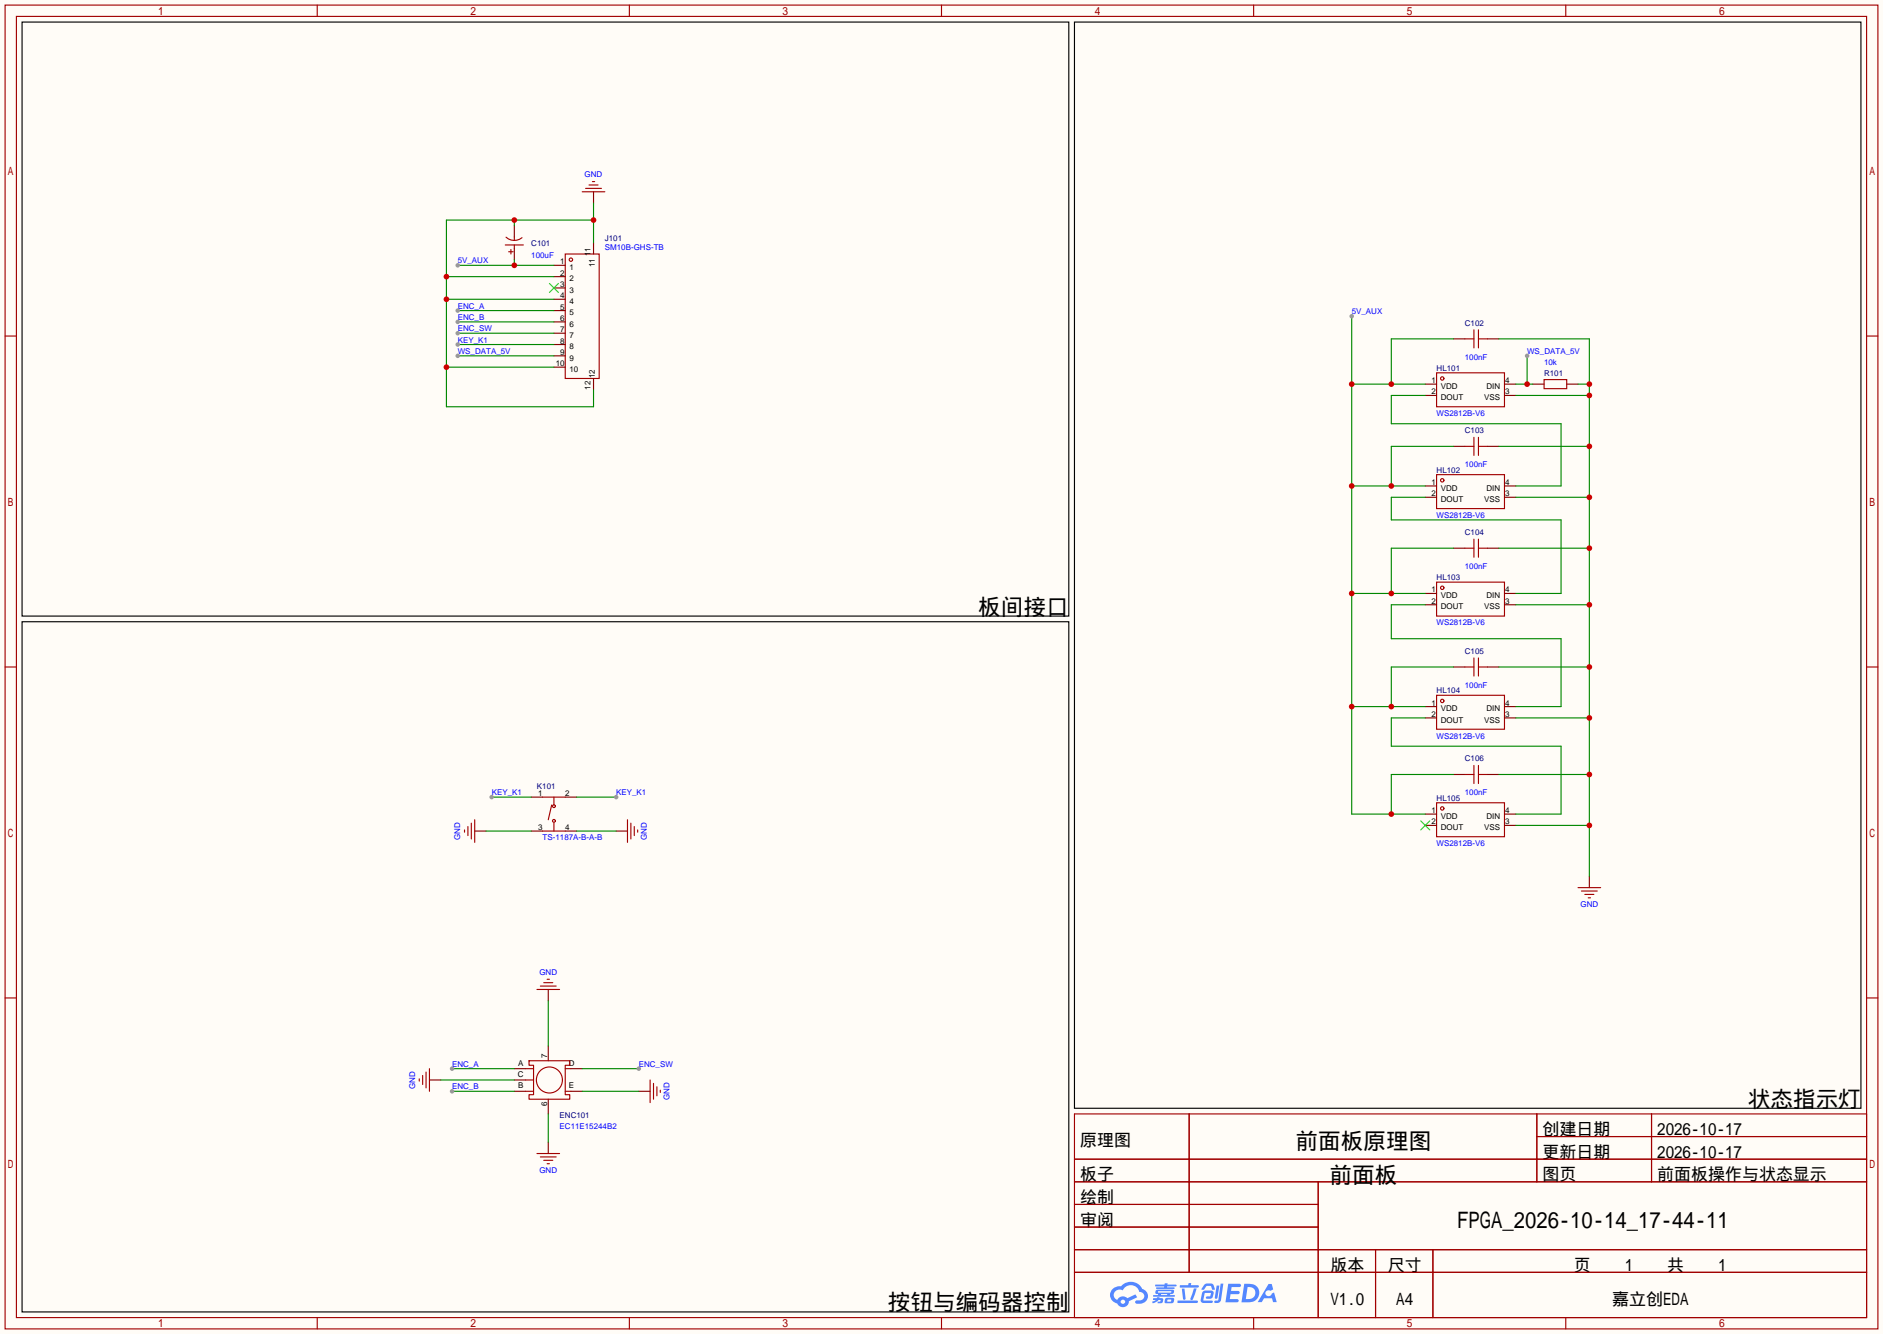
[picture p172: page 1]

原理图 | 前面板原理图 | 创建日期 | 2026-10-17

更新日期 | 2026-10-17

板子 | 前面板 | 图页 | 前面板操作与状态显示
绘制 | | FPGA_2026-10-14_17-44-11
审阅

V1.0 | A4 | 嘉立创EDA
