quanxian318/jianwei-vibrometer/src/ax7010/linux/vibmon/src/ui/demo_sensors.h

#pragma once

#include <unistd.h>

namespace vm {
// Presentation-only override. Never change SystemState, stored readings or alarms.
inline bool uiSensorDemoEnabled() {
  static const bool enabled = access("/root/vibmon_cam/ui_sensor_demo.enabled", F_OK) == 0;
  return enabled;
}
}  // namespace vm
