quanxian318/jianwei-vibrometer/(commit log)

2026-11-03 Prepare anonymous AMD competition submission
    [PRINT_01_Aligned_PC_Exits_Shell.stl, PRINT_02_Original_Alarm_Bracket_Lid.stl, PRINT_06_Module_M2_Spacers.STL, V17_02_Original_Alarm_Bracket_Lid.SLDPRT, V17_02_Original_Alarm_Bracket_Lid.step, V17_Alarm_Bracket_Envelope_REFERENCE.SLDPRT, V17_Installed_Estimate.SLDASM, V17_Installed_Estimate.step]
2026-11-04 Align report algorithms, navigation and integrated device documentation
2026-11-04 修复了一些文档描述问题
2026-11-04 更新作品视频
